KevinLalonde/Power_Selector/README.md

# Power_Selector
Ce circuit permet de pouvoir sélectionner quelle alimentation est envoyée au drone entre l'alimentation du sol et l'alimentation de la batterie
