KevinLalonde/Power_Selector/Rapports/ELE795_PresentationFinale.pdf

# PFE ELE795

Kevin Lalonde
Tristan Legault
Guyaume Morand

Conception d’un système d'alimentation continu pour drone Développé pour l’entreprise WINDO

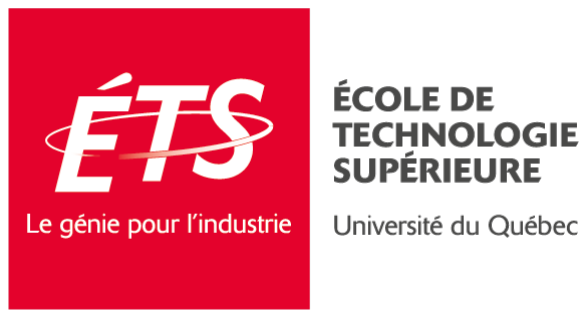
[picture p14: figure]

Département de génie électrique Supervisé par Jean-François Boland 9 août 2023

# Mise en contexte

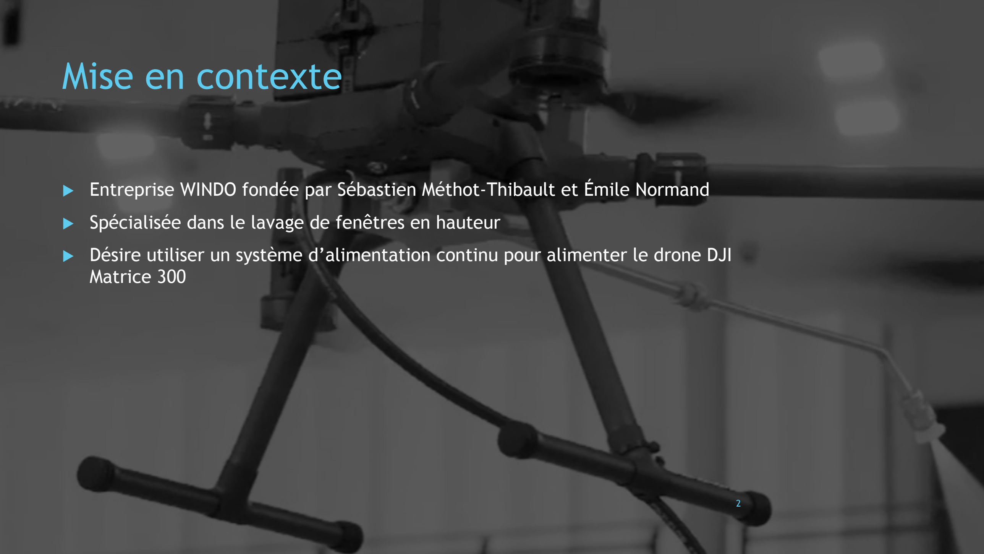
[picture p15: page 2]

u Entreprise WINDO fondée par Sébastien Méthot-Thibault et Émile Normand u Spécialisée dans le lavage de fenêtres en hauteur
u Désire utiliser un système d’alimentation continu pour alimenter le drone DJI Matrice 300

2

# Requis du système

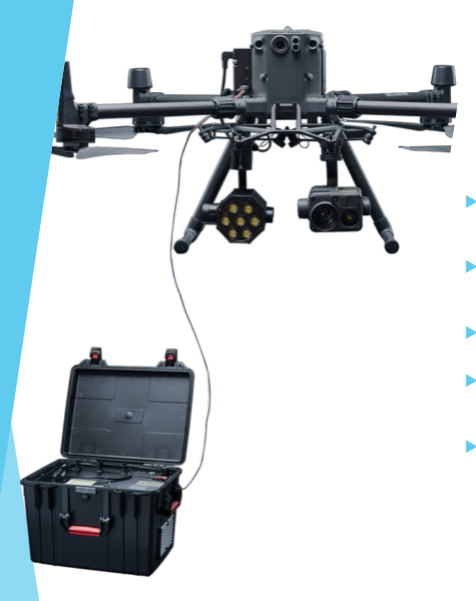
[picture p16: figure]

u Permet une distance d’opération de 100m de la borne d'alimentation au sol
u Doit être alimenté par les batteries en cas de perte d’alimentation du système
u Ajout de poids au drone le plus léger possible

u Coût du système moins élevé que les systèmes disponibles sur le marché
u Doit être alimenté sur le réseau électrique ou batteries avec onduleur (Tension d'entrée 120 à 240 VAC)

3

# Schéma fonctionnel

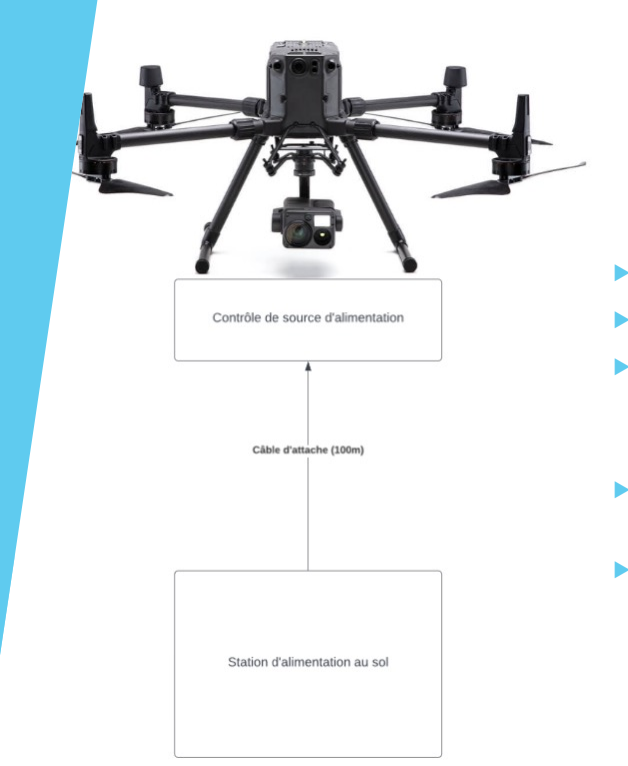
[picture p17: figure]

u Borne d'alimentation au sol
u Câble d'attache au drone (100m) u Contrôle d'alimentation (Station d'alimentation ou batteries)

u Alimentation primaire : 120 à 240 VAC
u Conversion à 50 VDC pour l'alimentation du drone

4

# Évaluation des différentes options

u Alimentation en continu entièrement à partir du sol
u Demande en courant trop élevée
u Tension fournie devrait tenir en compte les pertes ohmiques u Faible efficacitée du transfert d'énergie
u Alimentation AC au sol et convertisseur AC/DC sur le drone
u Poids ajouté au drone trop élevé
u Câble requiert un calibre AWG 12 ou 14 qui ajoute beaucoup de poids u Densité de puissance faible

5

## Systèmes d’alimentation existants

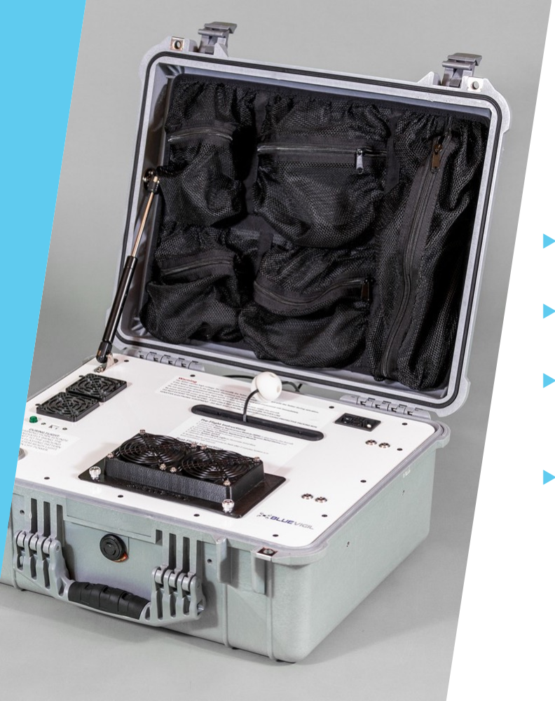
[picture p18: figure]

u Coût typique entre 10,000$ et 25,000$
u Très peu de documentation technique
u Convertisseur DC/DC 400VDC à 50VDC commun à la majorité des systèmes
u Exemple de système clé-en-main : Blue Vigil RS1000 Power Tether System

6

# Transport d'énergie

u Augmentation de la tension à 400 VDC
u Permet l'utilisation d'un câble de plus petit calibre afin de réduire le poids u Un plus petit courant réduit les pertes de puissance sur le long du câble

u Conversion 400 VDC à 50 VDC sur le drone
u Modules «BCM» existants permettent une très bonne densité de puissance u Fourni une alimentation stable au drone

7

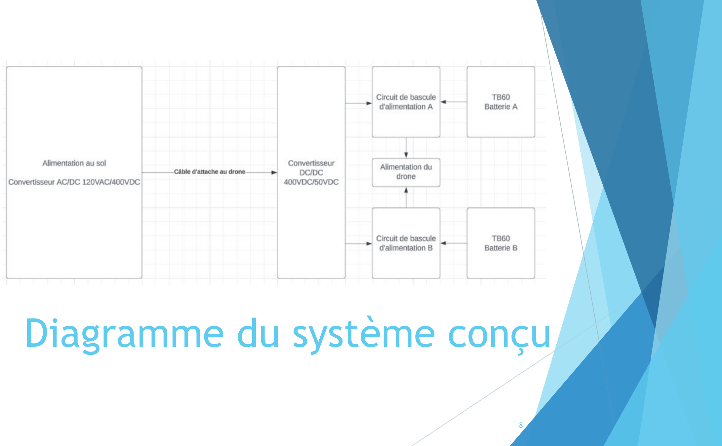
[picture p19: figure]
Diagramme du système conçu

# Rôle des

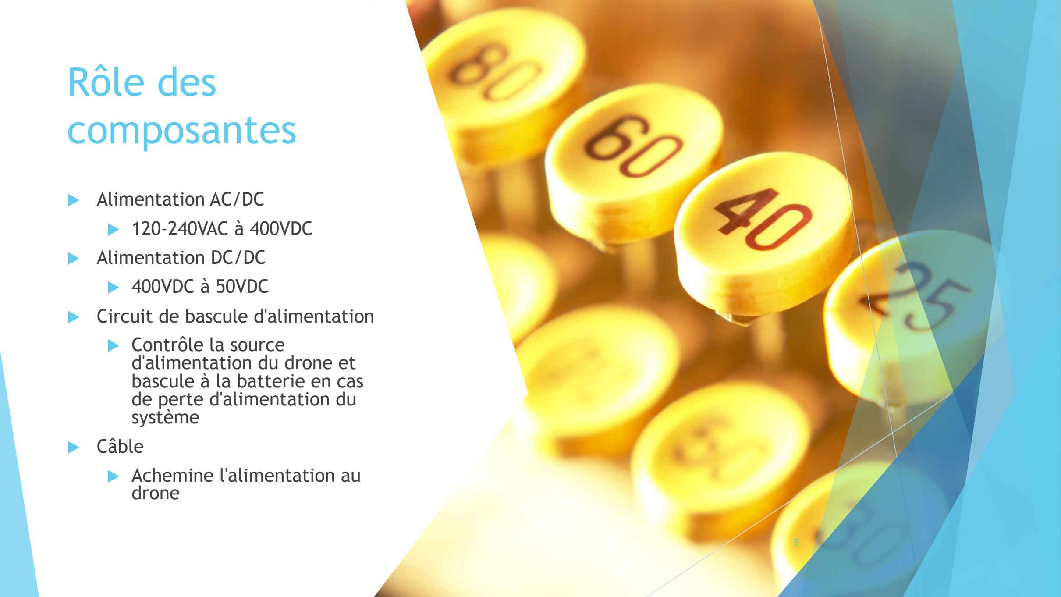
[picture p20: page 9]

composantes u Alimentation AC/DC u 120-240VAC à 400VDC u Alimentation DC/DC u 400VDC à 50VDC u Circuit de bascule d'alimentation u Contrôle la source

d'alimentation du drone et bascule à la batterie en cas de perte d'alimentation du système
u Câble u Achemine l'alimentation au

drone

9

# Alimentation AC/DC

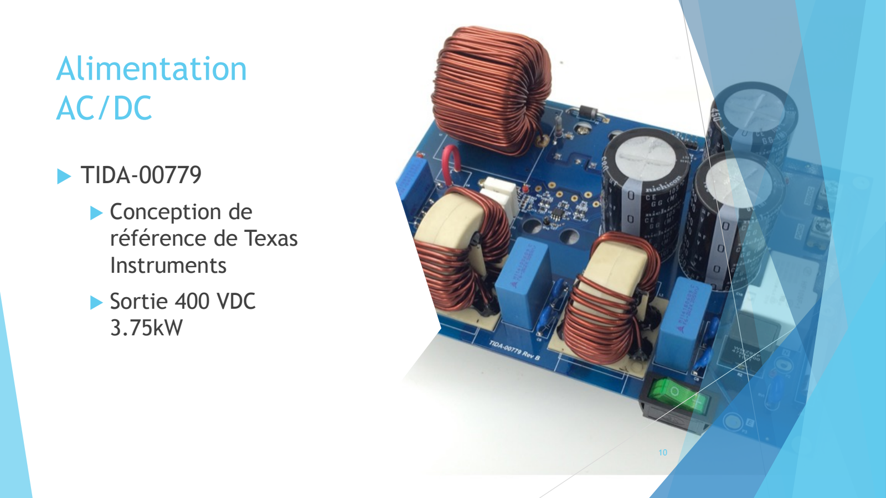
[picture p21: page 10]

## u TIDA-00779

## u Conception de référence de Texas Instruments u Sortie 400 VDC

3.75kW

10

# Alimentation DC/DC

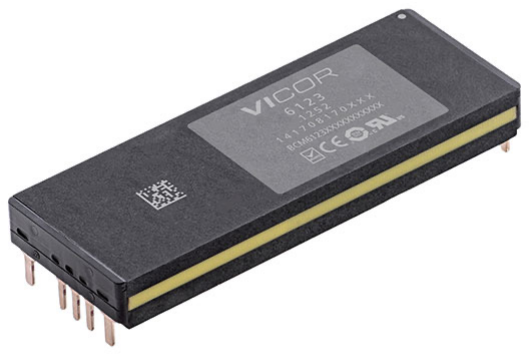
[picture p22: figure]

u Basée sur la
technologie «BCM» de
Vicor
u Entrée 400 VDC
u Sortie 50 VDC 1.75kW

11

# Circuit de bascule d'alimentation

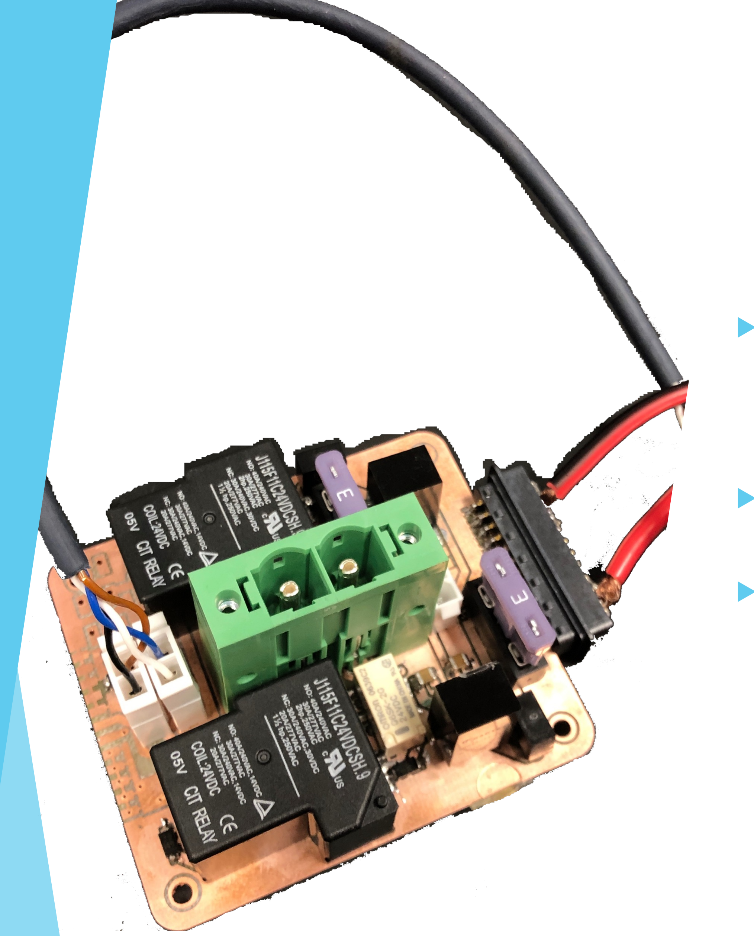
[picture p23: figure]

u Alimentation transférée à la batterie en permanence lors d’une perte d’alimentation du câble
u Bouton d’armament de
l’alimentation du câble au sol u Lumière indicatrice de perte d’alimentation

12

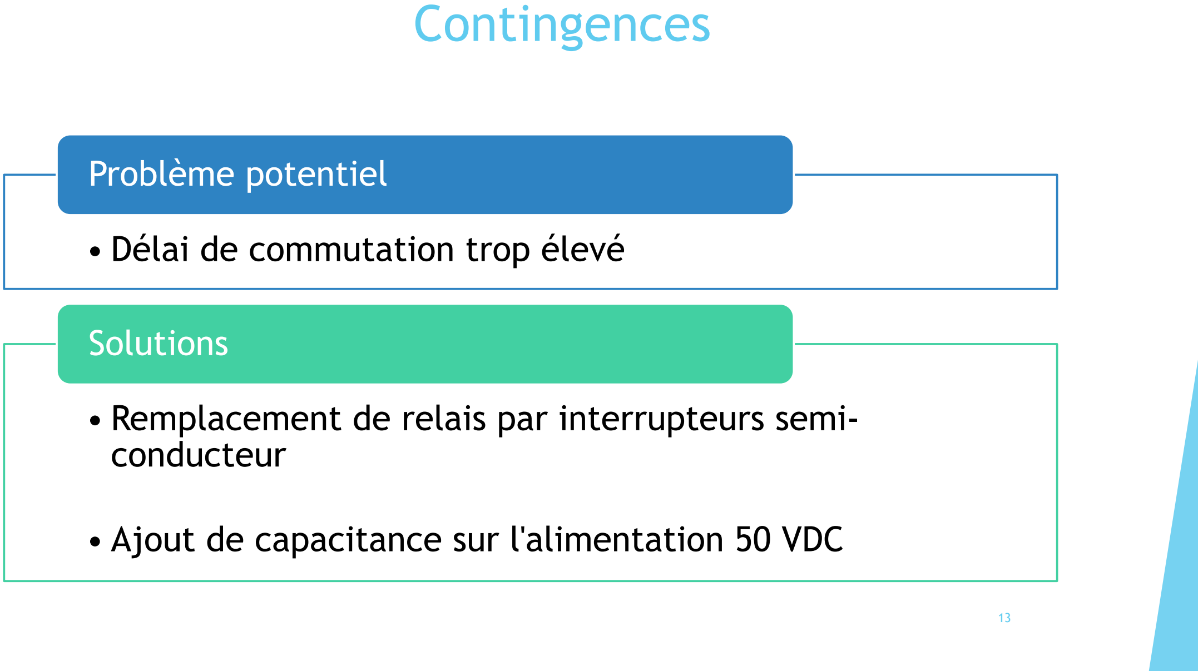
[picture p24: figure]
Contingences; • Délai de commutation trop élevé; Problème potentiel; conducteur; Solutions

## - Remplacement de relais par interrupteurs semi-

## - Ajout de capacitance sur l'alimentation 50 VDC

# Coût du système

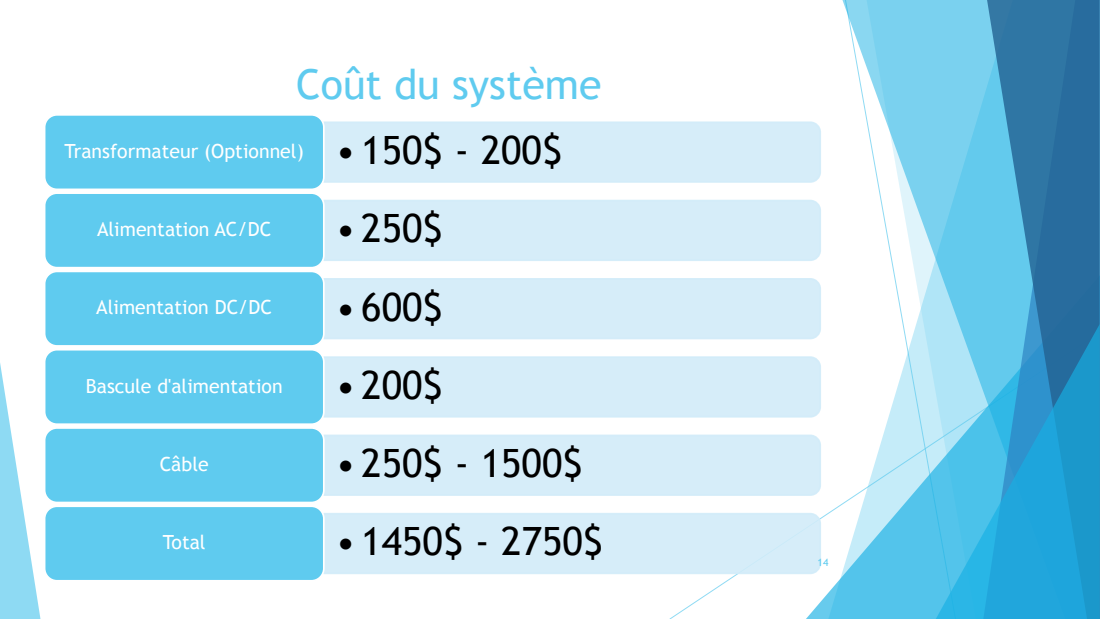
[picture p25: page 14]
Transformateur (Optionnel); Alimentation AC/DC; Alimentation DC/DC; Bascule d'alimentation; Câble; Total

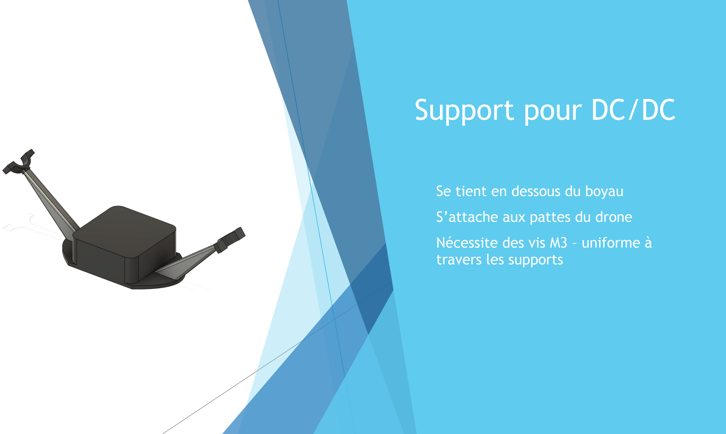
[picture p26: figure]
Support pour DC/DC; u Se tient en dessous du boyau; u S’attache aux pattes du drone; u Nécessite des vis M3 – uniforme à travers les supports

# Support pour bascule d’alimentation

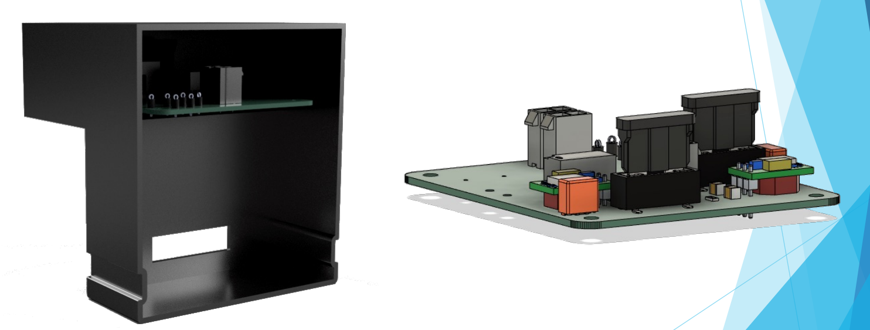
[picture p27: figure]

16

# Centre de gravité

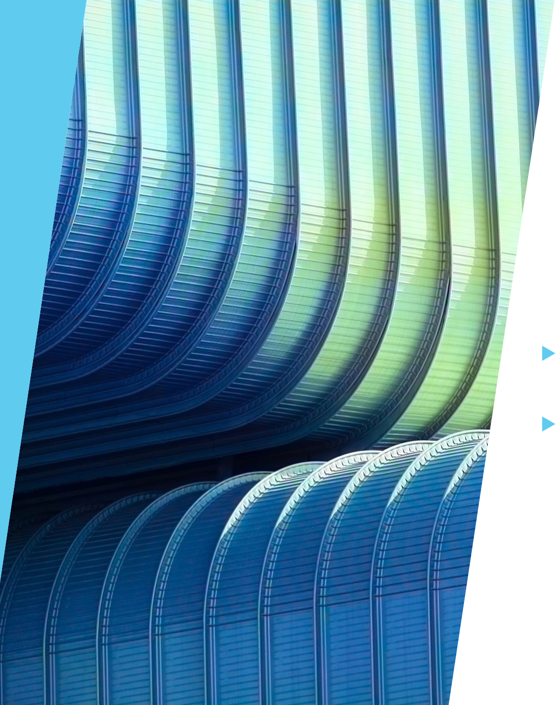
[picture p28: figure]

u Système conçu afin d'avoir un impact négligeable
u Boyau d'arrosage peut être ajusté afin de compenser au besoin

17

# Aperçu du système complet

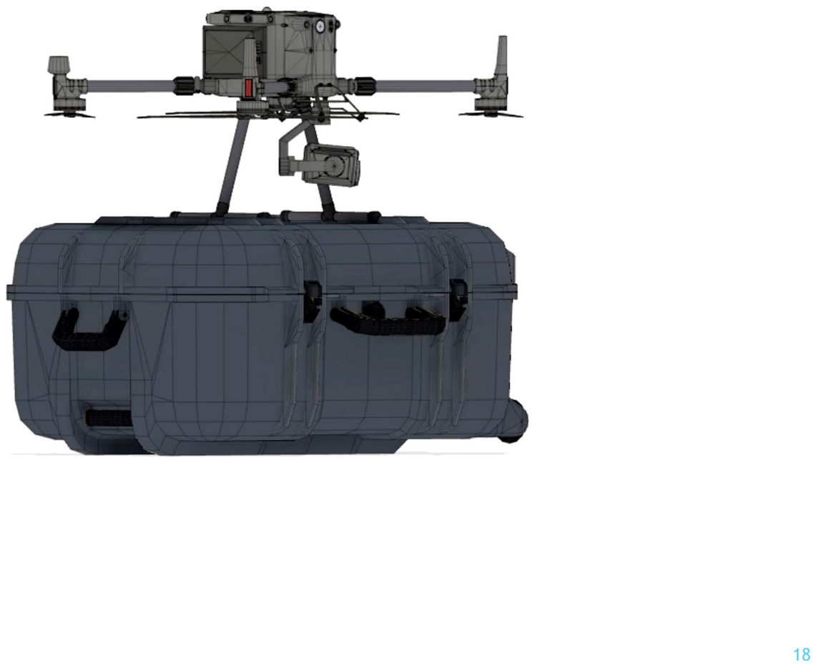
[picture p29: page 18]

18

# Éléments à valider pour l'implémentation finale

u Les connecteurs propriétaires
u L’alimentation du drone par déconnexion de la batterie du drone tout en gardant la communication
u La déconnexion temporaire de l’alimentation
u Le déplacement du centre de gravité du drone (par la batterie)
u Le système d’attache au drone

19

# Conclusion

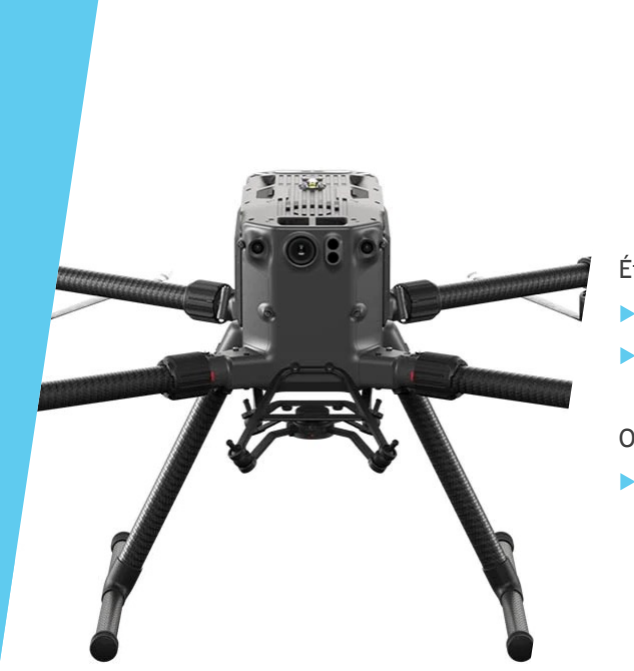
[picture p30: figure]

État du projet:
u Conception du système complétée u Validation du système à compléter

Observations:
u Peu de documentation sur les systèmes existants

20

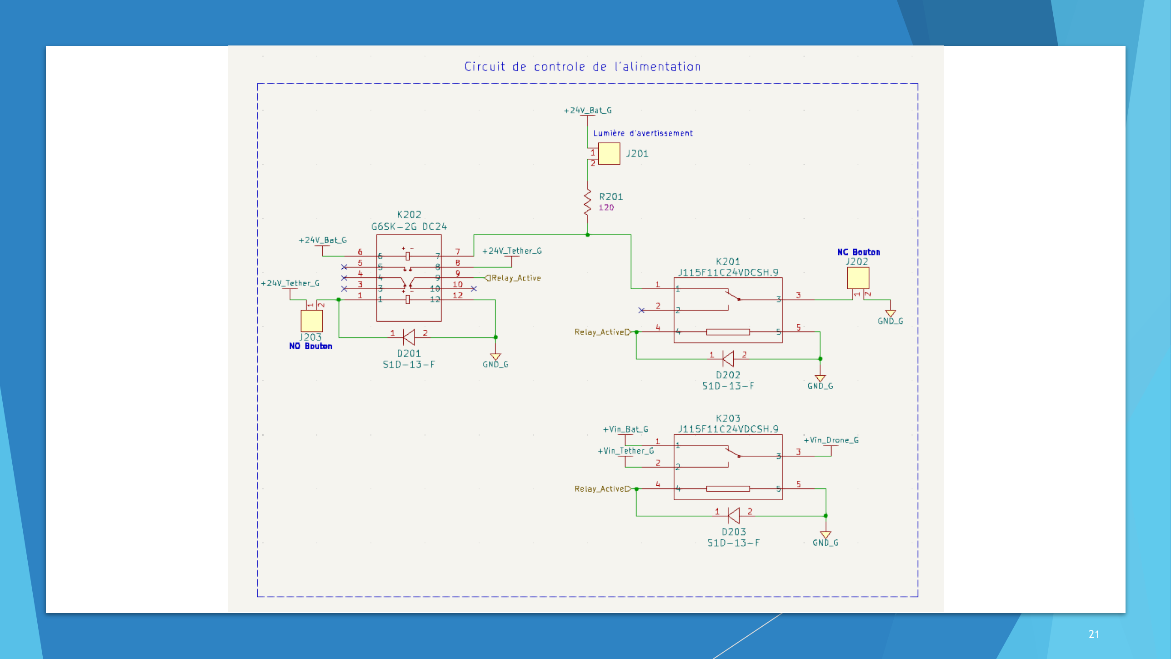
[picture p31: page 21]

21
