KevinLalonde/Power_Selector/KiCad_Library/3D_Model/Assembly/ACZ11BR4E.step

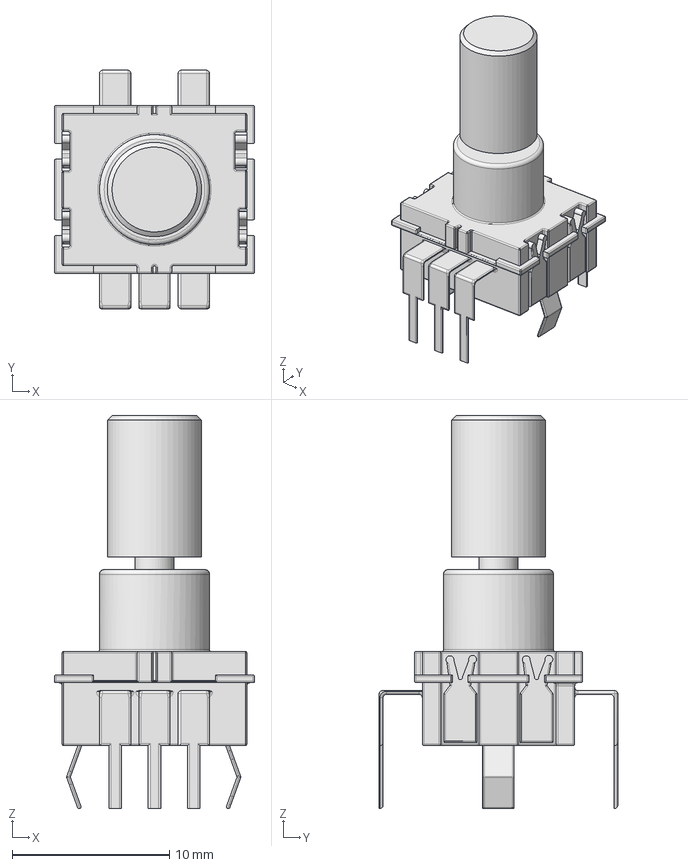
[picture p33: CAD file, 2023-07-19]
KiCad_Library/3D_Model/Assembly/ACZ11BR4E.step
12.8 x 15.2 x 25.0 mm
