KevinLalonde/Power_Selector/KiCad_Library/3D_Model/Capacitors/C1210.step

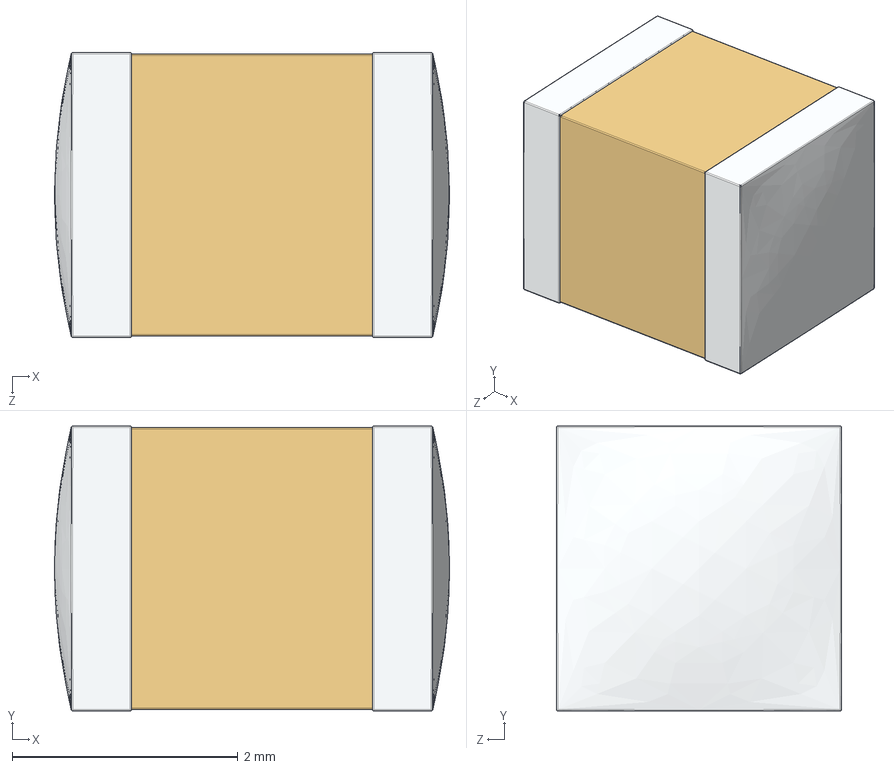
[picture p34: CAD file, 2023-07-19]
KiCad_Library/3D_Model/Capacitors/C1210.step
3.50 x 2.52 x 2.53 mm
