KevinLalonde/Power_Selector/KiCad_Library/3D_Model/Crystals/TXC 7A Series.step

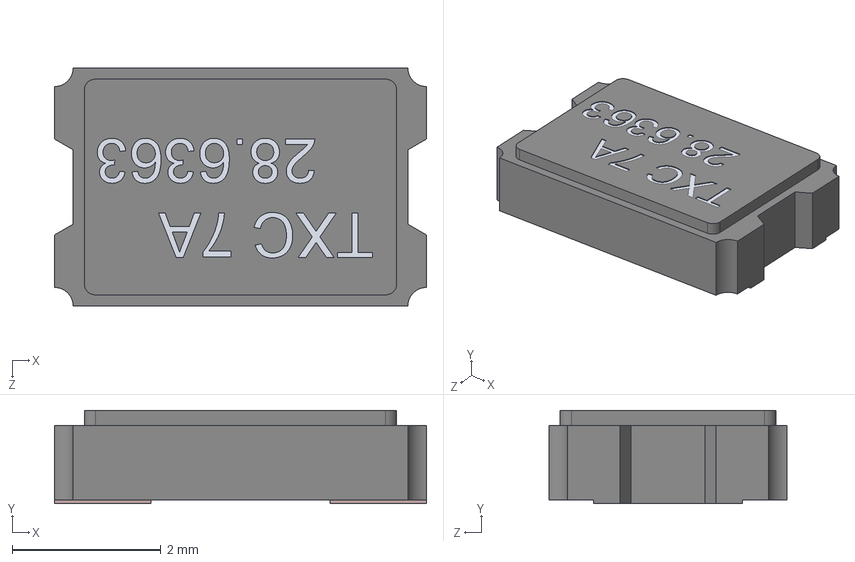
[picture p35: CAD file, 2023-07-19]
KiCad_Library/3D_Model/Crystals/TXC 7A Series.step
5.00 x 1.25 x 3.20 mm
