KevinLalonde/Power_Selector/KiCad_Library/3D_Model/Diodes/SOT143-4L.stp

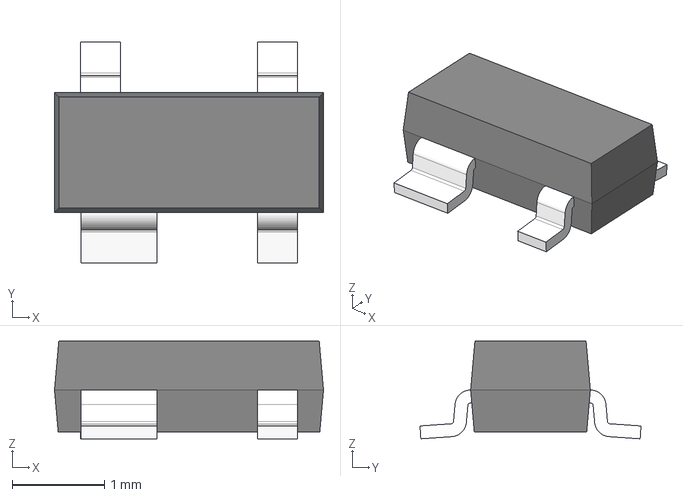
[picture p36: CAD file, 2023-07-19]
KiCad_Library/3D_Model/Diodes/SOT143-4L.stp
2.92 x 2.40 x 1.06 mm
