KevinLalonde/Power_Selector/KiCad_Library/3D_Model/Filter/FB-0603.stp

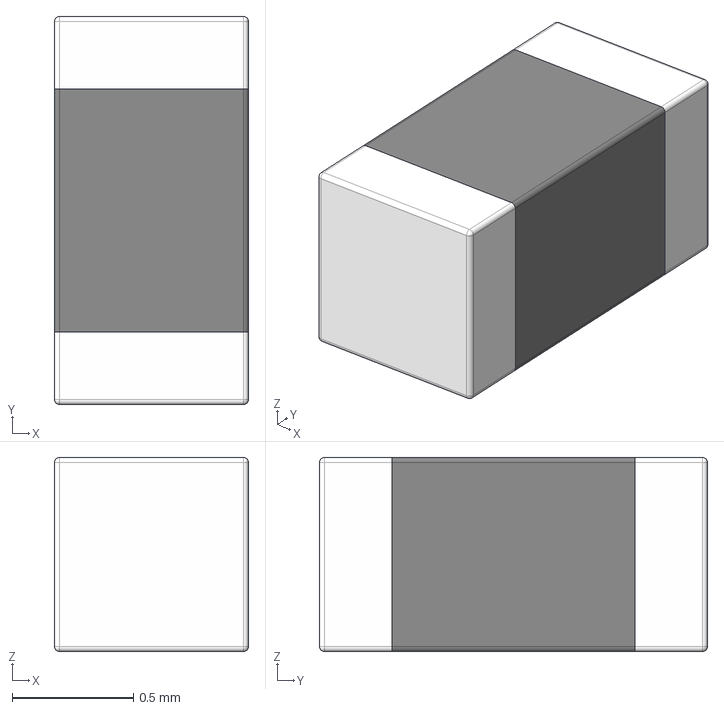
[picture p37: CAD file, 2023-07-19]
KiCad_Library/3D_Model/Filter/FB-0603.stp
0.8 x 1.60 x 0.8 mm
