KevinLalonde/Power_Selector/KiCad_Library/3D_Model/Fuses/Littelfuse_562.stp

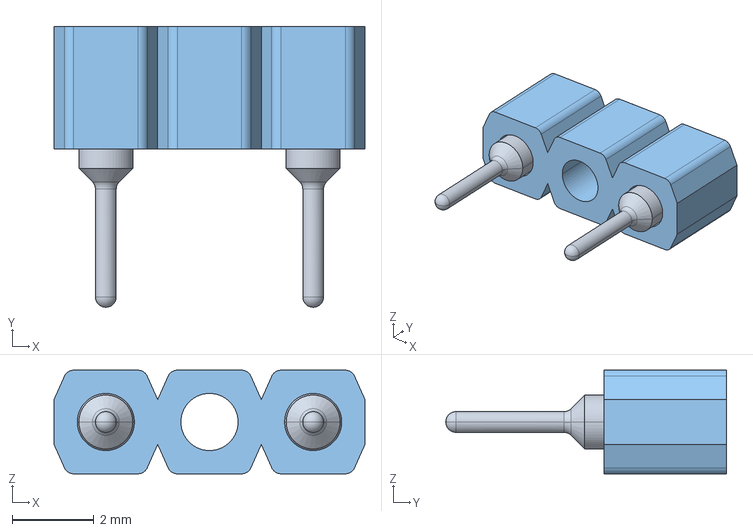
[picture p38: CAD file, 2023-07-19]
KiCad_Library/3D_Model/Fuses/Littelfuse_562.stp
7.62 x 6.88 x 2.54 mm
