KevinLalonde/Power_Selector/KiCad_Library/3D_Model/IC/SOIC-14.step

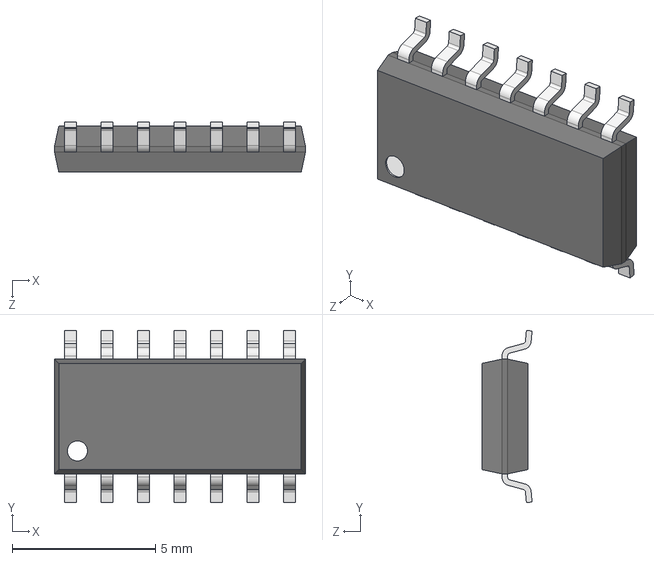
[picture p39: CAD file, 2023-07-19]
KiCad_Library/3D_Model/IC/SOIC-14.step
8.75 x 6.00 x 1.75 mm
