KevinLalonde/Power_Selector/KiCad_Library/3D_Model/Inductors/I1206.step

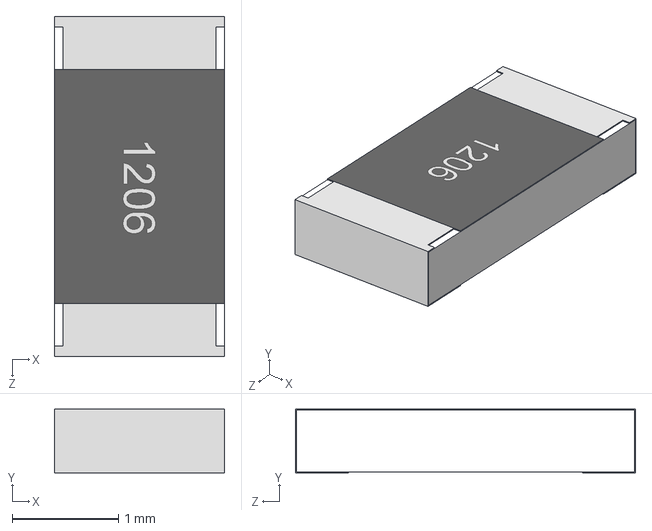
[picture p40: CAD file, 2023-07-19]
KiCad_Library/3D_Model/Inductors/I1206.step
1.60 x 0.6 x 3.20 mm
