KevinLalonde/Power_Selector/KiCad_Library/3D_Model/Relays/G6SK_2G.step

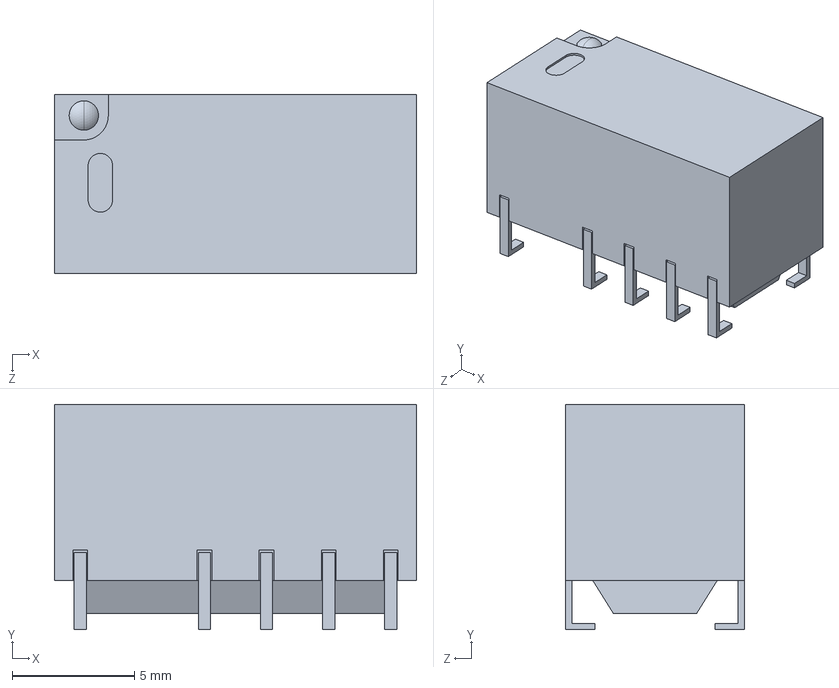
[picture p41: CAD file, 2023-07-21]
KiCad_Library/3D_Model/Relays/G6SK_2G.step
14.8 x 9.20 x 7.30 mm
