KevinLalonde/Power_Selector/KiCad_Library/3D_Model/Resistors/R2512.step

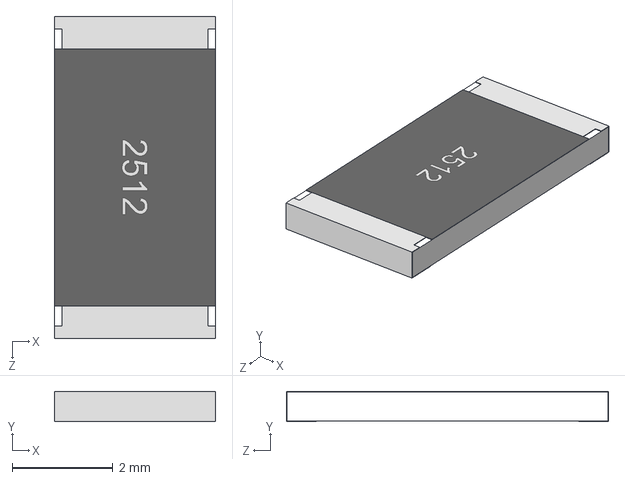
[picture p42: CAD file, 2023-07-19]
KiCad_Library/3D_Model/Resistors/R2512.step
3.20 x 0.6 x 6.40 mm
