KevinLalonde/Power_Selector/KiCad_Library/3D_Model/Switches/K12PBK15N.step

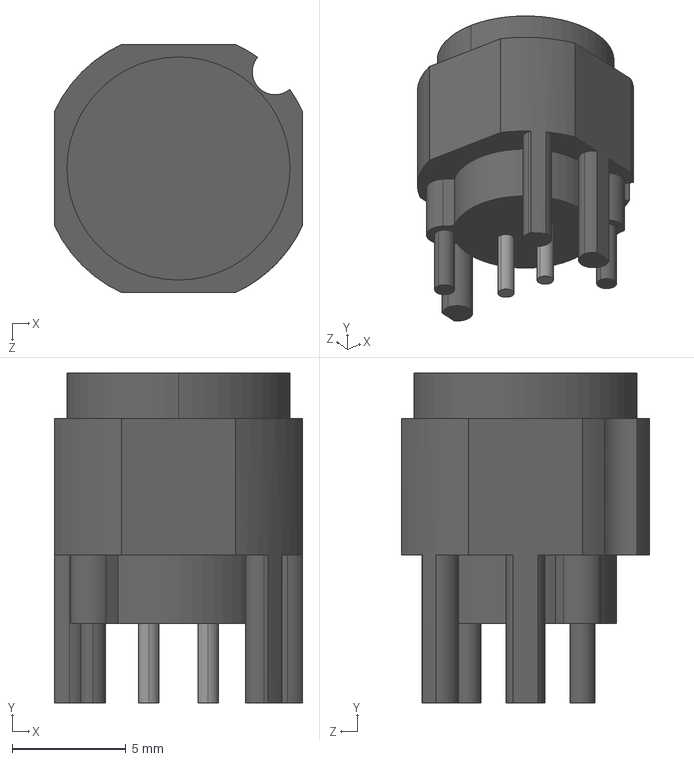
[picture p43: CAD file, 2023-07-19]
KiCad_Library/3D_Model/Switches/K12PBK15N.step
10.9 x 14.5 x 10.9 mm
