KevinLalonde/Power_Selector/KiCad_Library/3D_Model/Assembly/ACZ09BRXE.STEP

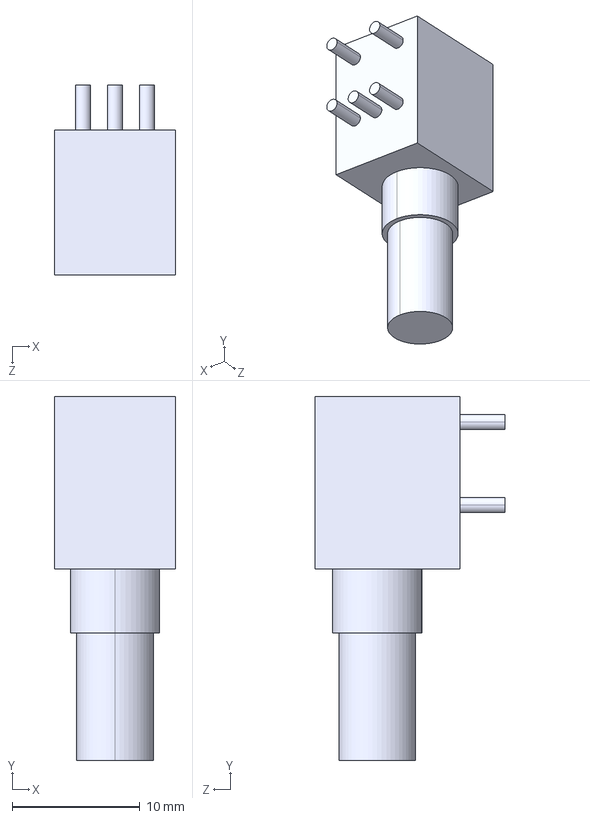
[picture p44: CAD file, 2023-07-19]
KiCad_Library/3D_Model/Assembly/ACZ09BRXE.STEP
9.50 x 28.5 x 14.8 mm
