KevinLalonde/Power_Selector/KiCad_Library/3D_Model/Capacitors/C0603.stp

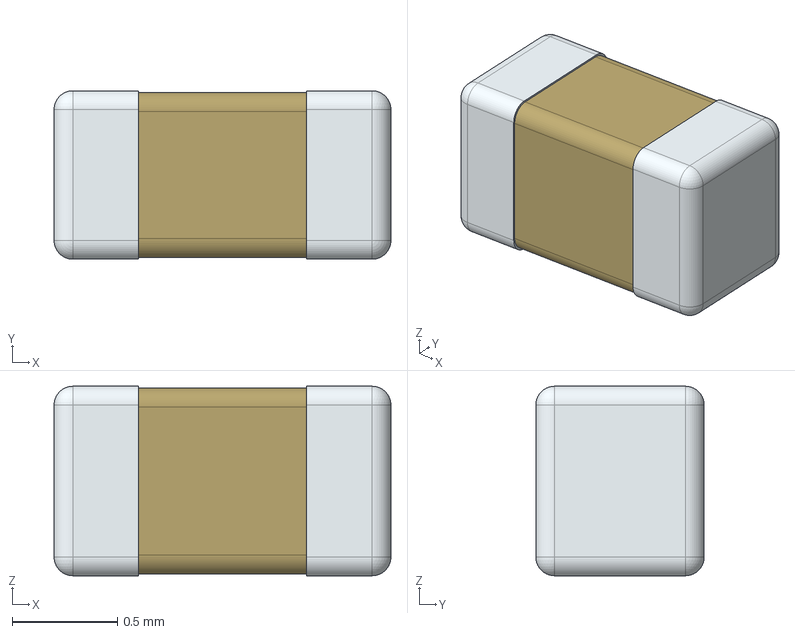
[picture p45: CAD file, 2023-07-19]
KiCad_Library/3D_Model/Capacitors/C0603.stp
1.60 x 0.8 x 0.9 mm
