KevinLalonde/Power_Selector/KiCad_Library/3D_Model/Crystals/HC49_US.step

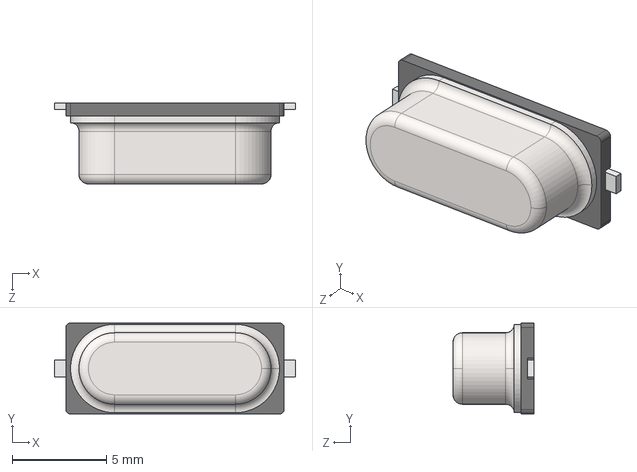
[picture p46: CAD file, 2023-07-19]
KiCad_Library/3D_Model/Crystals/HC49_US.step
12.8 x 4.83 x 4.30 mm
