KevinLalonde/Power_Selector/KiCad_Library/3D_Model/Diodes/TO-220-2.step

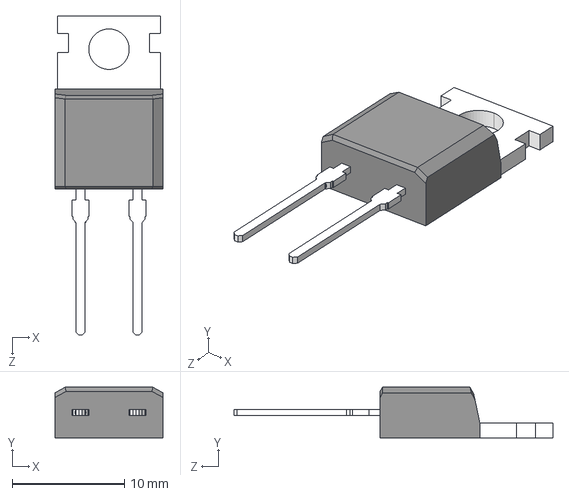
[picture p47: CAD file, 2023-07-19]
KiCad_Library/3D_Model/Diodes/TO-220-2.step
9.65 x 4.50 x 28.4 mm
