KevinLalonde/Power_Selector/KiCad_Library/3D_Model/Filter/WE-CNSW-0603.stp

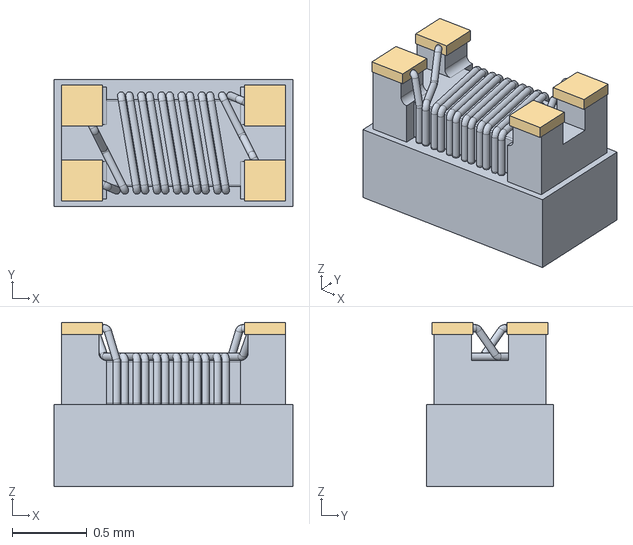
[picture p48: CAD file, 2023-07-19]
KiCad_Library/3D_Model/Filter/WE-CNSW-0603.stp
1.60 x 0.85 x 1.10 mm
