KevinLalonde/Power_Selector/KiCad_Library/3D_Model/Fuses/ATO_BLADE_FUSE.STEP

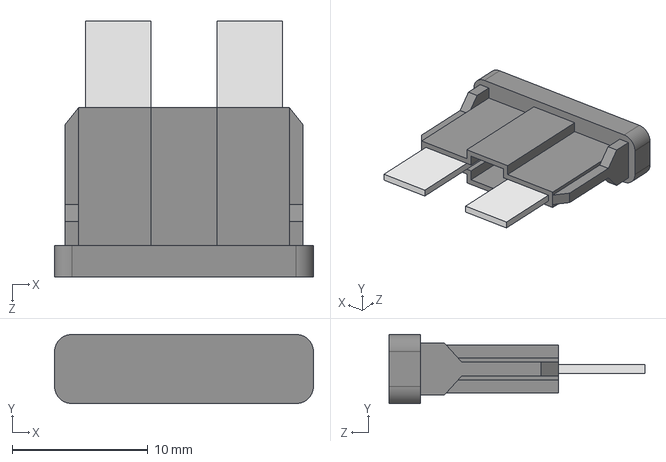
[picture p49: CAD file, 2023-07-19]
KiCad_Library/3D_Model/Fuses/ATO_BLADE_FUSE.STEP
19.0 x 5.08 x 18.8 mm
