KevinLalonde/Power_Selector/KiCad_Library/3D_Model/IC/VSSOP-8.step

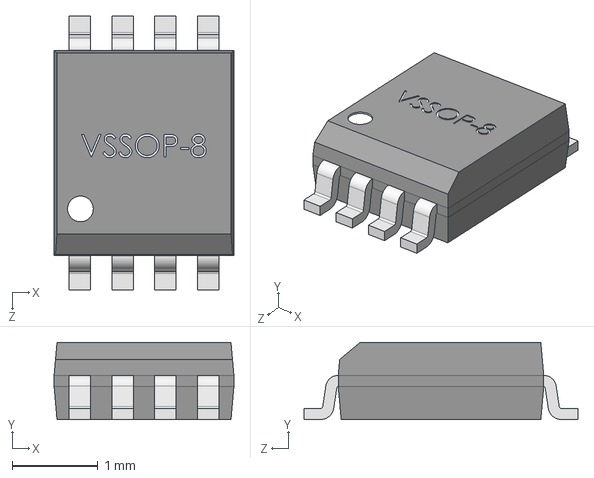
[picture p50: CAD file, 2023-07-19]
KiCad_Library/3D_Model/IC/VSSOP-8.step
2.10 x 0.9 x 3.20 mm
