KevinLalonde/Power_Selector/KiCad_Library/3D_Model/Inductors/WE-TPC-SMD.stp

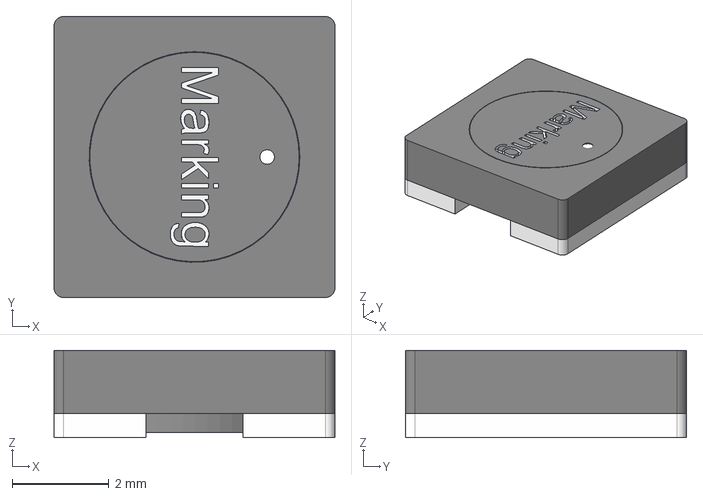
[picture p51: CAD file, 2023-07-19]
KiCad_Library/3D_Model/Inductors/WE-TPC-SMD.stp
5.80 x 5.80 x 1.80 mm
