KevinLalonde/Power_Selector/KiCad_Library/3D_Model/Relays/c-9-1393792-9-c-3d.stp

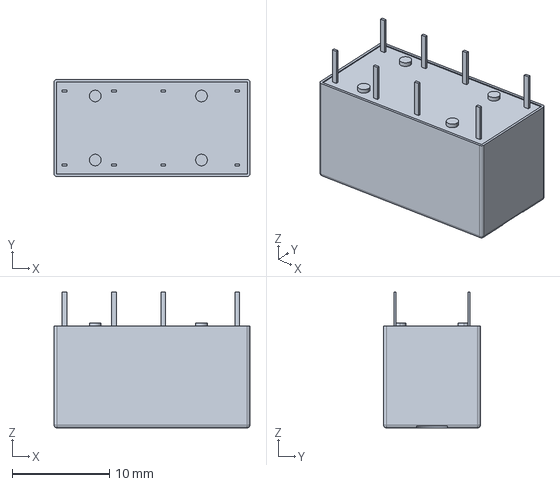
[picture p52: CAD file, 2023-07-19]
KiCad_Library/3D_Model/Relays/c-9-1393792-9-c-3d.stp
20.2 x 10.0 x 14.0 mm
