KevinLalonde/Power_Selector/KiCad_Library/3D_Model/Resistors/67W.step

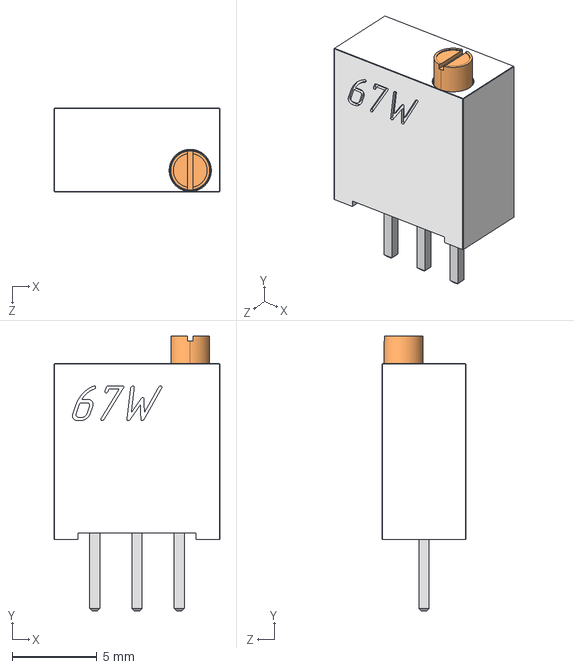
[picture p53: CAD file, 2023-07-19]
KiCad_Library/3D_Model/Resistors/67W.step
9.80 x 16.3 x 4.95 mm
