KevinLalonde/Power_Selector/KiCad_Library/3D_Model/Assembly/mps_dcdc_oki_78sr_vert_a.step

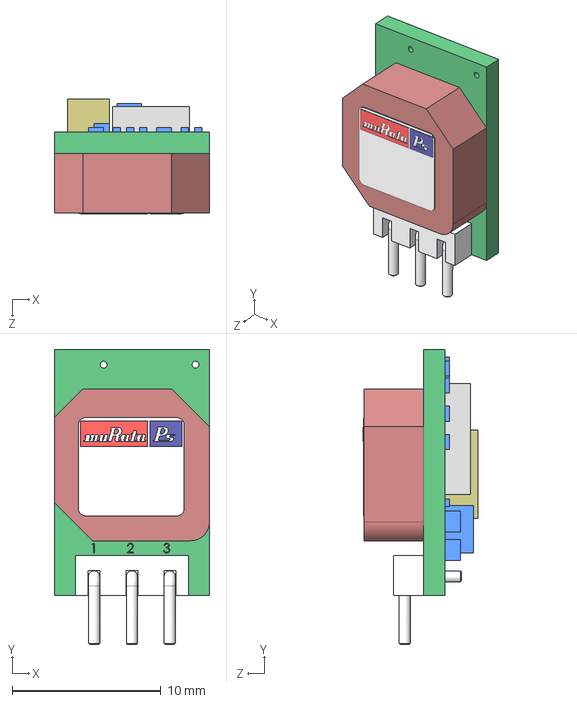
[picture p54: CAD file, 2023-07-19]
KiCad_Library/3D_Model/Assembly/mps_dcdc_oki_78sr_vert_a.step
10.4 x 19.8 x 7.73 mm
