KevinLalonde/Power_Selector/KiCad_Library/3D_Model/Capacitors/E-CAP 1500UF_SUNCON.STEP

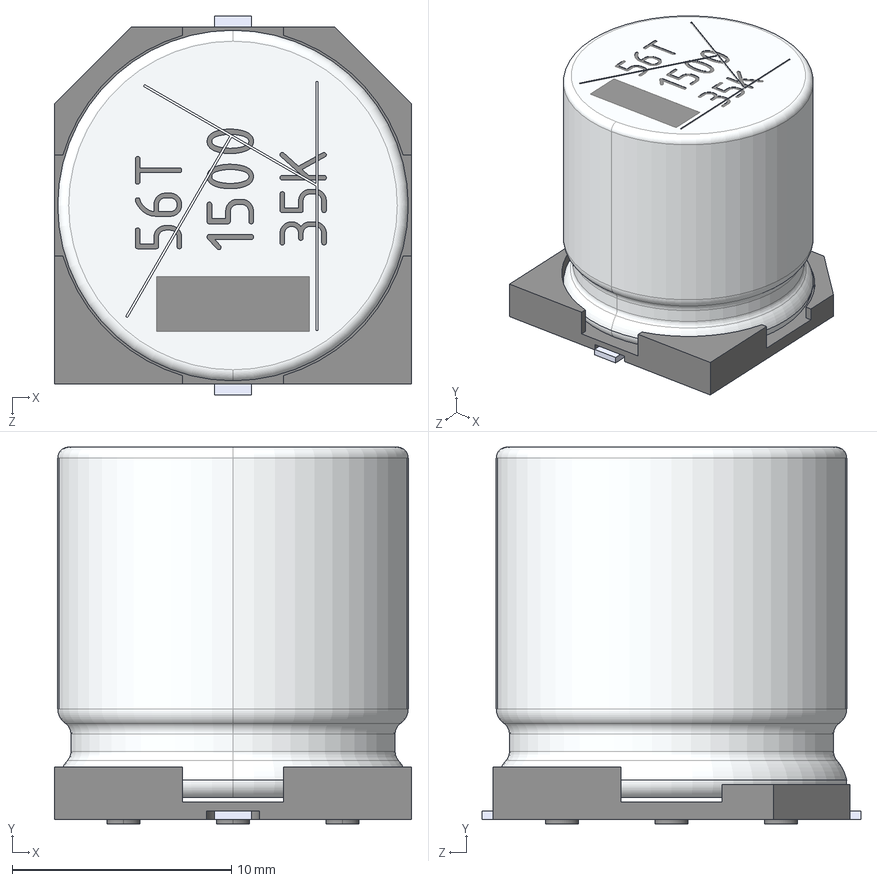
[picture p55: CAD file, 2023-07-19]
KiCad_Library/3D_Model/Capacitors/E-CAP 1500UF_SUNCON.STEP
16.3 x 17.2 x 17.3 mm
