KevinLalonde/Power_Selector/KiCad_Library/3D_Model/Crystals/ABS25.STEP

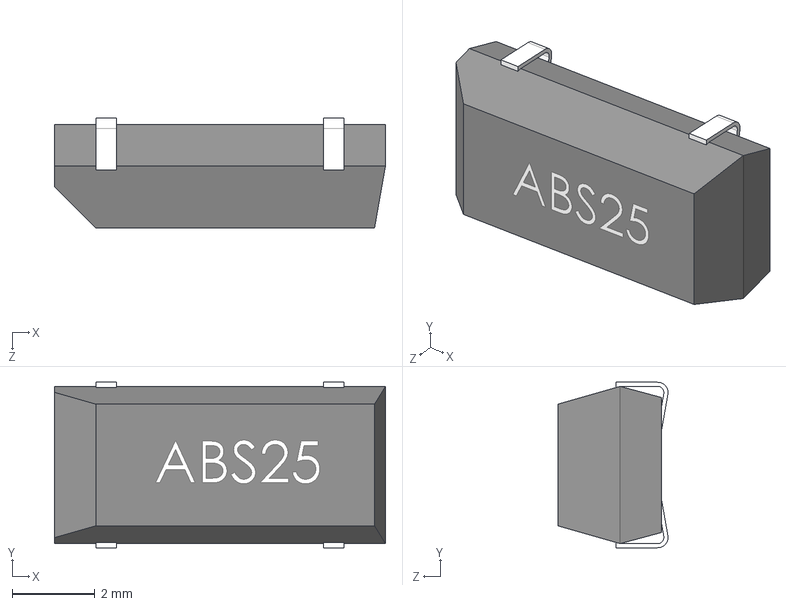
[picture p57: CAD file, 2023-07-19]
KiCad_Library/3D_Model/Crystals/ABS25.STEP
8.00 x 4.00 x 2.66 mm
