KevinLalonde/Power_Selector/KiCad_Library/3D_Model/Diodes/WL_SMCW-0805_RED.stp

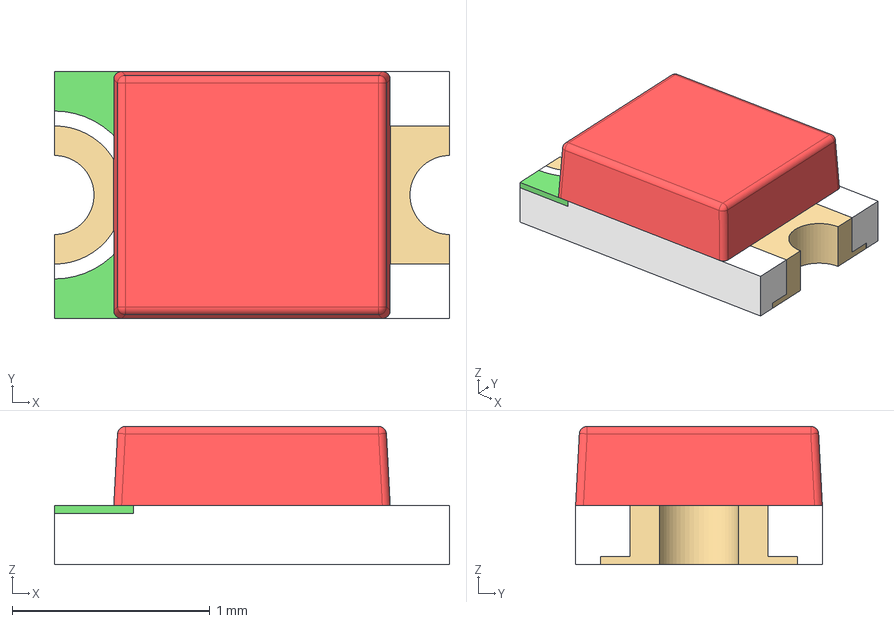
[picture p58: CAD file, 2023-07-19]
KiCad_Library/3D_Model/Diodes/WL_SMCW-0805_RED.stp
2.00 x 1.25 x 0.7 mm
base
marking x 2
base_2
housing
cover
