KevinLalonde/Power_Selector/KiCad_Library/3D_Model/Fuses/Littelfuse_TE5_395.step

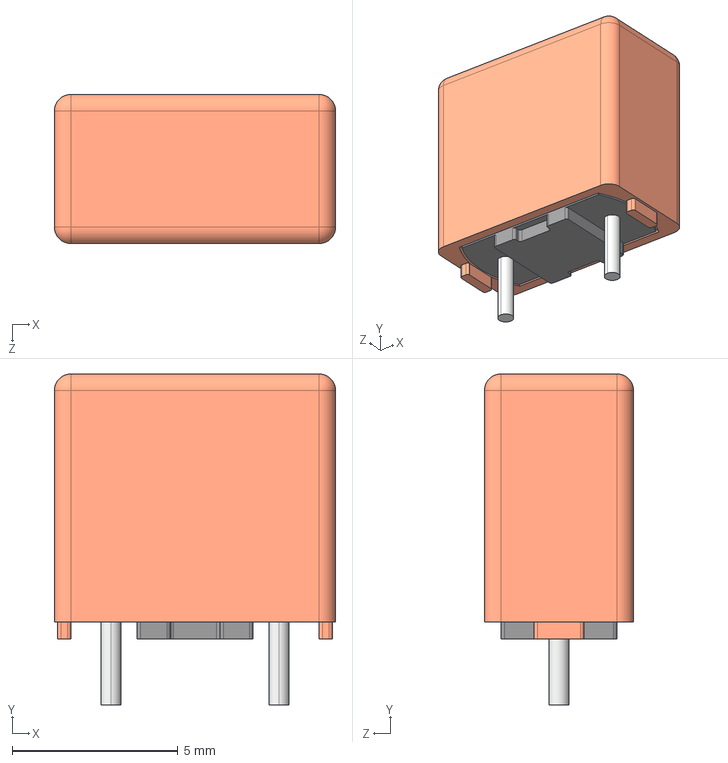
[picture p59: CAD file, 2023-07-19]
KiCad_Library/3D_Model/Fuses/Littelfuse_TE5_395.step
8.50 x 10.0 x 4.50 mm
