KevinLalonde/Power_Selector/KiCad_Library/3D_Model/Inductors/LBC3225.stp

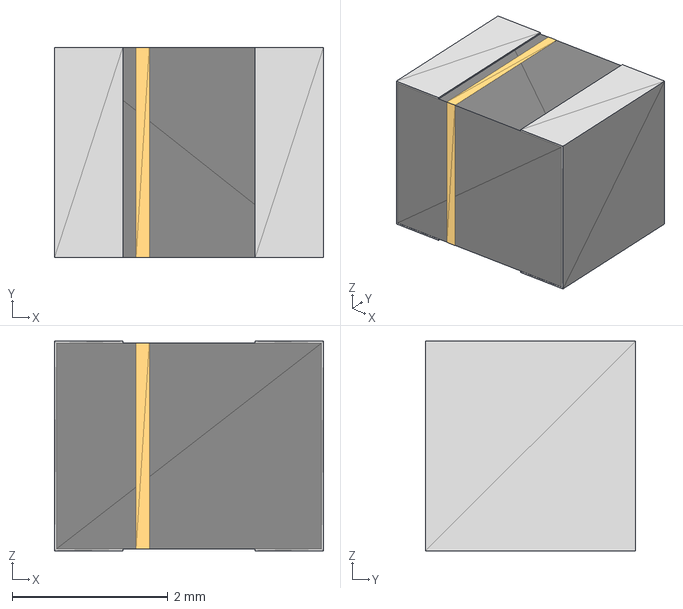
[picture p60: CAD file, 2023-07-19]
KiCad_Library/3D_Model/Inductors/LBC3225.stp
3.45 x 2.70 x 2.69 mm
