KevinLalonde/Power_Selector/KiCad_Library/3D_Model/Relays/adw11・・hlw.igs

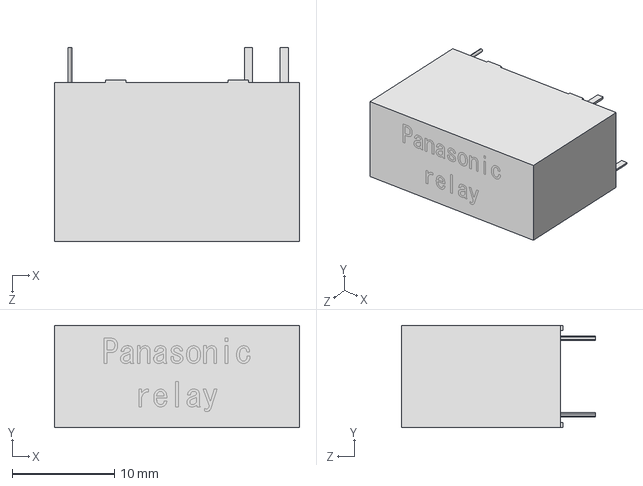
[picture p61: CAD file, 2023-07-19]
KiCad_Library/3D_Model/Relays/adw11・・hlw.igs
24.0 x 10.0 x 19.0 mm
