KevinLalonde/Power_Selector/KiCad_Library/3D_Model/Resistors/R0402.step

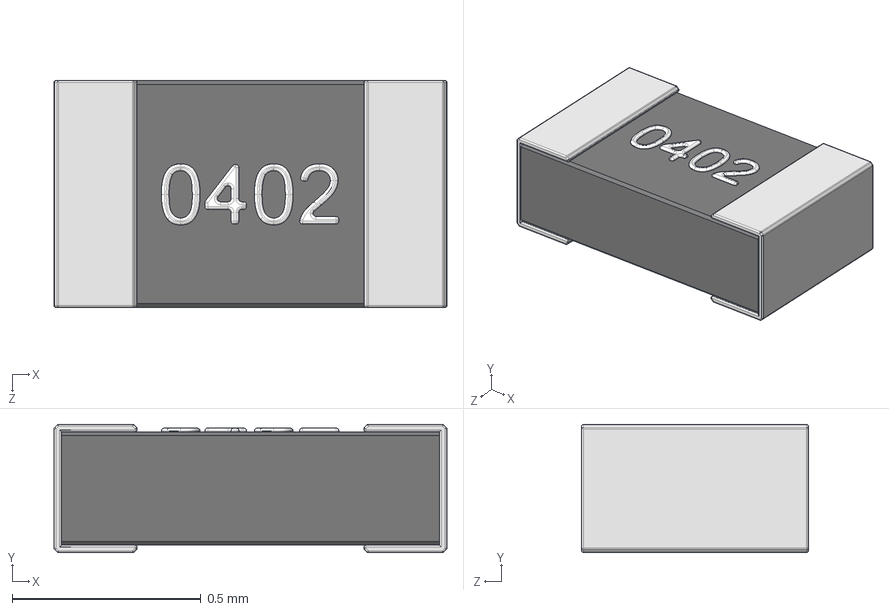
[picture p62: CAD file, 2023-07-19]
KiCad_Library/3D_Model/Resistors/R0402.step
1.04 x 0.34 x 0.6 mm
