KevinLalonde/Power_Selector/KiCad_Library/3D_Model/Switches/Tactile_switch_6x6x5mm.step

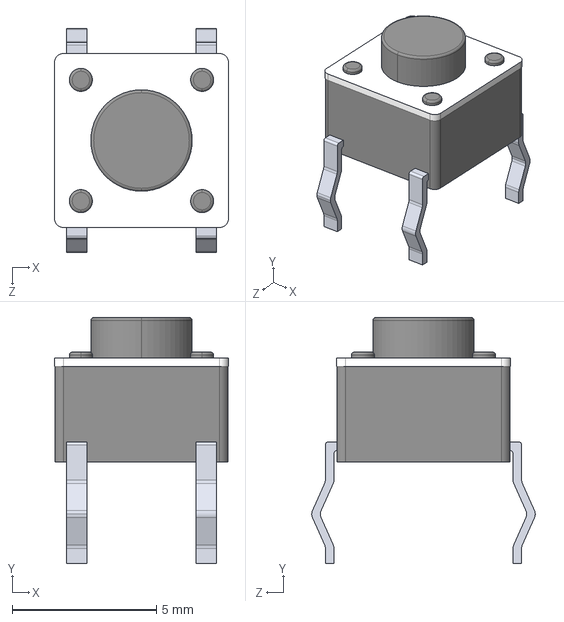
[picture p63: CAD file, 2023-07-19]
KiCad_Library/3D_Model/Switches/Tactile_switch_6x6x5mm.step
6.03 x 8.52 x 7.74 mm
