KevinLalonde/Power_Selector/KiCad_Library/3D_Model/Assembly/mps_dcdc_oki_78sr_horiz_a.step

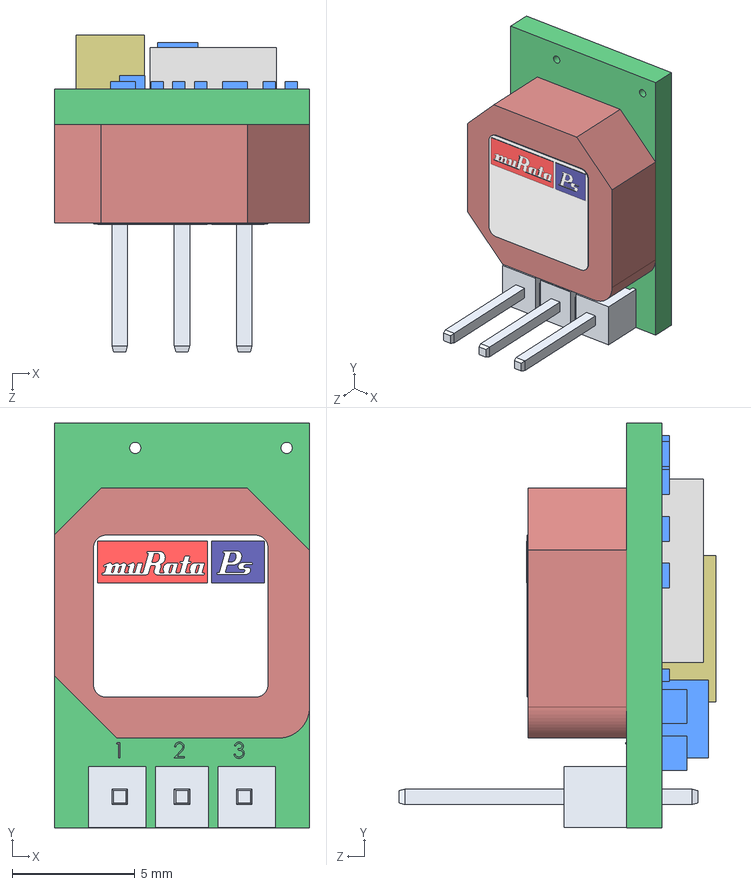
[picture p64: CAD file, 2023-07-19]
KiCad_Library/3D_Model/Assembly/mps_dcdc_oki_78sr_horiz_a.step
10.4 x 16.5 x 12.9 mm
