KevinLalonde/Power_Selector/KiCad_Library/3D_Model/Capacitors/CAP_SLPX_C1_CND.step

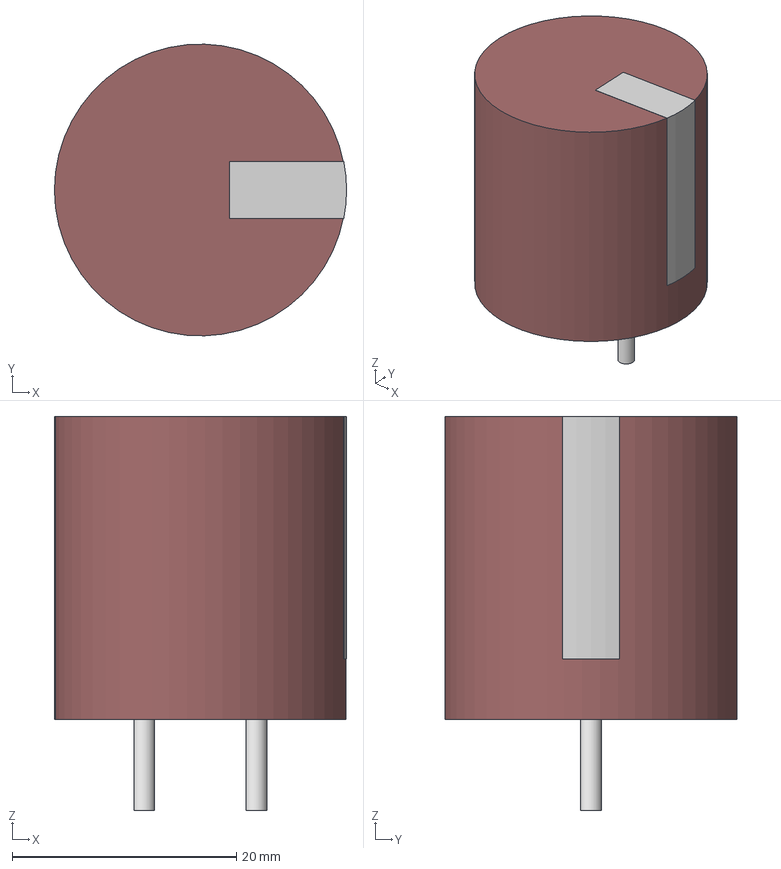
[picture p65: CAD file, 2023-07-19]
KiCad_Library/3D_Model/Capacitors/CAP_SLPX_C1_CND.step
26.0 x 26.0 x 35.1 mm
