KevinLalonde/Power_Selector/KiCad_Library/3D_Model/Connectors/male_header_2_54_1X37.step

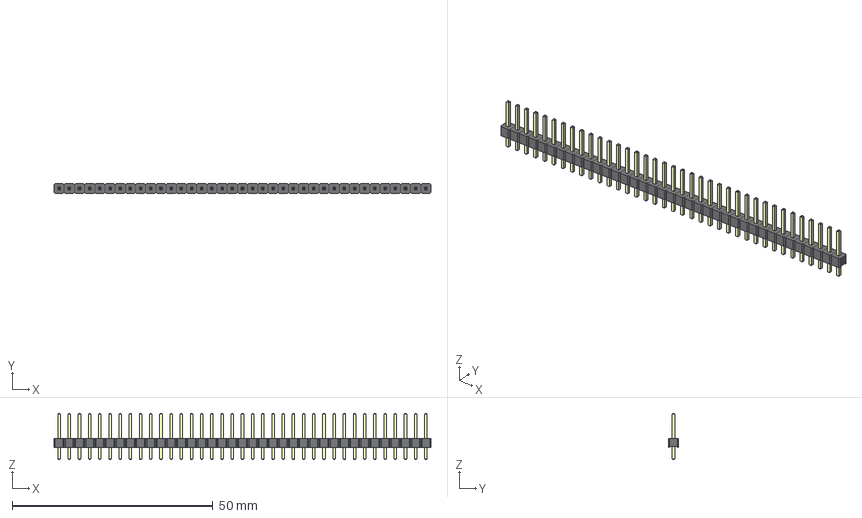
[picture p66: CAD file, 2023-07-19]
KiCad_Library/3D_Model/Connectors/male_header_2_54_1X37.step
94.0 x 2.49 x 11.5 mm
User_Library-Header_Male_40Pin_BodyArray033
User_Library-Header_Male_40Pin_PinArray032
User_Library-Header_Male_40Pin_PinArray039
User_Library-Header_Male_40Pin_PinArray026
User_Library-Header_Male_40Pin_PinArray006
User_Library-Header_Male_40Pin_PinArray029
User_Library-Header_Male_40Pin_PinArray008
User_Library-Header_Male_40Pin_PinArray033
User_Library-Header_Male_40Pin_PinArray021
User_Library-Header_Male_40Pin_PinArray022
User_Library-Header_Male_40Pin_PinArray009
User_Library-Header_Male_40Pin_PinArray034
User_Library-Header_Male_40Pin_PinArray015
User_Library-Header_Male_40Pin_PinArray014
User_Library-Header_Male_40Pin_PinArray023
User_Library-Header_Male_40Pin_PinArray025
User_Library-Header_Male_40Pin_PinArray027
User_Library-Header_Male_40Pin_PinArray035
User_Library-Header_Male_40Pin_PinArray037
User_Library-Header_Male_40Pin_PinArray036
User_Library-Header_Male_40Pin_PinArray038
User_Library-Header_Male_40Pin_PinArray024
User_Library-Header_Male_40Pin_PinArray028
User_Library-Header_Male_40Pin_PinArray018
User_Library-Header_Male_40Pin_PinArray017
User_Library-Header_Male_40Pin_PinArray031
User_Library-Header_Male_40Pin_PinArray016
User_Library-Header_Male_40Pin_PinArray013
User_Library-Header_Male_40Pin_PinArray010
User_Library-Header_Male_40Pin_PinArray020
User_Library-Header_Male_40Pin_PinArray019
User_Library-Header_Male_40Pin_BodyArray006
User_Library-Header_Male_40Pin_BodyArray023
User_Library-Header_Male_40Pin_BodyArray039
User_Library-Header_Male_40Pin_PinArray003
User_Library-Header_Male_40Pin_BodyArray025
User_Library-Header_Male_40Pin_BodyArray015
User_Library-Header_Male_40Pin_BodyArray002
User_Library-Header_Male_40Pin_BodyArray016
User_Library-Header_Male_40Pin_BodyArray027
User_Library-Header_Male_40Pin_BodyArray020
User_Library-Header_Male_40Pin_BodyArray019
User_Library-Header_Male_40Pin_BodyArray009
User_Library-Header_Male_40Pin_BodyArray022
User_Library-Header_Male_40Pin_BodyArray010
User_Library-Header_Male_40Pin_BodyArray018
User_Library-Header_Male_40Pin_BodyArray021
User_Library-Header_Male_40Pin_BodyArray012
User_Library-Header_Male_40Pin_BodyArray013
User_Library-Header_Male_40Pin_BodyArray017
User_Library-Header_Male_40Pin_BodyArray011
User_Library-Header_Male_40Pin_BodyArray008
User_Library-Header_Male_40Pin_BodyArray031
User_Library-Header_Male_40Pin_BodyArray004
User_Library-Header_Male_40Pin_BodyArray028
User_Library-Header_Male_40Pin_BodyArray032
User_Library-Header_Male_40Pin_BodyArray036
User_Library-Header_Male_40Pin_BodyArray037
User_Library-Header_Male_40Pin_BodyArray014
User_Library-Header_Male_40Pin_BodyArray030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
