KevinLalonde/Power_Selector/KiCad_Library/3D_Model/Diodes/SOD-80.step

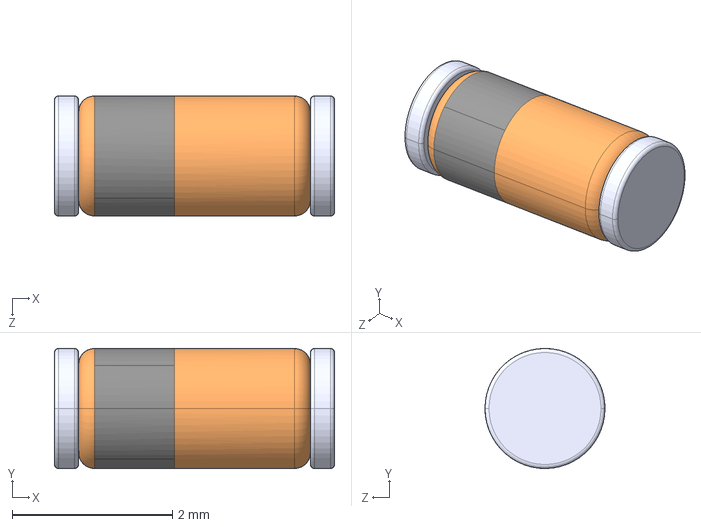
[picture p67: CAD file, 2023-07-19]
KiCad_Library/3D_Model/Diodes/SOD-80.step
3.50 x 1.50 x 1.50 mm
