KevinLalonde/Power_Selector/KiCad_Library/3D_Model/IC/R1SE-0505-R--3DModel-STEP-56544.STEP

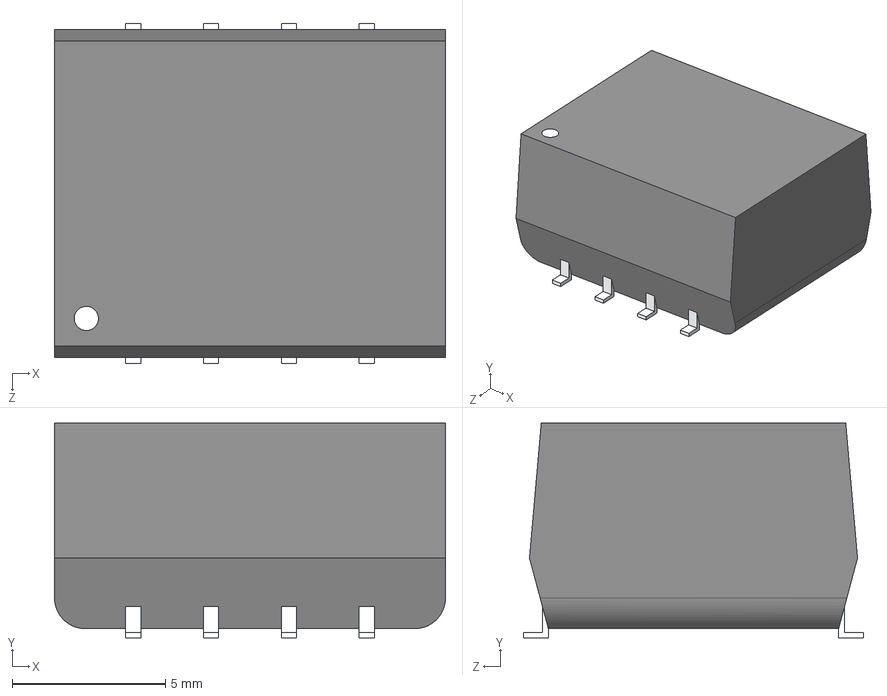
[picture p68: CAD file, 2023-07-19]
KiCad_Library/3D_Model/IC/R1SE-0505-R--3DModel-STEP-56544.STEP
12.8 x 7.00 x 11.1 mm
