KevinLalonde/Power_Selector/KiCad_Library/3D_Model/Inductors/IND-1245.stp

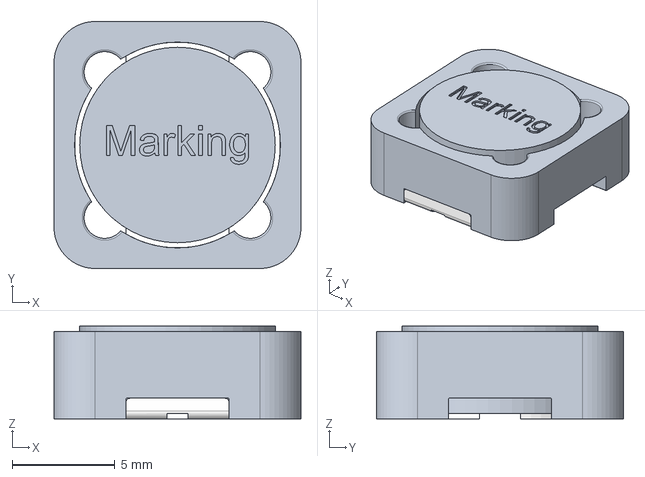
[picture p69: CAD file, 2023-07-19]
KiCad_Library/3D_Model/Inductors/IND-1245.stp
12.0 x 12.0 x 4.50 mm
