KevinLalonde/Power_Selector/KiCad_Library/3D_Model/Relays/9007-12-01.stp

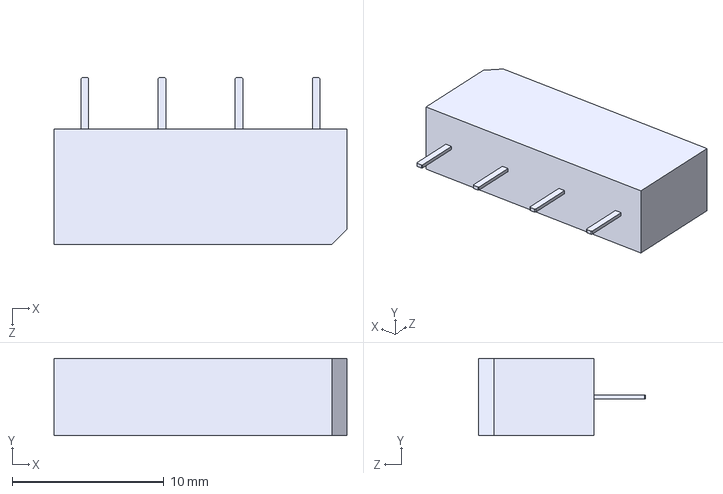
[picture p70: CAD file, 2023-07-19]
KiCad_Library/3D_Model/Relays/9007-12-01.stp
19.3 x 5.08 x 11.0 mm
