KevinLalonde/Power_Selector/KiCad_Library/3D_Model/Switches/GW12LBP.STEP

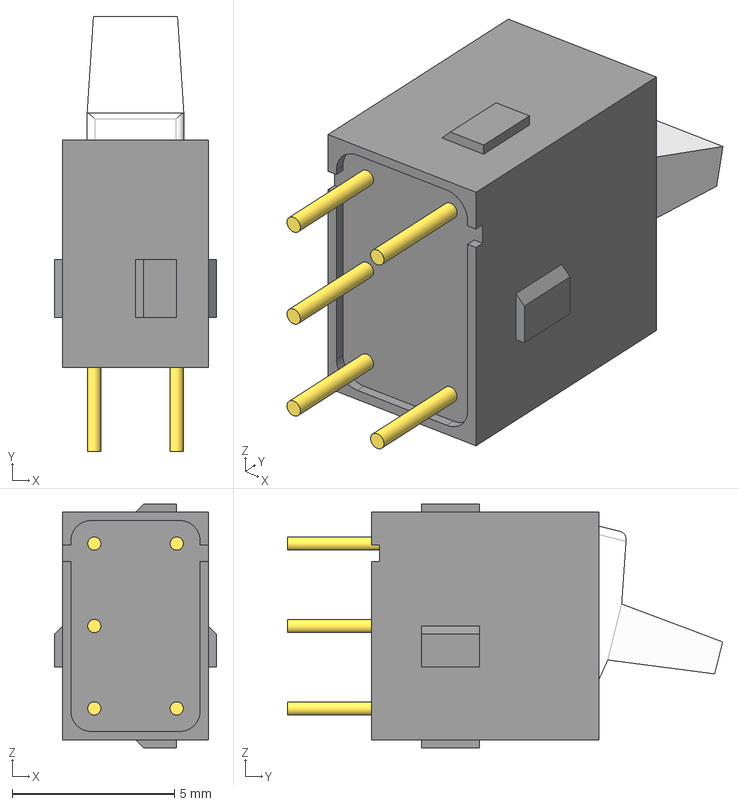
[picture p71: CAD file, 2023-07-19]
KiCad_Library/3D_Model/Switches/GW12LBP.STEP
5.00 x 13.4 x 7.52 mm
_GW1L-body-noill
_GW1P-terminals-noill
_GWLB-actuator-noill
