KevinLalonde/Power_Selector/KiCad_Library/3D_Model/Assembly/pqmc3.stp

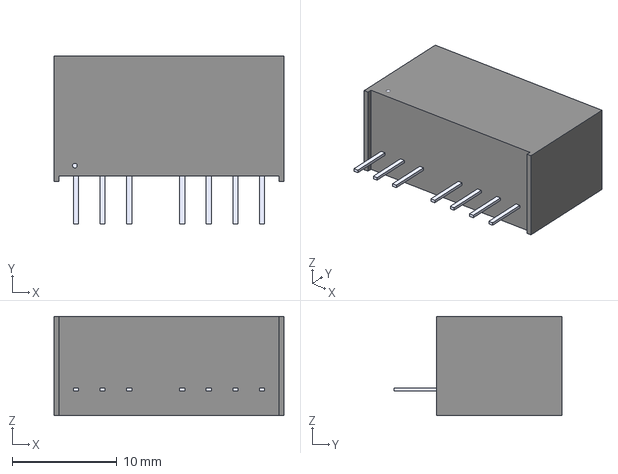
[picture p72: CAD file, 2023-07-19]
KiCad_Library/3D_Model/Assembly/pqmc3.stp
22.0 x 16.1 x 9.50 mm
