KevinLalonde/Power_Selector/KiCad_Library/3D_Model/Capacitors/CapAluRadial_D125H200P50.STEP

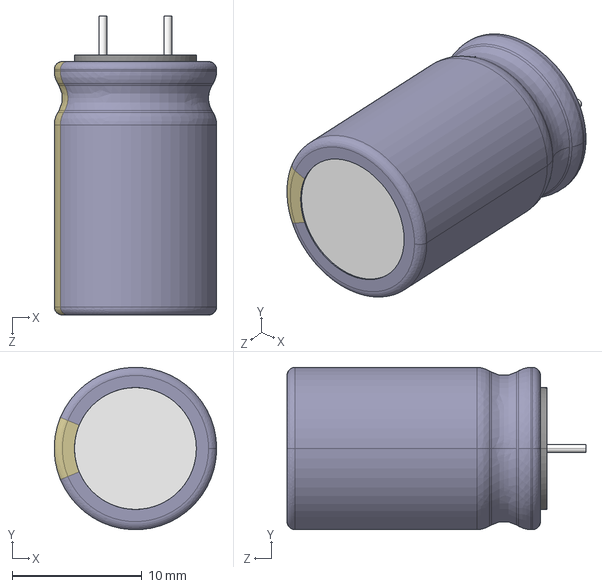
[picture p73: CAD file, 2023-07-19]
KiCad_Library/3D_Model/Capacitors/CapAluRadial_D125H200P50.STEP
12.5 x 12.5 x 23.0 mm
