KevinLalonde/Power_Selector/KiCad_Library/3D_Model/Diodes/TO-277A.STEP

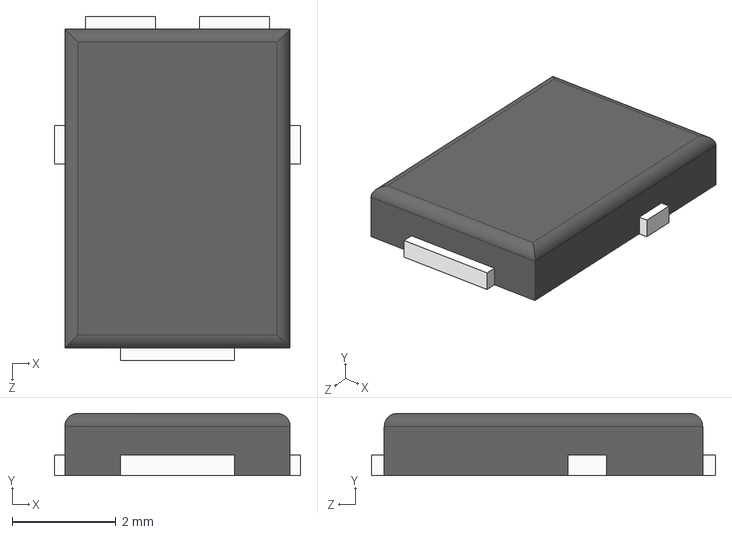
[picture p74: CAD file, 2023-07-19]
KiCad_Library/3D_Model/Diodes/TO-277A.STEP
4.75 x 1.20 x 6.65 mm
