KevinLalonde/Power_Selector/KiCad_Library/3D_Model/IC/AnalogDevices_16-MSOP.step

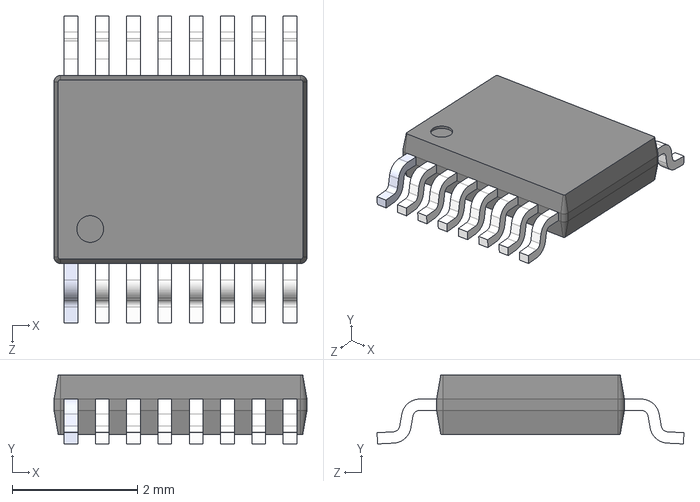
[picture p75: CAD file, 2023-07-19]
KiCad_Library/3D_Model/IC/AnalogDevices_16-MSOP.step
4.04 x 1.10 x 4.90 mm
