KevinLalonde/Power_Selector/KiCad_Library/3D_Model/Inductors/WE-HCI-7040.stp

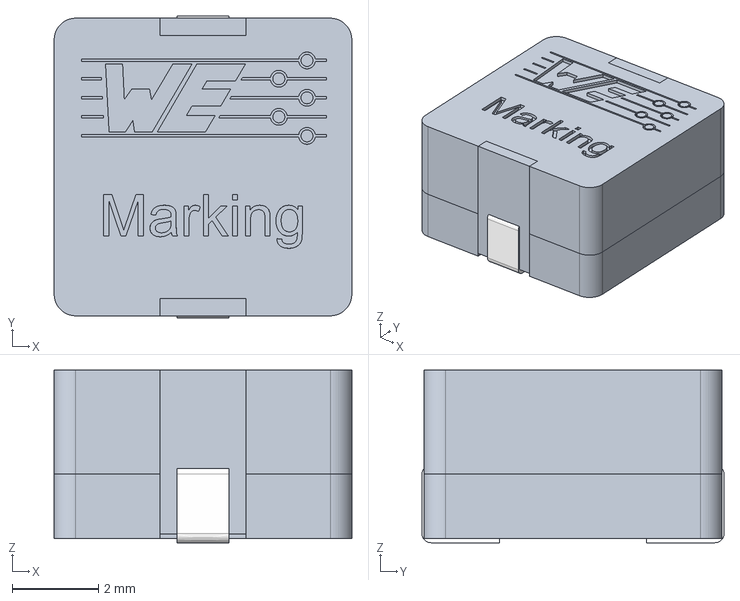
[picture p76: CAD file, 2023-07-19]
KiCad_Library/3D_Model/Inductors/WE-HCI-7040.stp
6.90 x 7.00 x 4.00 mm
