KevinLalonde/Power_Selector/KiCad_Library/3D_Model/Relays/ALQ112.stp

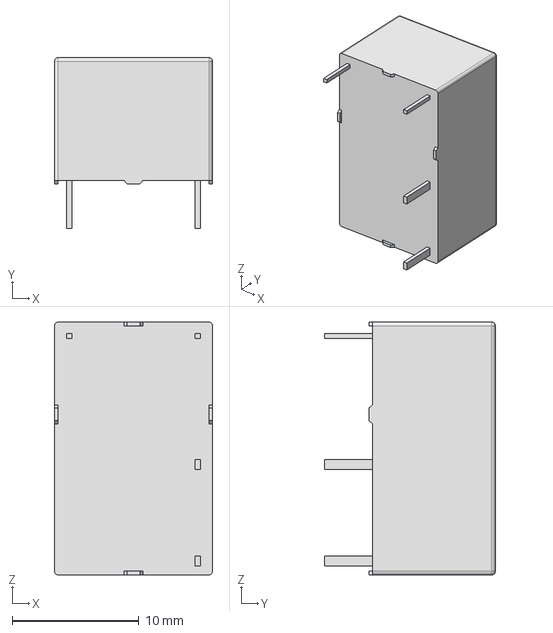
[picture p77: CAD file, 2023-07-19]
KiCad_Library/3D_Model/Relays/ALQ112.stp
12.5 x 13.5 x 20.0 mm
