KevinLalonde/Power_Selector/KiCad_Library/3D_Model/Resistors/TR50.stp

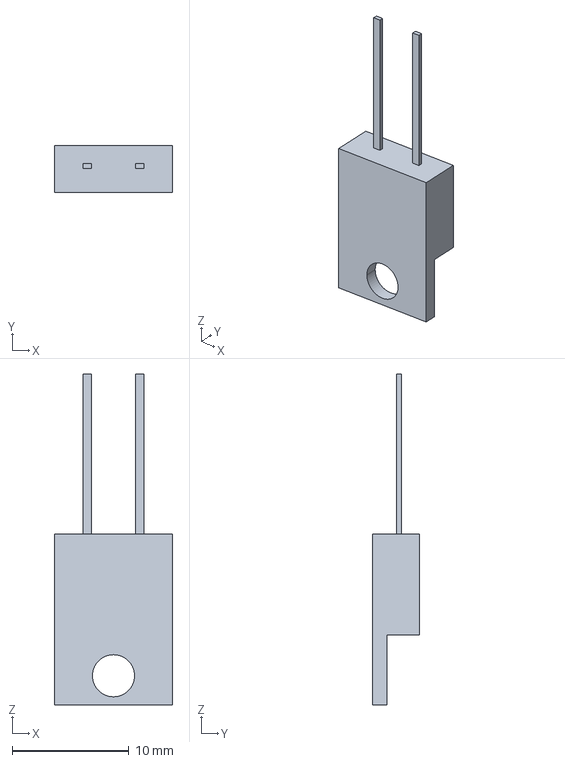
[picture p78: CAD file, 2023-07-19]
KiCad_Library/3D_Model/Resistors/TR50.stp
10.1 x 4.00 x 28.3 mm
