KevinLalonde/Power_Selector/KiCad_Library/3D_Model/Switches/100DPxT1B2M2xE.stp

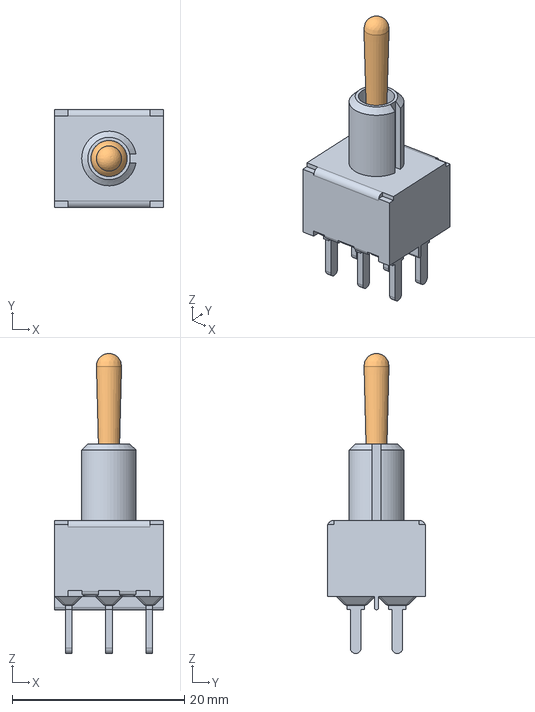
[picture p79: CAD file, 2023-07-19]
KiCad_Library/3D_Model/Switches/100DPxT1B2M2xE.stp
12.7 x 11.4 x 34.9 mm
