KevinLalonde/Power_Selector/KiCad_Library/3D_Model/Assembly/ACZ11BR1E-15KQA1-12C.stp

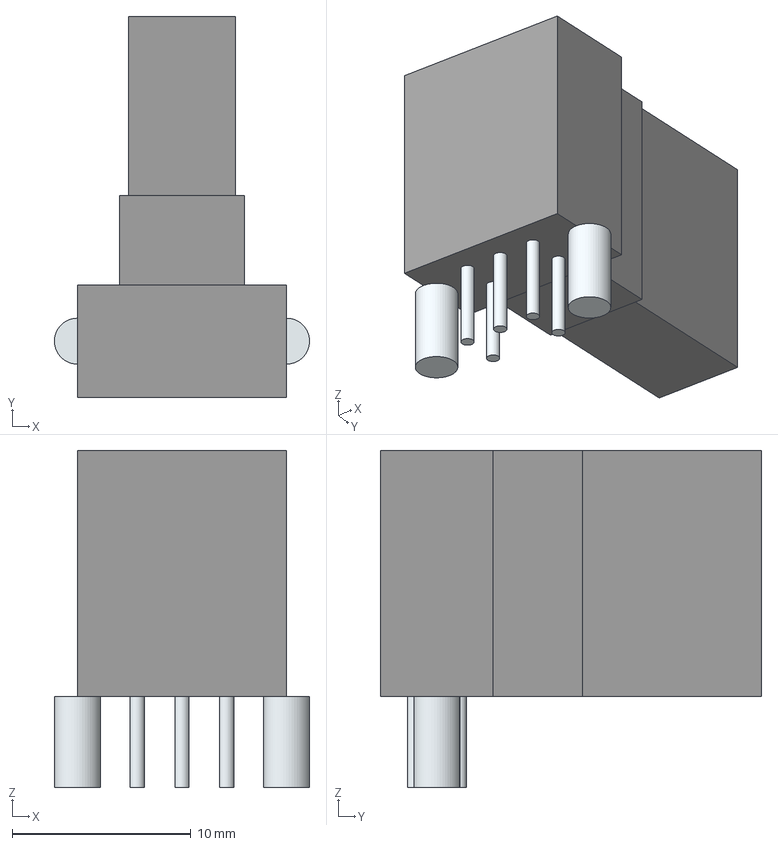
[picture p80: CAD file, 2023-07-19]
KiCad_Library/3D_Model/Assembly/ACZ11BR1E-15KQA1-12C.stp
14.3 x 21.3 x 18.9 mm
Leads x 7
