KevinLalonde/Power_Selector/KiCad_Library/3D_Model/Capacitors/CAP_WURTH_P10L13W5.stp

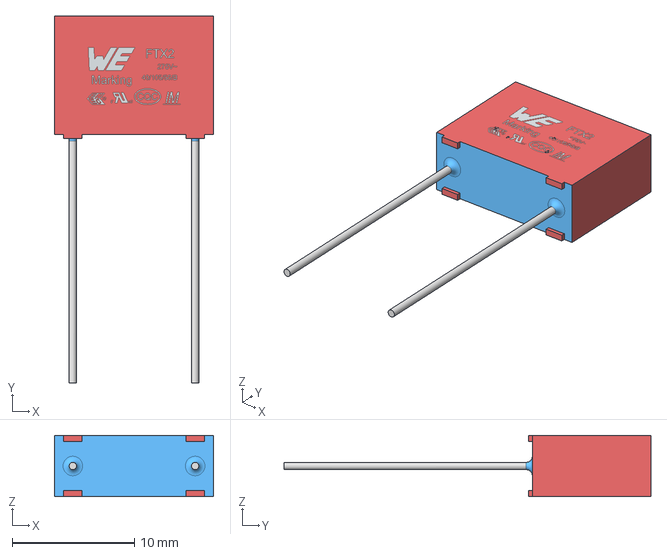
[picture p81: CAD file, 2023-07-19]
KiCad_Library/3D_Model/Capacitors/CAP_WURTH_P10L13W5.stp
13.0 x 30.0 x 5.00 mm
