KevinLalonde/Power_Selector/KiCad_Library/3D_Model/IC/TO-220-Coucher.step

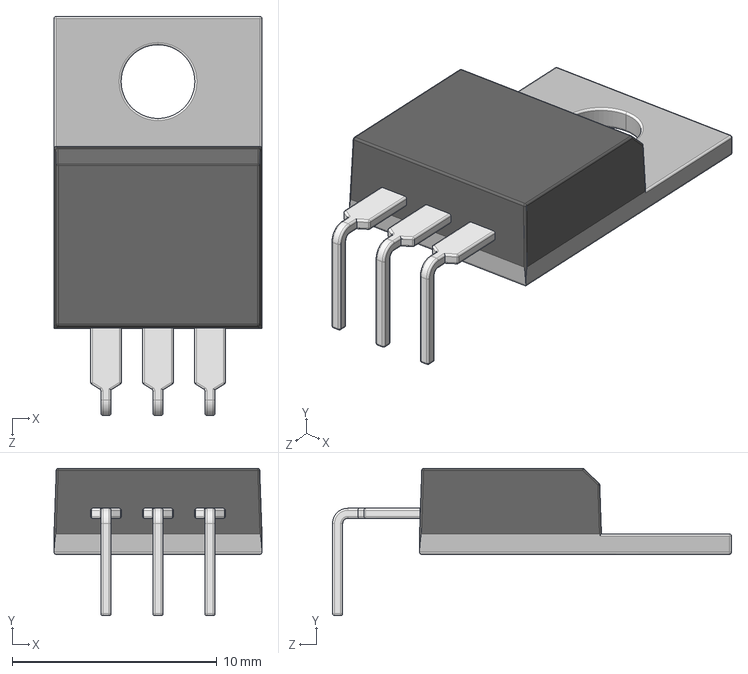
[picture p83: CAD file, 2023-07-19]
KiCad_Library/3D_Model/IC/TO-220-Coucher.step
10.2 x 7.20 x 19.5 mm
