KevinLalonde/Power_Selector/KiCad_Library/3D_Model/Inductors/I0805.step

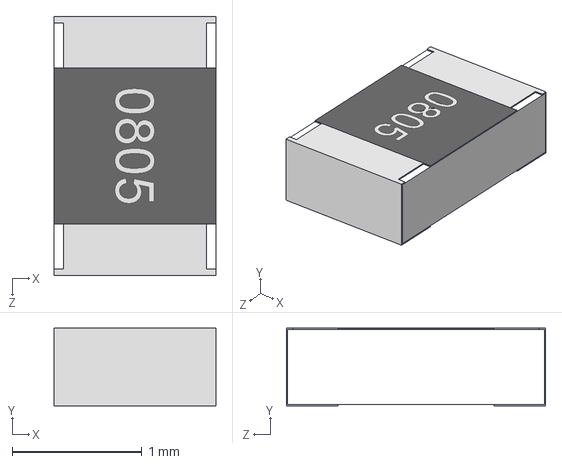
[picture p84: CAD file, 2023-07-19]
KiCad_Library/3D_Model/Inductors/I0805.step
1.25 x 0.6 x 2.00 mm
