KevinLalonde/Power_Selector/KiCad_Library/3D_Model/Relays/c-4-1462037-7-b5-3d.stp

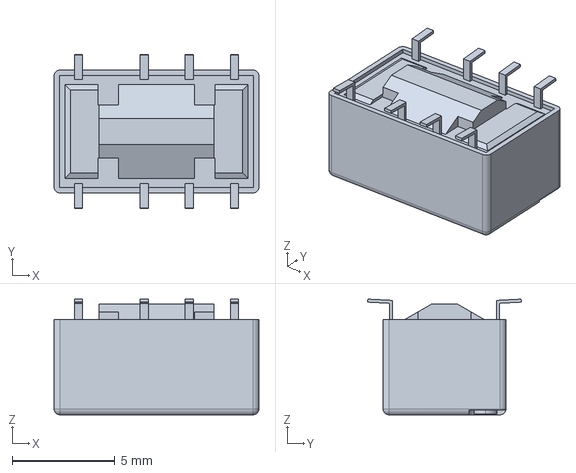
[picture p85: CAD file, 2023-07-19]
KiCad_Library/3D_Model/Relays/c-4-1462037-7-b5-3d.stp
10.0 x 7.50 x 5.65 mm
