KevinLalonde/Power_Selector/KiCad_Library/3D_Model/Resistors/R1210.step

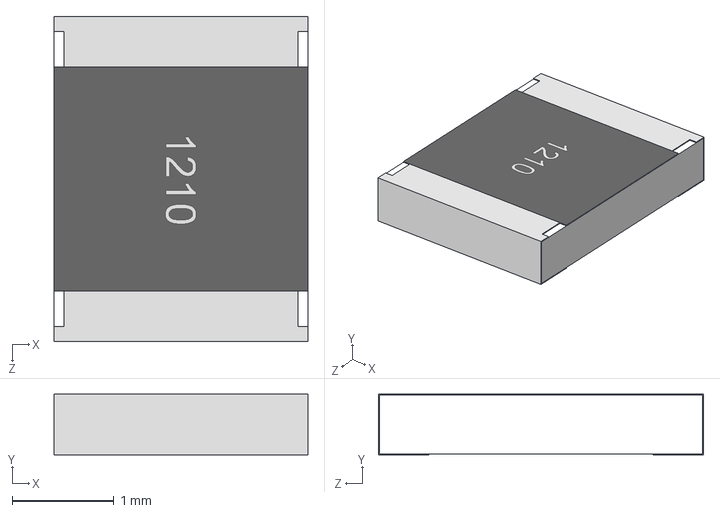
[picture p86: CAD file, 2023-07-19]
KiCad_Library/3D_Model/Resistors/R1210.step
2.50 x 0.6 x 3.20 mm
