KevinLalonde/Power_Selector/KiCad_Library/3D_Model/Switches/PTS645S.step

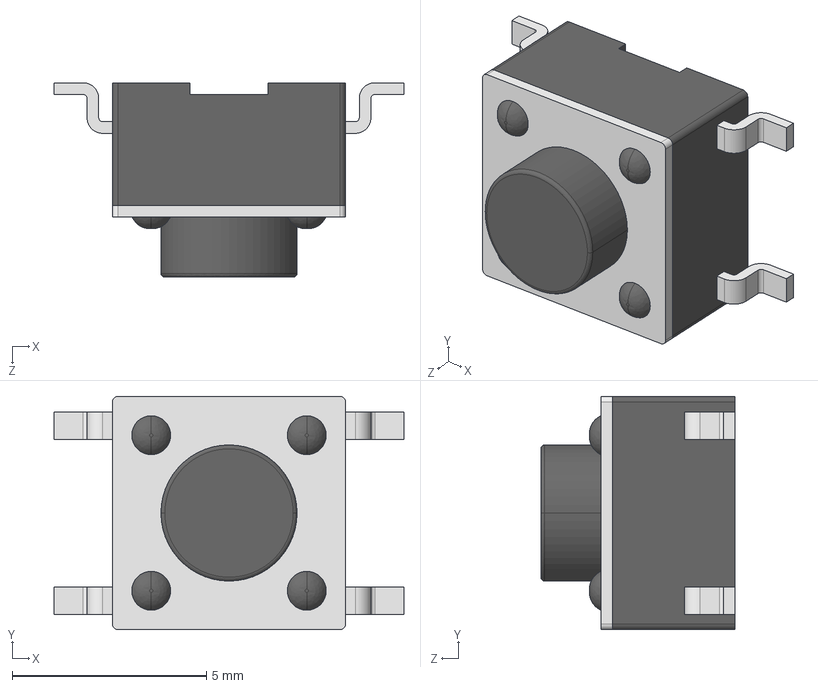
[picture p87: CAD file, 2023-07-19]
KiCad_Library/3D_Model/Switches/PTS645S.step
9.00 x 6.00 x 5.00 mm
User Library-PTS645SL50SMTR92-LFS_1
User Library-PTS645SL50SMTR92-LFS_2
User Library-PTS645SL50SMTR92-LFS_3
User Library-PTS645SL50SMTR92-LFS_4
User Library-PTS645SL50SMTR92-LFS_5
User Library-PTS645SL50SMTR92-LFS_6
User Library-PTS645SL50SMTR92-LFS_7
User Library-PTS645SL50SMTR92-LFS_8
User Library-PTS645SL50SMTR92-LFS_9
User Library-PTS645SL50SMTR92-LFS_10
User Library-PTS645SL50SMTR92-LFS_11
