KevinLalonde/Power_Selector/KiCad_Library/3D_Model/Capacitors/C1206.step

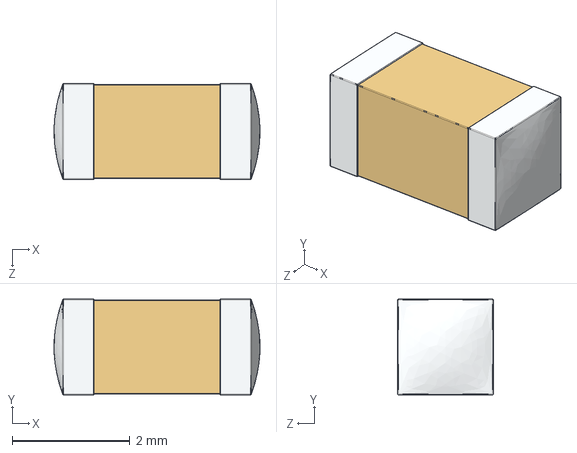
[picture p88: CAD file, 2023-07-19]
KiCad_Library/3D_Model/Capacitors/C1206.step
3.50 x 1.63 x 1.62 mm
