KevinLalonde/Power_Selector/KiCad_Library/3D_Model/IC/4-SMD.step

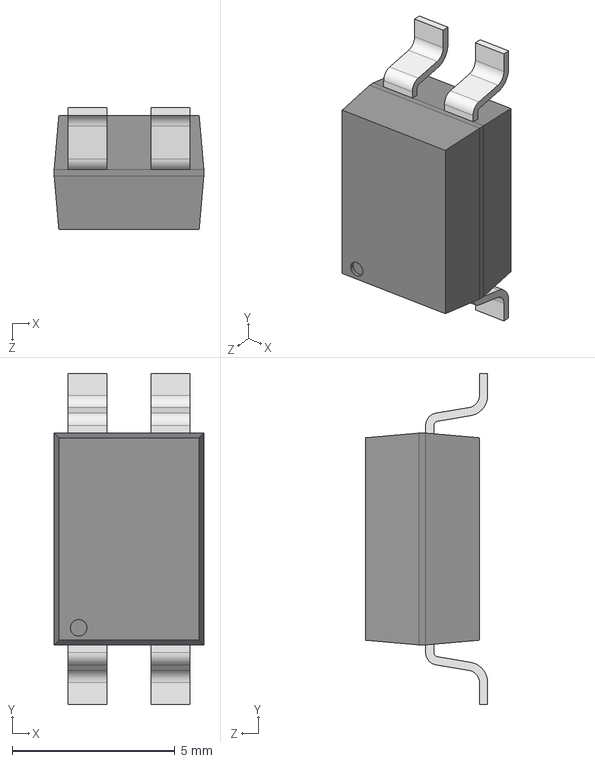
[picture p90: CAD file, 2023-07-19]
KiCad_Library/3D_Model/IC/4-SMD.step
4.60 x 10.2 x 3.76 mm
