KevinLalonde/Power_Selector/KiCad_Library/3D_Model/Switches/GW12LJPCF.stp

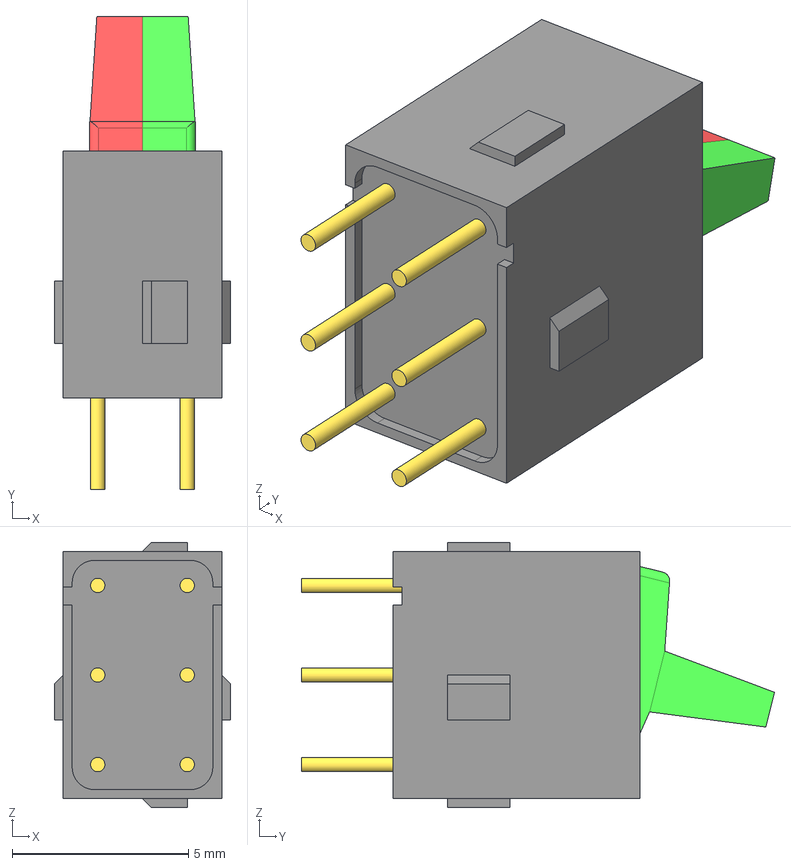
[picture p91: CAD file, 2023-07-19]
KiCad_Library/3D_Model/Switches/GW12LJPCF.stp
5.00 x 13.4 x 7.52 mm
_GW1-body
_GWP-terminals
_GWCF-act_green
_GWCF-act_red
