KevinLalonde/Power_Selector/KiCad_Library/3D_Model/Capacitors/CapAluRadial_D100H125P50.STEP

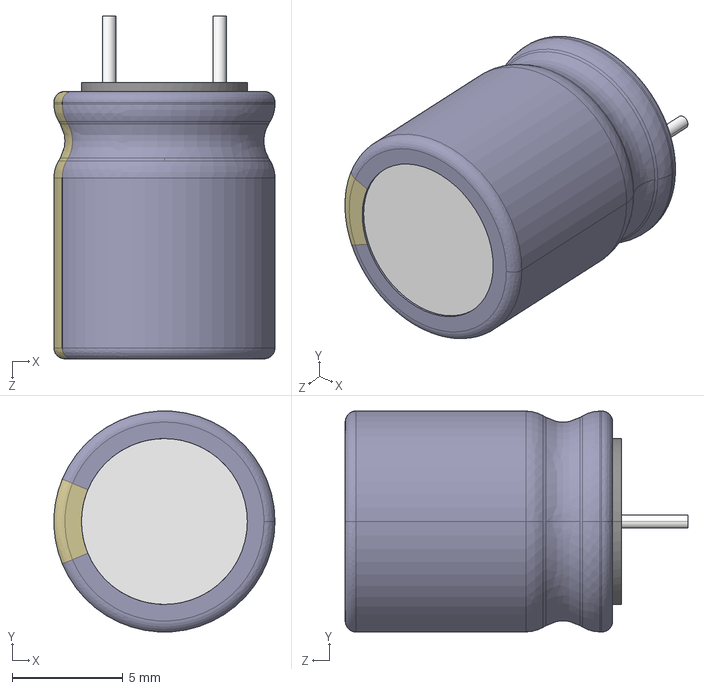
[picture p92: CAD file, 2023-07-19]
KiCad_Library/3D_Model/Capacitors/CapAluRadial_D100H125P50.STEP
9.99 x 9.99 x 15.5 mm
