KevinLalonde/Power_Selector/KiCad_Library/3D_Model/Diodes/SOD-323.step

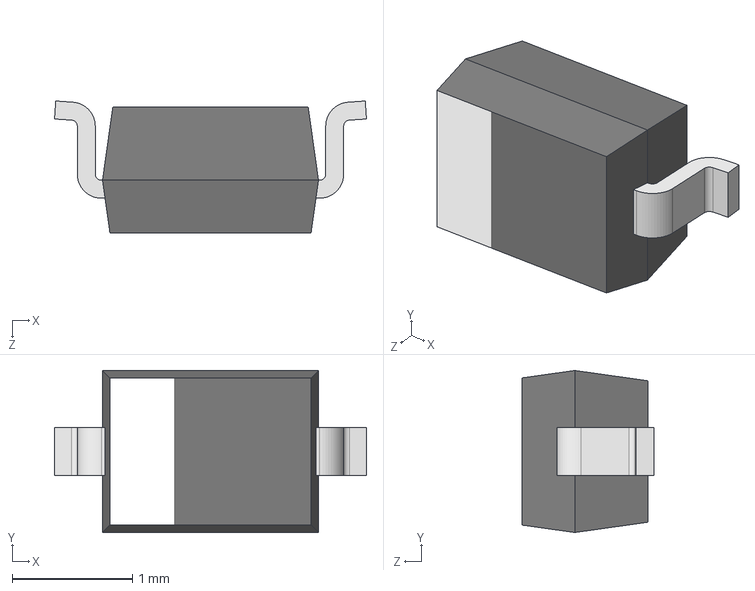
[picture p94: CAD file, 2023-07-19]
KiCad_Library/3D_Model/Diodes/SOD-323.step
2.60 x 1.35 x 1.10 mm
