KevinLalonde/Power_Selector/KiCad_Library/3D_Model/Relays/J104D2C24VDC.20S.stp

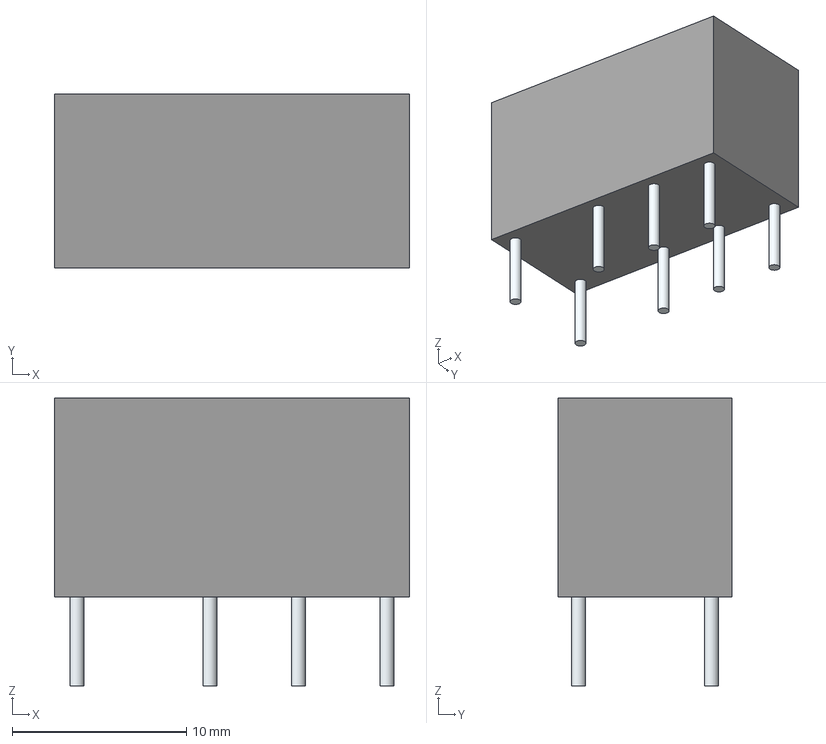
[picture p95: CAD file, 2023-07-19]
KiCad_Library/3D_Model/Relays/J104D2C24VDC.20S.stp
20.4 x 9.97 x 16.5 mm
Leads
