KevinLalonde/Power_Selector/KiCad_Library/3D_Model/Resistors/R1812.step

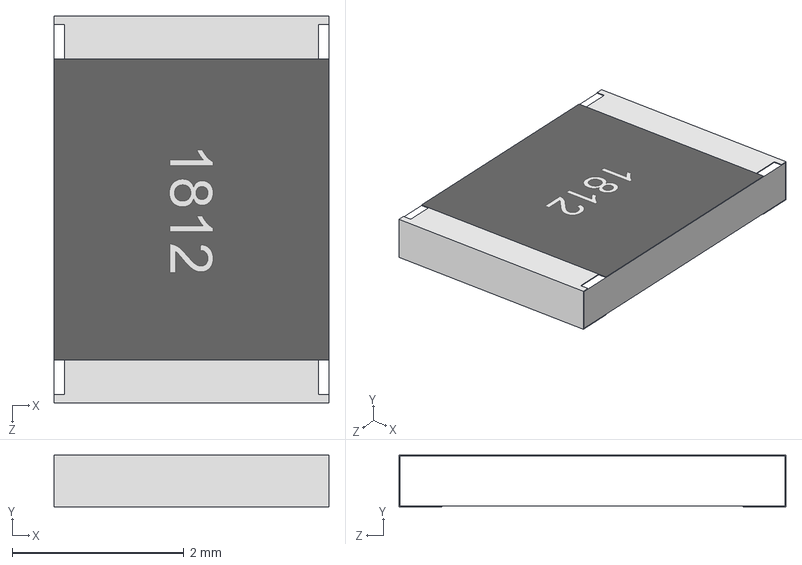
[picture p96: CAD file, 2023-07-19]
KiCad_Library/3D_Model/Resistors/R1812.step
3.20 x 0.6 x 4.50 mm
