KevinLalonde/Power_Selector/KiCad_Library/3D_Model/Switches/800AWSP9M2xE.stp

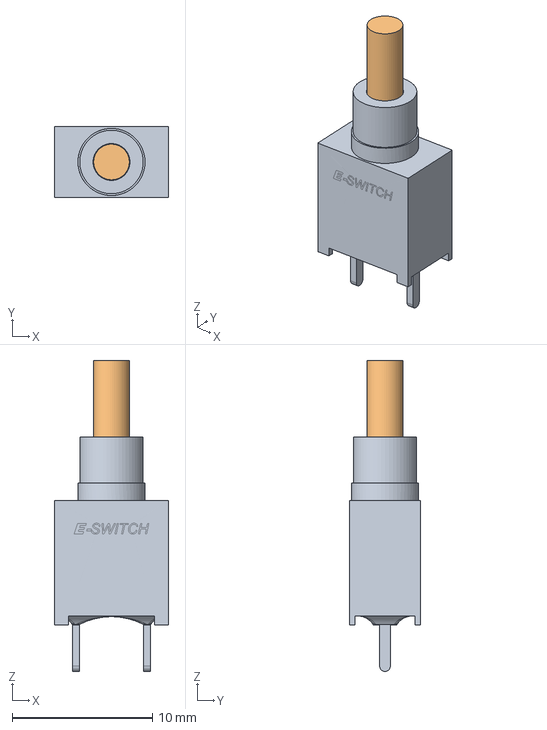
[picture p97: CAD file, 2023-07-19]
KiCad_Library/3D_Model/Switches/800AWSP9M2xE.stp
8.13 x 5.08 x 22.2 mm
