KevinLalonde/Power_Selector/KiCad_Library/3D_Model/Connectors/male_header_2_54_1X11.step

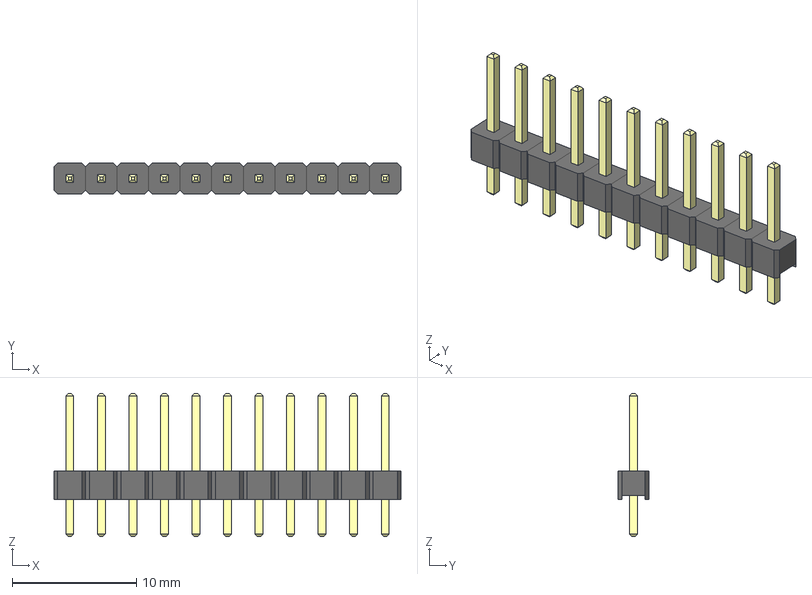
[picture p99: CAD file, 2023-07-19]
KiCad_Library/3D_Model/Connectors/male_header_2_54_1X11.step
27.9 x 2.49 x 11.5 mm
User_Library-Header_Male_40Pin_BodyArray033
User_Library-Header_Male_40Pin_PinArray032
User_Library-Header_Male_40Pin_PinArray006
User_Library-Header_Male_40Pin_PinArray021
User_Library-Header_Male_40Pin_PinArray014
User_Library-Header_Male_40Pin_PinArray036
User_Library-Header_Male_40Pin_PinArray017
User_Library-Header_Male_40Pin_PinArray031
User_Library-Header_Male_40Pin_PinArray016
User_Library-Header_Male_40Pin_PinArray013
User_Library-Header_Male_40Pin_BodyArray025
User_Library-Header_Male_40Pin_BodyArray002
User_Library-Header_Male_40Pin_BodyArray022
User_Library-Header_Male_40Pin_BodyArray010
User_Library-Header_Male_40Pin_BodyArray004
User_Library-Header_Male_40Pin_BodyArray028
User_Library-Header_Male_40Pin_BodyArray036
User_Library-Header_Male_40Pin_BodyArray037
User_Library-Header_Male_40Pin_BodyArray014
User_Library-Header_Male_40Pin_BodyArray001
User_Library-Header_Male_40Pin_PinArray007
User_Library-Header_Male_40Pin_PinArray011
