KevinLalonde/Power_Selector/KiCad_Library/3D_Model/Diodes/USBLC6-2SC6.STEP

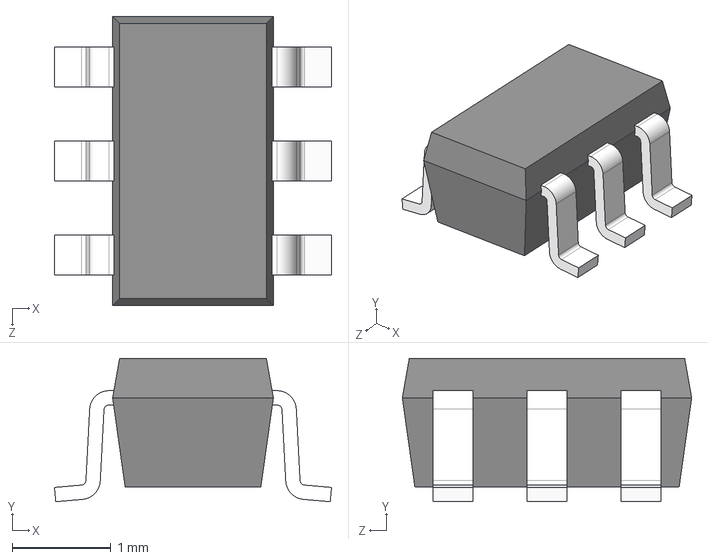
[picture p100: CAD file, 2023-07-19]
KiCad_Library/3D_Model/Diodes/USBLC6-2SC6.STEP
2.80 x 1.45 x 2.92 mm
