KevinLalonde/Power_Selector/KiCad_Library/3D_Model/IC/SOIC-8_Wide_5mmx5mm.step

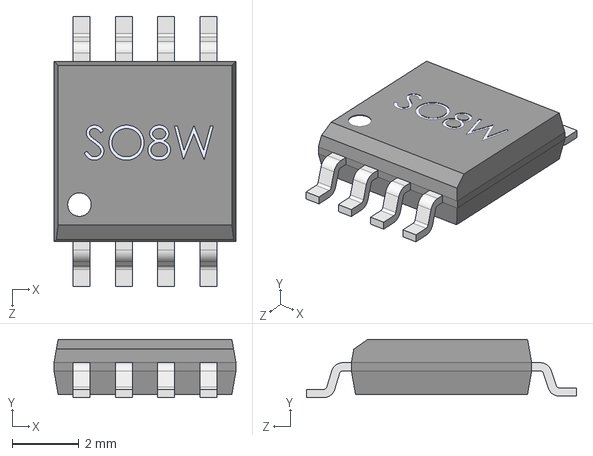
[picture p101: CAD file, 2023-07-19]
KiCad_Library/3D_Model/IC/SOIC-8_Wide_5mmx5mm.step
5.46 x 1.75 x 8.10 mm
