KevinLalonde/Power_Selector/KiCad_Library/3D_Model/Relays/c-2-1462039-9-b5-2d.dxf

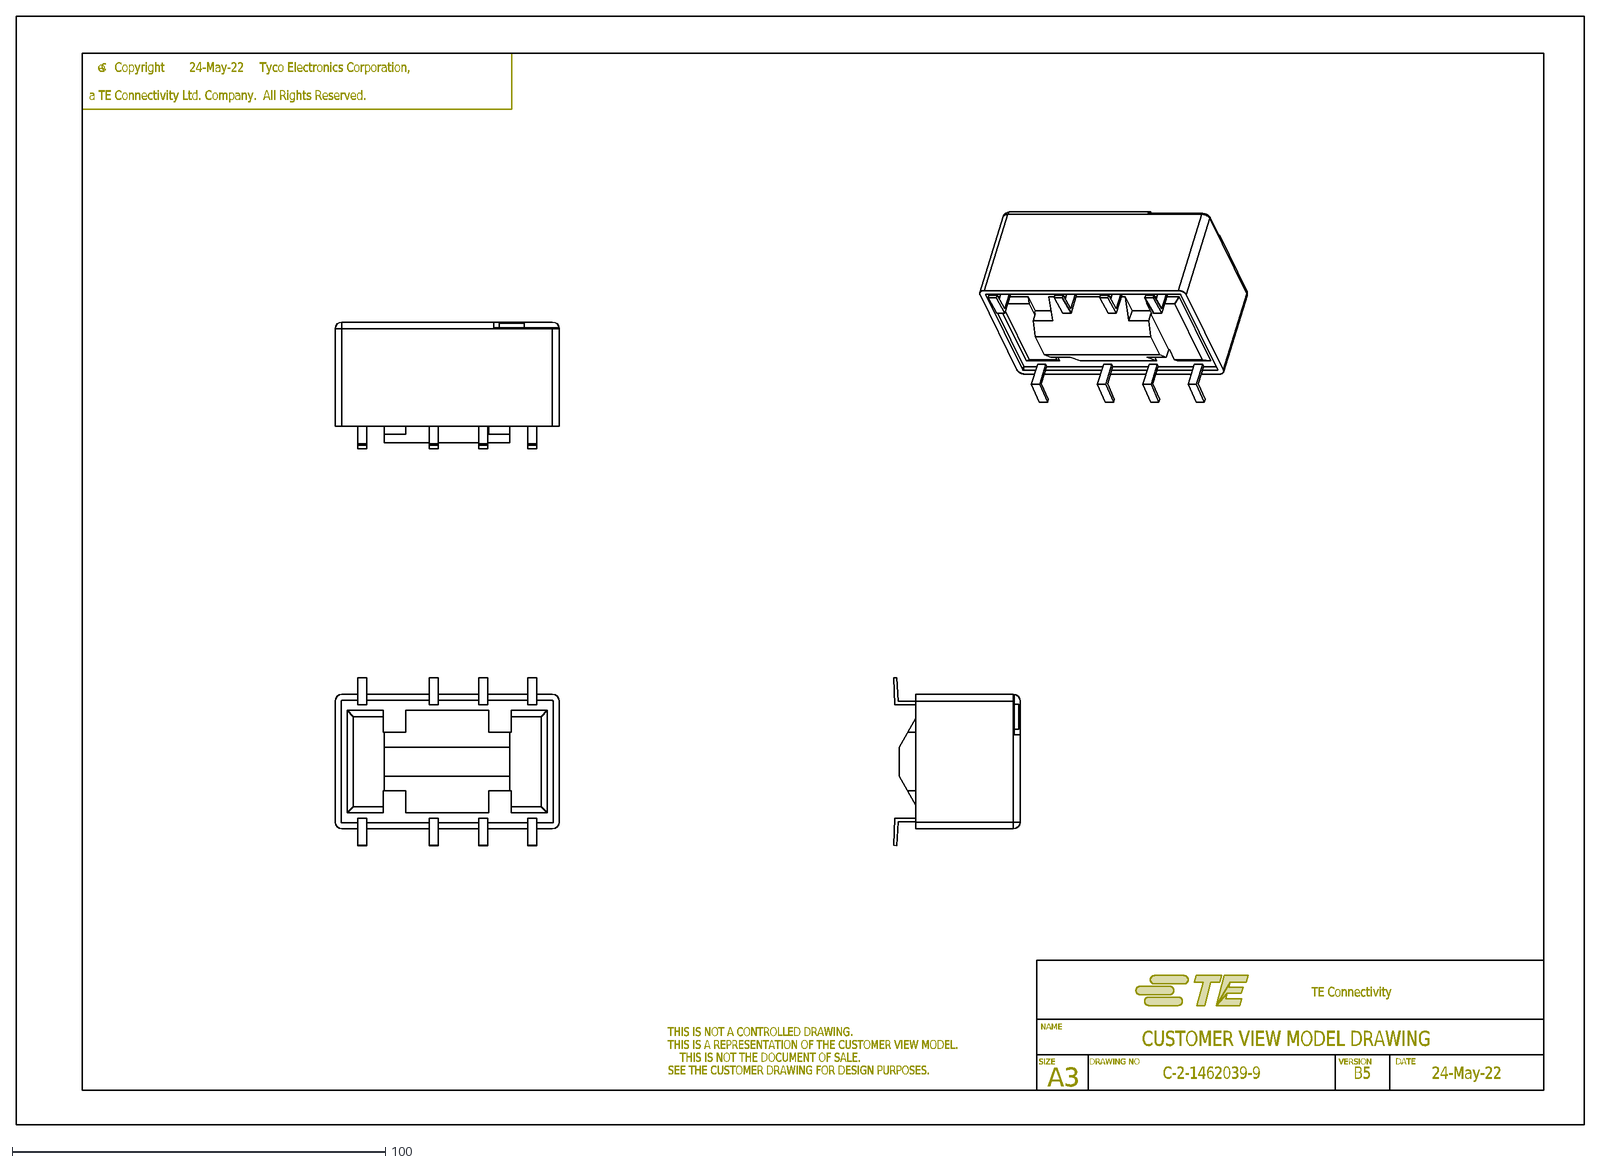
[picture p102: CAD file, 2023-07-19]
KiCad_Library/3D_Model/Relays/c-2-1462039-9-b5-2d.dxf
SIZE
DRAWING NO
VERSION
NAME
A3
CUSTOMER VIEW MODEL DRAWING
TE Connectivity
DATE
THIS IS NOT A CONTROLLED DRAWING.
THIS IS A REPRESENTATION OF THE CUSTOMER VIEW MODEL.
THIS IS NOT THE DOCUMENT OF SALE.
SEE THE CUSTOMER DRAWING FOR DESIGN PURPOSES.
c
C-2-1462039-9
B5
24-May-22
Copyright
Tyco Electronics Corporation,
a TE Connectivity Ltd. Company. All Rights Reserved.
