KevinLalonde/Power_Selector/KiCad_Library/3D_Model/Resistors/R2010.step

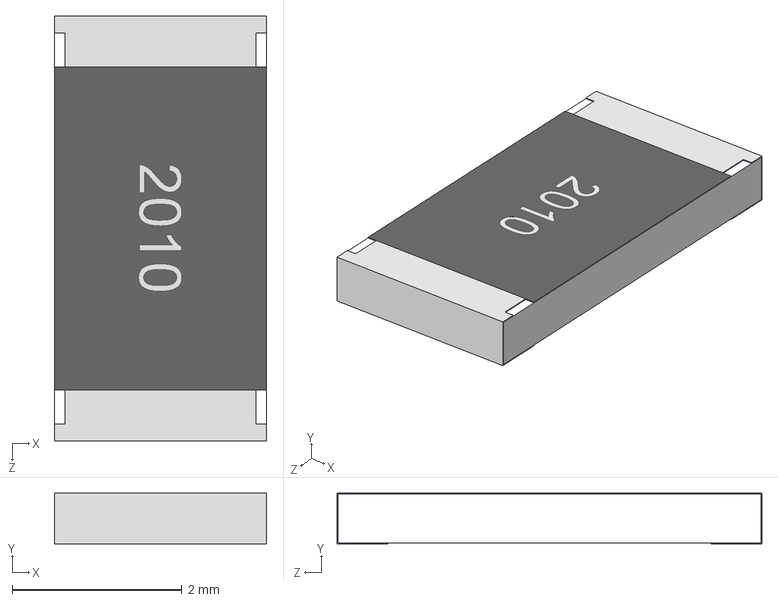
[picture p103: CAD file, 2023-07-19]
KiCad_Library/3D_Model/Resistors/R2010.step
2.50 x 0.6 x 5.00 mm
