KevinLalonde/Power_Selector/KiCad_Library/3D_Model/Capacitors/C0805.step

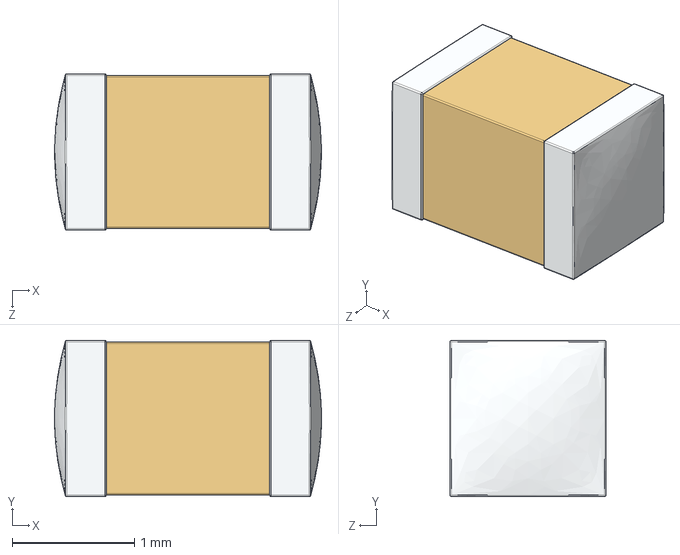
[picture p104: CAD file, 2023-07-19]
KiCad_Library/3D_Model/Capacitors/C0805.step
2.18 x 1.27 x 1.27 mm
