KevinLalonde/Power_Selector/KiCad_Library/3D_Model/Diodes/SOD-523.step

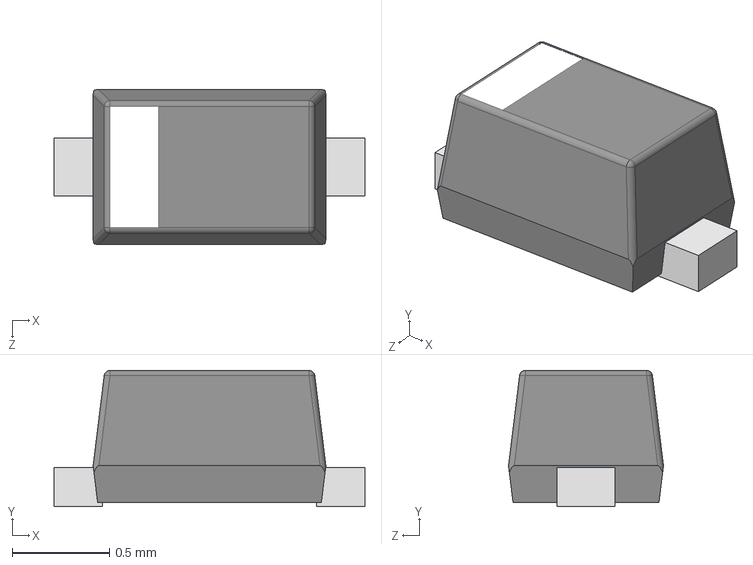
[picture p105: CAD file, 2023-07-19]
KiCad_Library/3D_Model/Diodes/SOD-523.step
1.60 x 0.7 x 0.798 mm
