KevinLalonde/Power_Selector/KiCad_Library/3D_Model/IC/BNO055.step

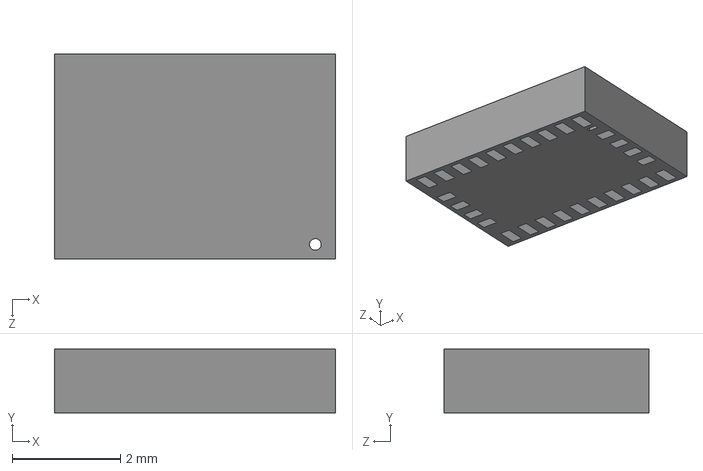
[picture p106: CAD file, 2023-07-19]
KiCad_Library/3D_Model/IC/BNO055.step
5.20 x 1.18 x 3.80 mm
