KevinLalonde/Power_Selector/KiCad_Library/3D_Model/Relays/G6C_2117P_US.step

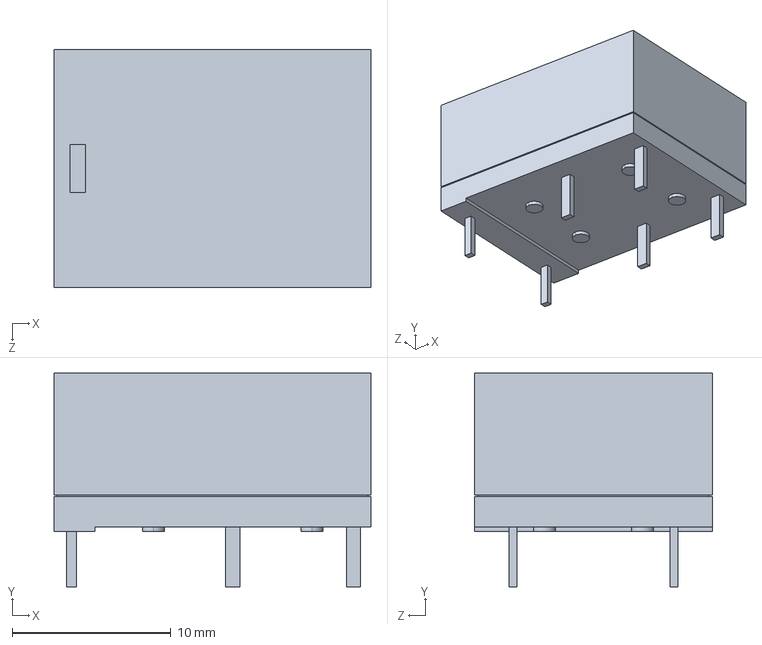
[picture p107: CAD file, 2023-07-19]
KiCad_Library/3D_Model/Relays/G6C_2117P_US.step
20.0 x 13.5 x 15.0 mm
