KevinLalonde/Power_Selector/KiCad_Library/3D_Model/Resistors/R1218.step

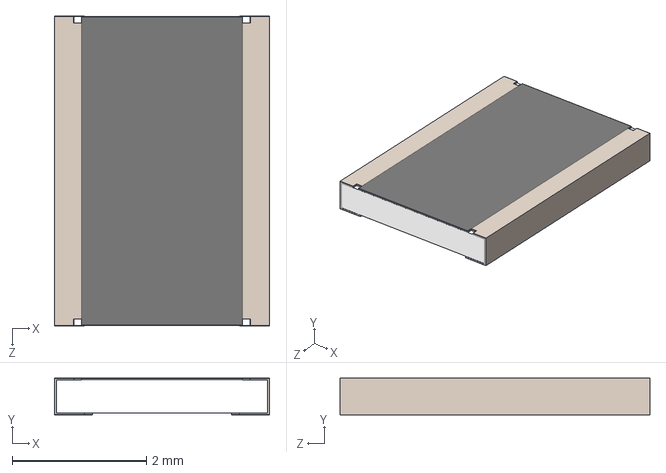
[picture p108: CAD file, 2023-07-19]
KiCad_Library/3D_Model/Resistors/R1218.step
3.20 x 0.55 x 4.61 mm
