KevinLalonde/Power_Selector/KiCad_Library/3D_Model/Capacitors/C2220.step

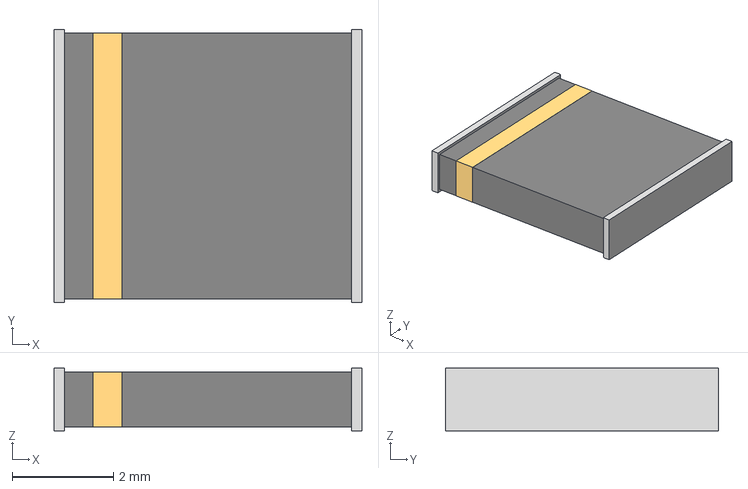
[picture p109: CAD file, 2023-07-19]
KiCad_Library/3D_Model/Capacitors/C2220.step
6.10 x 5.41 x 1.25 mm
