KevinLalonde/Power_Selector/KiCad_Library/3D_Model/Diodes/SOD-123FL.step

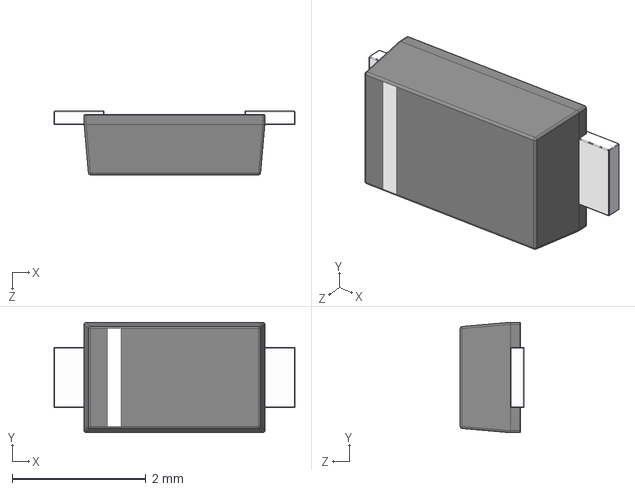
[picture p110: CAD file, 2023-07-19]
KiCad_Library/3D_Model/Diodes/SOD-123FL.step
3.60 x 1.65 x 0.951 mm
