KevinLalonde/Power_Selector/KiCad_Library/3D_Model/IC/SOIC-16.step

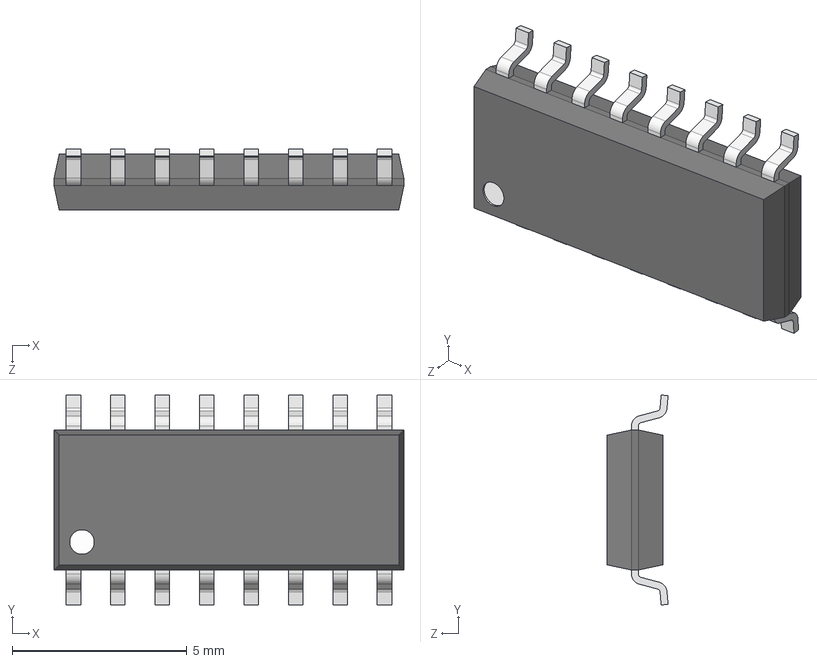
[picture p111: CAD file, 2023-07-19]
KiCad_Library/3D_Model/IC/SOIC-16.step
10.0 x 6.00 x 1.75 mm
