KevinLalonde/Power_Selector/KiCad_Library/3D_Model/Relays/LI05-1A85.stp

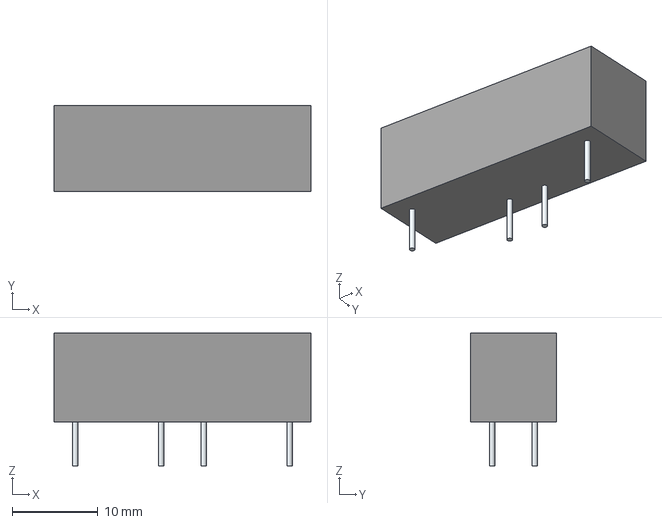
[picture p112: CAD file, 2023-07-19]
KiCad_Library/3D_Model/Relays/LI05-1A85.stp
30.0 x 10.0 x 15.5 mm
Leads
