KevinLalonde/Power_Selector/KiCad_Library/3D_Model/Resistors/T93YA.stp

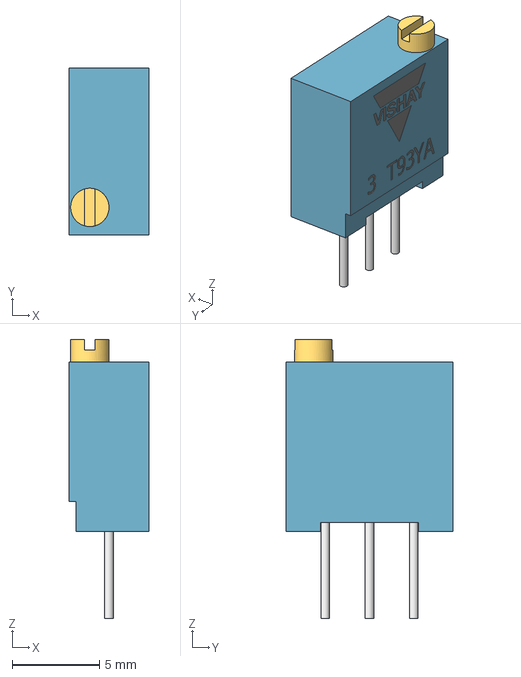
[picture p113: CAD file, 2023-07-19]
KiCad_Library/3D_Model/Resistors/T93YA.stp
4.60 x 9.60 x 16.0 mm
