KevinLalonde/Power_Selector/KiCad_Library/3D_Model/Connectors/female_header_2_54_2X19.stp

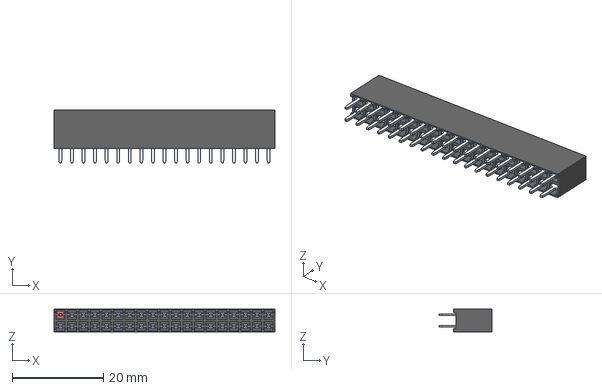
[picture p114: CAD file, 2023-07-19]
KiCad_Library/3D_Model/Connectors/female_header_2_54_2X19.stp
48.5 x 11.7 x 5.00 mm
