KevinLalonde/Power_Selector/KiCad_Library/3D_Model/IC/VQFN-24.step

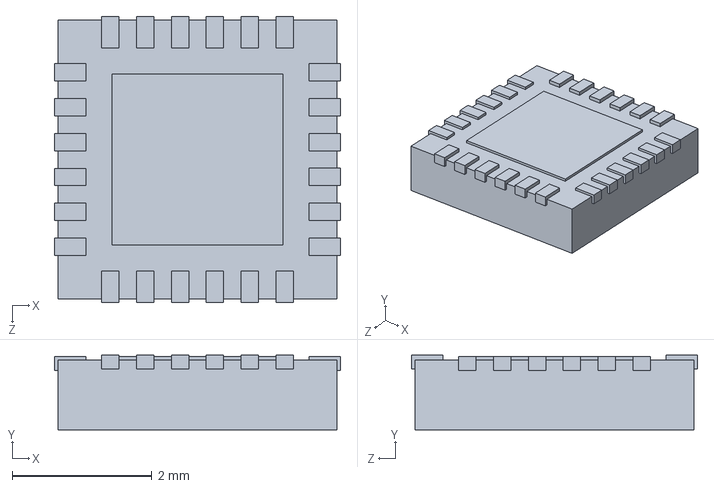
[picture p115: CAD file, 2023-07-19]
KiCad_Library/3D_Model/IC/VQFN-24.step
4.10 x 1.07 x 4.10 mm
