KevinLalonde/Power_Selector/KiCad_Library/3D_Model/Resistors/TO220_2PIN.STEP

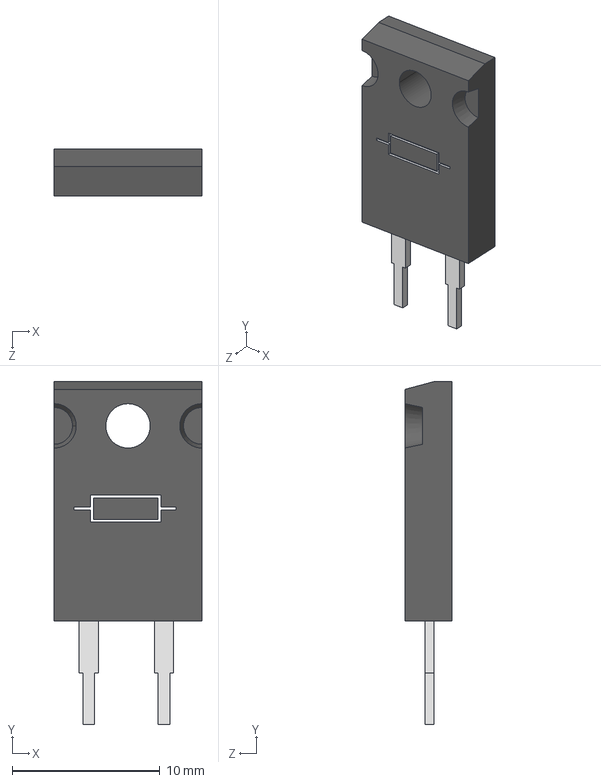
[picture p116: CAD file, 2023-07-19]
KiCad_Library/3D_Model/Resistors/TO220_2PIN.STEP
10.0 x 23.2 x 3.20 mm
