KevinLalonde/Power_Selector/KiCad_Library/3D_Model/IC/6-SMD.step

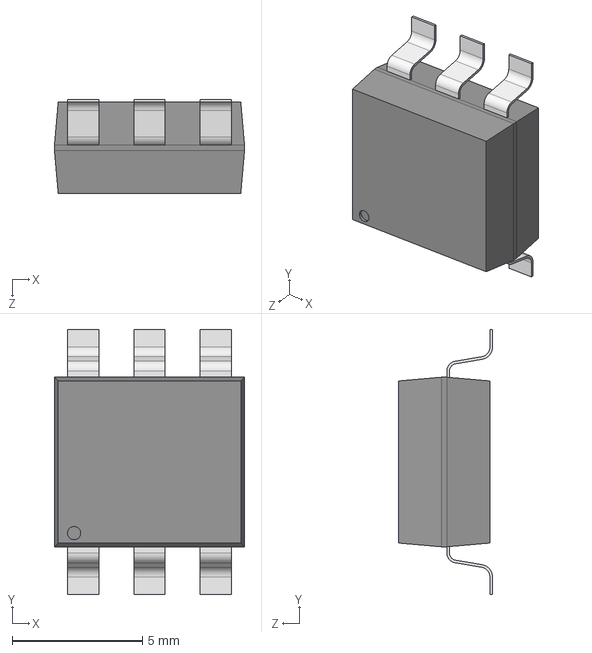
[picture p117: CAD file, 2023-07-19]
KiCad_Library/3D_Model/IC/6-SMD.step
7.29 x 10.2 x 3.61 mm
