KevinLalonde/Power_Selector/KiCad_Library/3D_Model/Resistors/R0603.step

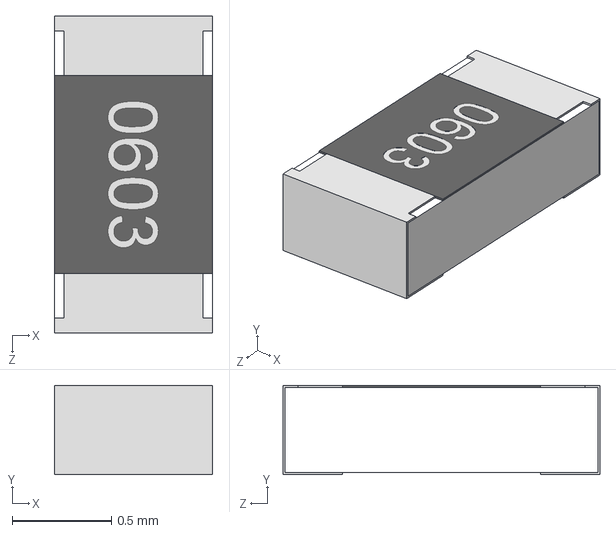
[picture p118: CAD file, 2023-07-19]
KiCad_Library/3D_Model/Resistors/R0603.step
0.8 x 0.45 x 1.60 mm
