KevinLalonde/Power_Selector/KiCad_Library/3D_Model/Diodes/DO-214AA_SMB.step

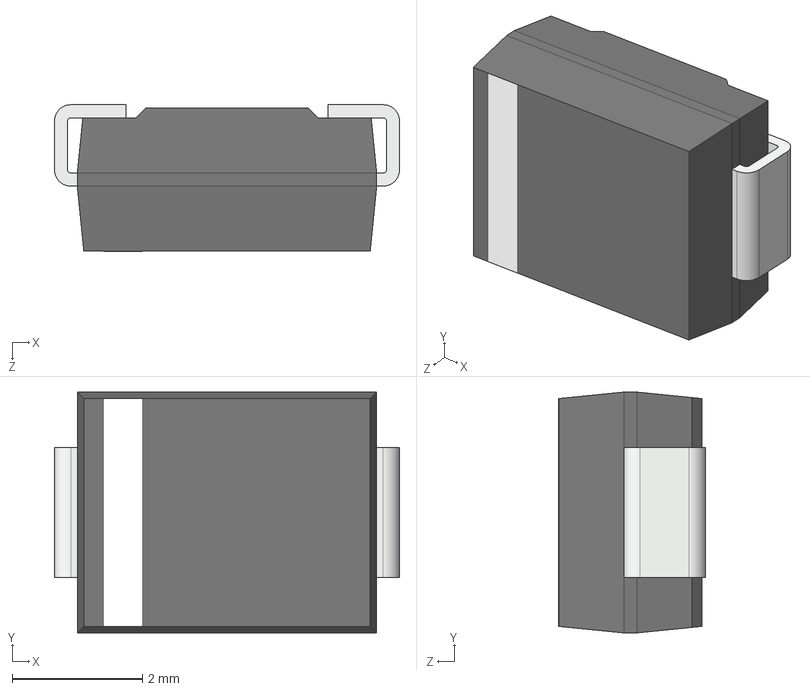
[picture p119: CAD file, 2023-07-19]
KiCad_Library/3D_Model/Diodes/DO-214AA_SMB.step
5.30 x 3.70 x 2.25 mm
