KevinLalonde/Power_Selector/KiCad_Library/3D_Model/IC/SOT-89.step

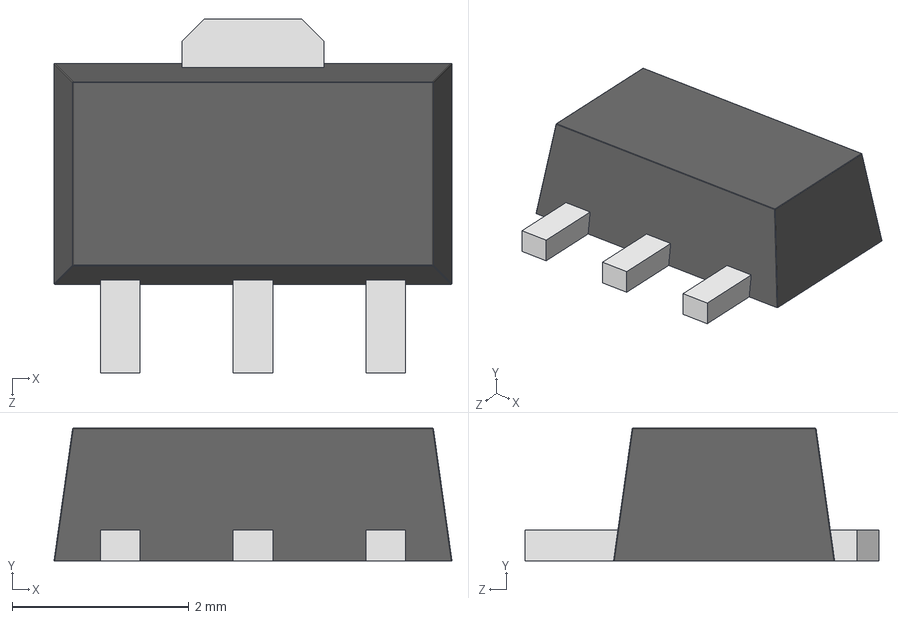
[picture p120: CAD file, 2023-07-19]
KiCad_Library/3D_Model/IC/SOT-89.step
4.50 x 1.50 x 4.00 mm
