KevinLalonde/Power_Selector/KiCad_Library/3D_Model/Diodes/DO-214AC_SMA.step

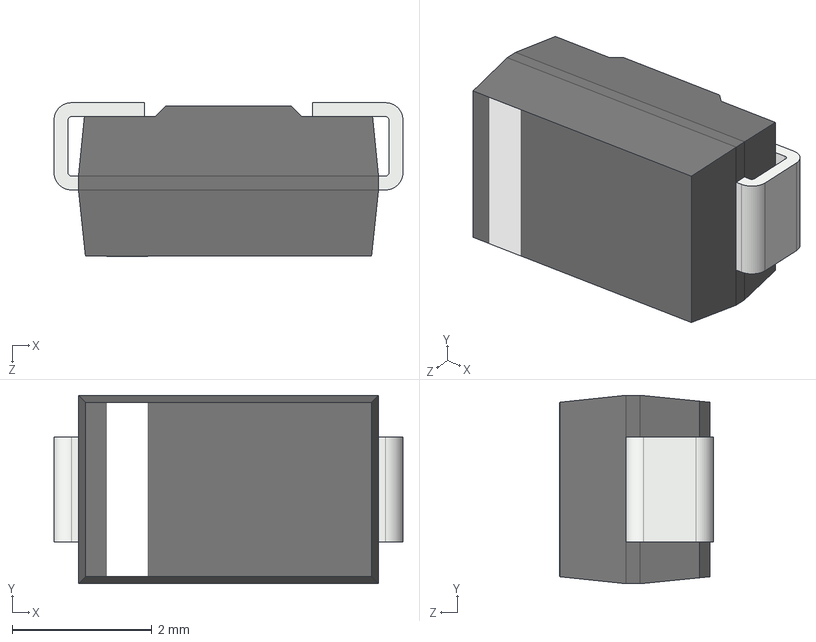
[picture p122: CAD file, 2023-07-19]
KiCad_Library/3D_Model/Diodes/DO-214AC_SMA.step
5.00 x 2.70 x 2.20 mm
