KevinLalonde/Power_Selector/KiCad_Library/3D_Model/IC/Vicor_Micro.STP

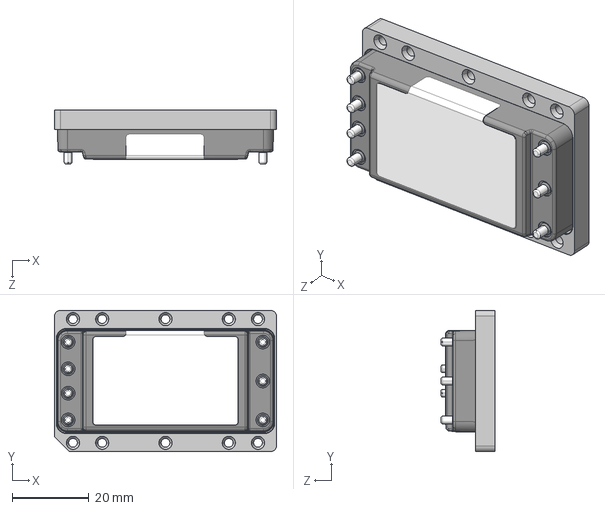
[picture p123: CAD file, 2023-07-19]
KiCad_Library/3D_Model/IC/Vicor_Micro.STP
57.9 x 36.8 x 14.0 mm
