KevinLalonde/Power_Selector/KiCad_Library/3D_Model/Diodes/R-6.step

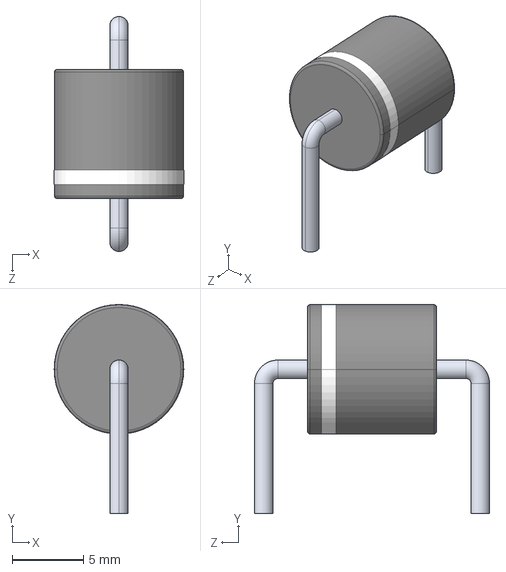
[picture p125: CAD file, 2023-07-19]
KiCad_Library/3D_Model/Diodes/R-6.step
9.12 x 14.7 x 16.5 mm
