KevinLalonde/Power_Selector/KiCad_Library/3D_Model/IC/VSSOP-10.step

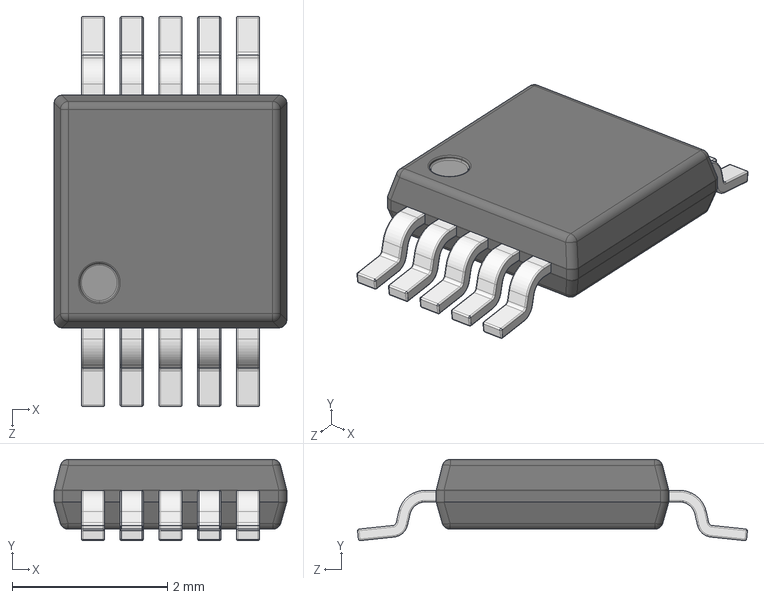
[picture p126: CAD file, 2023-07-19]
KiCad_Library/3D_Model/IC/VSSOP-10.step
3.00 x 1.05 x 5.03 mm
