KevinLalonde/Power_Selector/KiCad_Library/3D_Model/Diodes/SOD-923.step

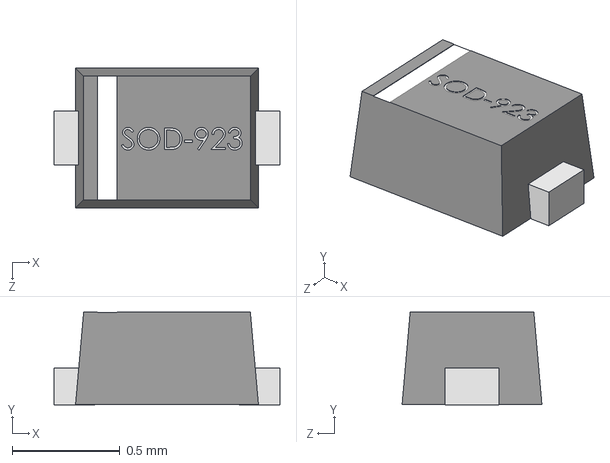
[picture p129: CAD file, 2023-07-19]
KiCad_Library/3D_Model/Diodes/SOD-923.step
1.05 x 0.43 x 0.65 mm
