KevinLalonde/Power_Selector/KiCad_Library/3D_Model/IC/TO-263-7.step

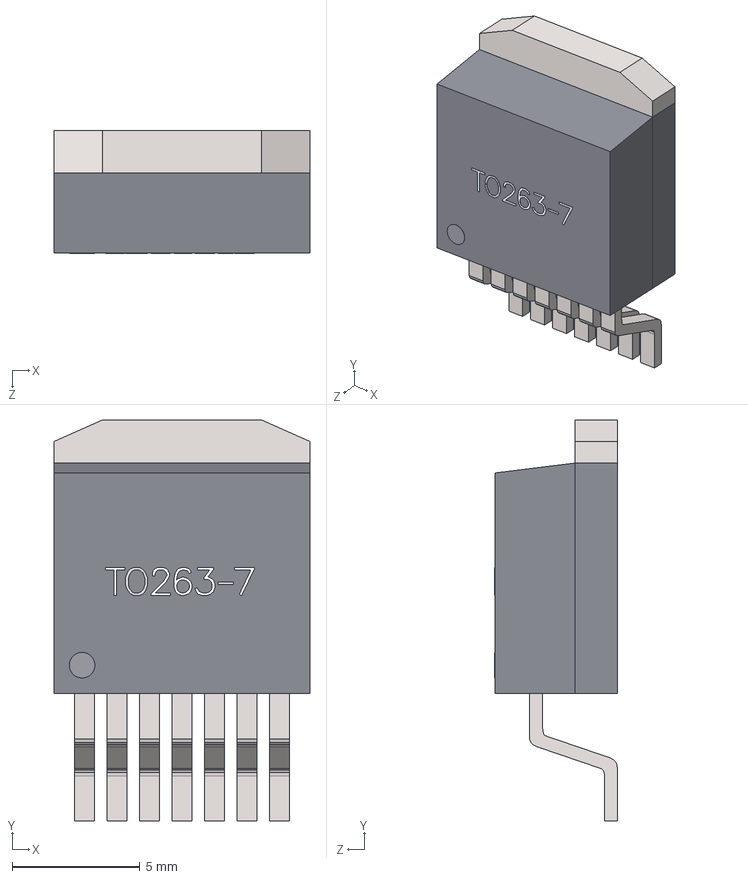
[picture p130: CAD file, 2023-07-19]
KiCad_Library/3D_Model/IC/TO-263-7.step
10.0 x 15.7 x 4.80 mm
SW3dPS-TO263-7-1_Board8
SW3dPS-TO263-7-1_Board7
SW3dPS-TO263-7-1_Extruded15
SW3dPS-TO263-7-1_Extruded11
SW3dPS-TO263-7-1_Extruded19
SW3dPS-TO263-7-1_Board5
SW3dPS-TO263-7-1_Board9
SW3dPS-TO263-7-1_Extruded17
SW3dPS-TO263-7-1_Extruded14 x 7
SW3dPS-TO263-7-1_Board6 x 7
SW3dPS-TO263-7-1_Extruded18
SW3dPS-TO263-7-1_Extruded20
SW3dPS-TO263-7-1_Extruded16
SW3dPS-TO263-7-1_Cylinder1
SW3dPS-TO263-7-1_Extruded13
SW3dPS-TO263-7-1_Extruded12
SW3dPS-TO263-7-1_Extruded21
