KevinLalonde/Power_Selector/KiCad_Library/3D_Model/Diodes/qwerrewwee.FCStd

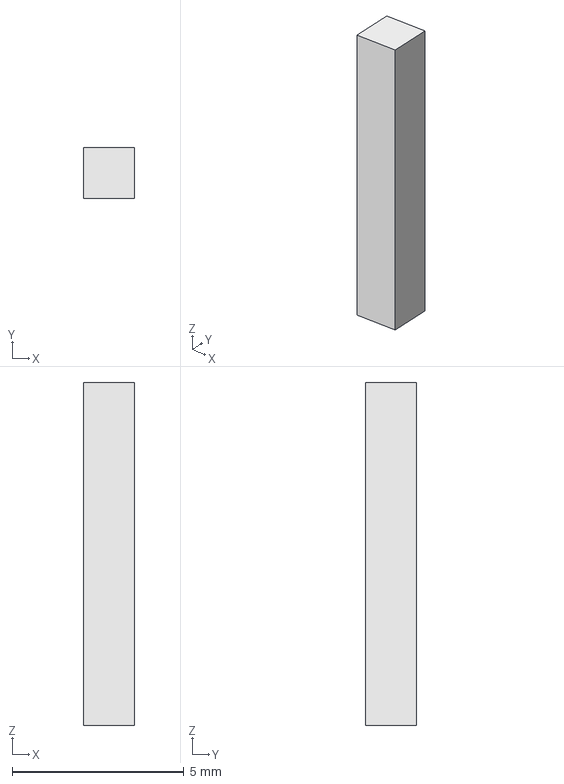
[picture p131: CAD file, 2023-07-19]
KiCad_Library/3D_Model/Diodes/qwerrewwee.FCStd
1.50 x 1.50 x 10.0 mm
