KevinLalonde/Power_Selector/KiCad_Library/3D_Model/IC/LQFP-64.step

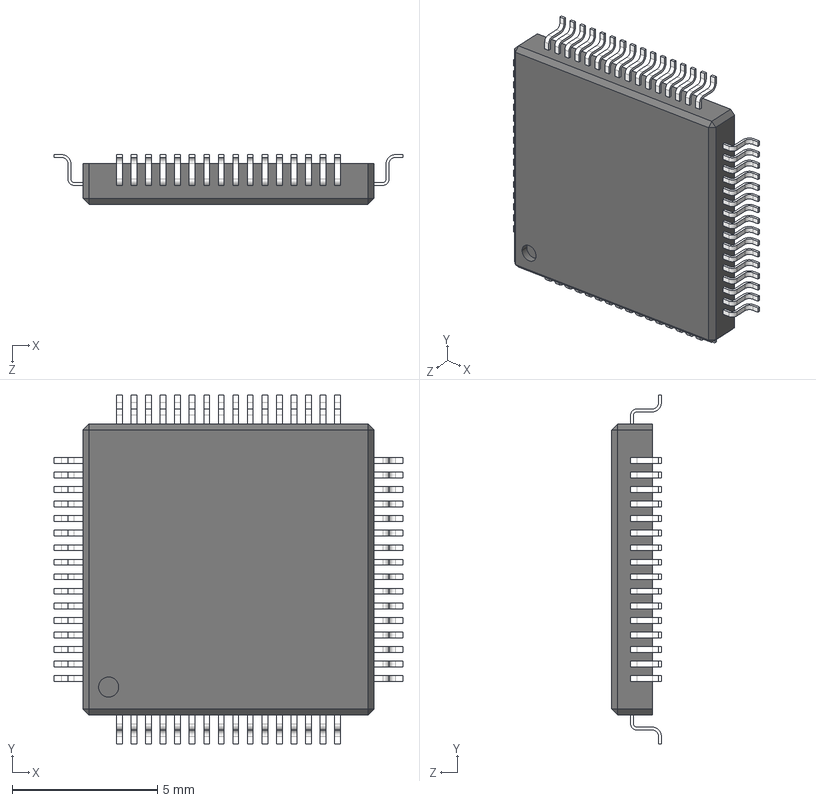
[picture p132: CAD file, 2023-07-19]
KiCad_Library/3D_Model/IC/LQFP-64.step
12.0 x 12.0 x 1.71 mm
