KevinLalonde/Power_Selector/KiCad_Library/3D_Model/Diodes/4-sip_KBU.step

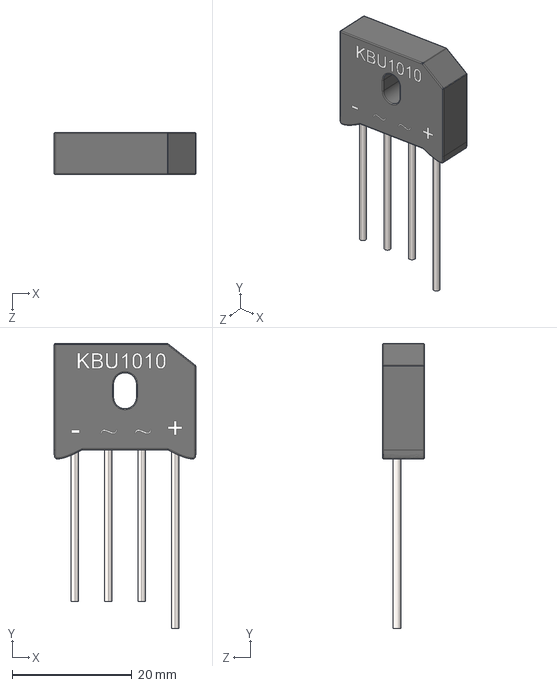
[picture p133: CAD file, 2023-07-19]
KiCad_Library/3D_Model/Diodes/4-sip_KBU.step
23.7 x 47.7 x 7.10 mm
