KevinLalonde/Power_Selector/KiCad_Library/3D_Model/IC/SOT-23-6.step

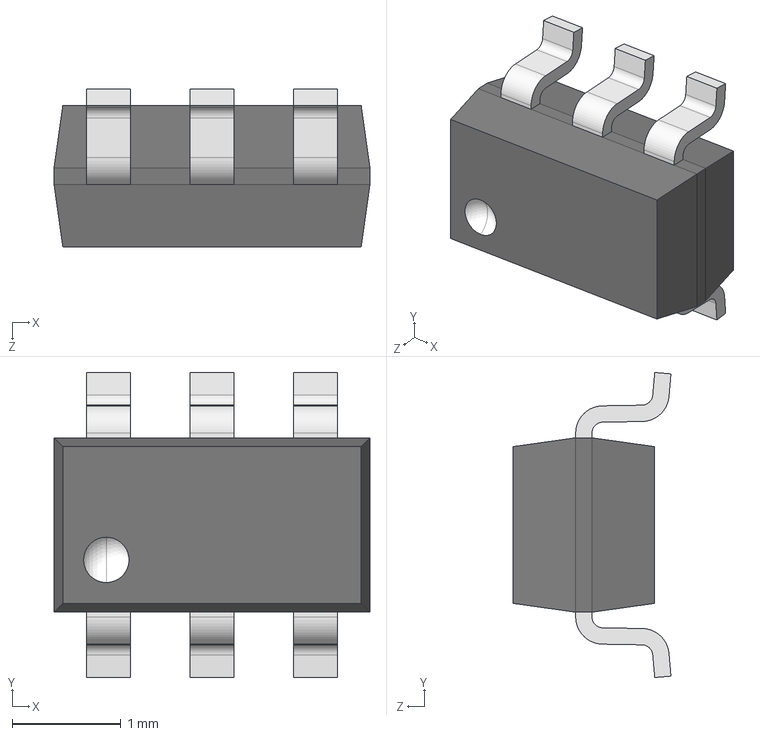
[picture p134: CAD file, 2023-07-19]
KiCad_Library/3D_Model/IC/SOT-23-6.step
2.90 x 2.80 x 1.45 mm
