KevinLalonde/Power_Selector/KiCad_Library/3D_Model/Diodes/D-FLAT.step

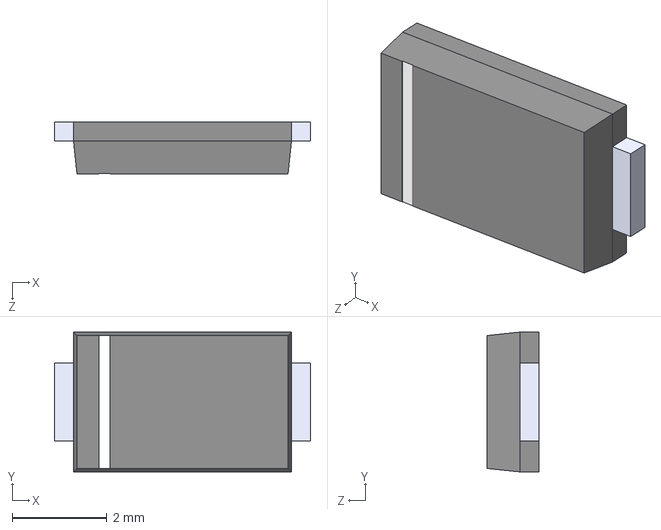
[picture p136: CAD file, 2023-07-19]
KiCad_Library/3D_Model/Diodes/D-FLAT.step
5.40 x 2.95 x 1.10 mm
