KevinLalonde/Power_Selector/KiCad_Library/3D_Model/Diodes/SOD-128.step

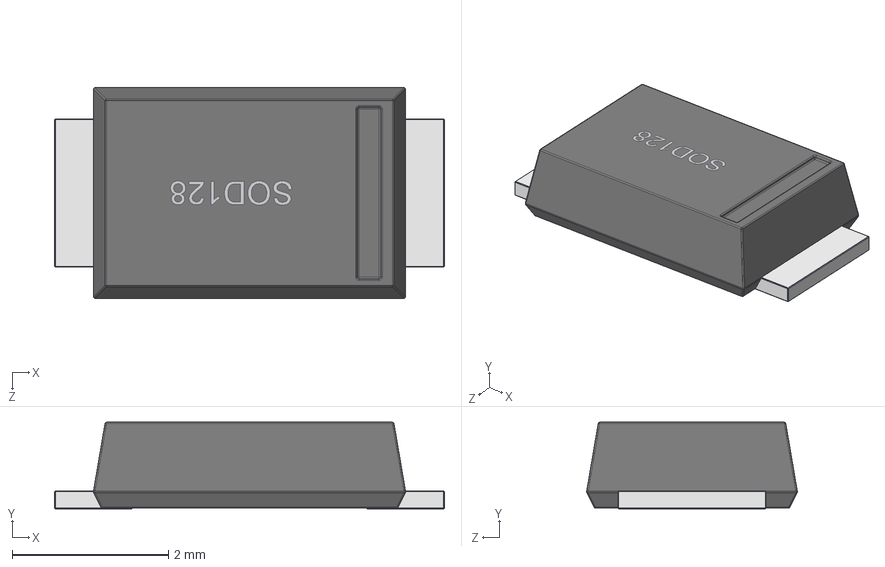
[picture p138: CAD file, 2023-07-19]
KiCad_Library/3D_Model/Diodes/SOD-128.step
5.00 x 1.11 x 2.70 mm
