KevinLalonde/Power_Selector/KiCad_Library/3D_Model/Diodes/TO-263.stp

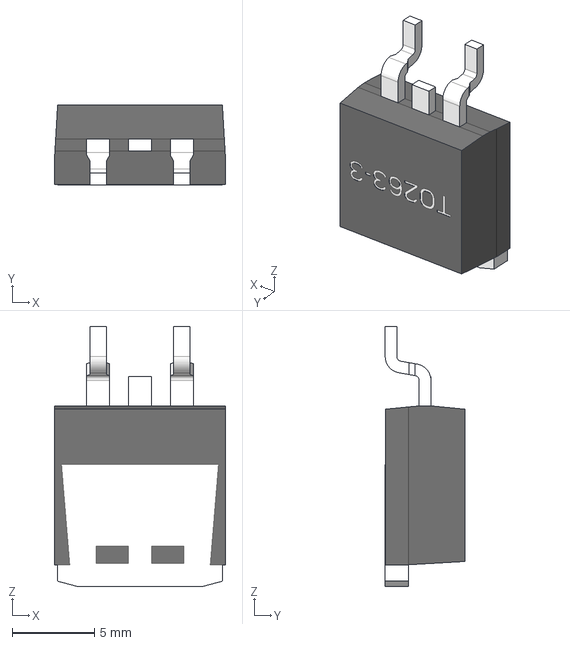
[picture p140: CAD file, 2023-07-19]
KiCad_Library/3D_Model/Diodes/TO-263.stp
10.4 x 4.84 x 15.8 mm
