KevinLalonde/Power_Selector/KiCad_Library/3D_Model/IC/TSSOP-14.step

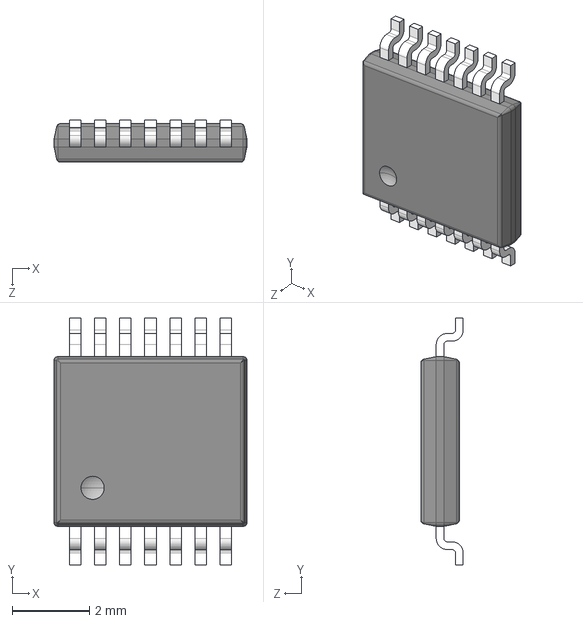
[picture p141: CAD file, 2023-07-19]
KiCad_Library/3D_Model/IC/TSSOP-14.step
5.00 x 6.40 x 1.10 mm
