KevinLalonde/Power_Selector/KiCad_Library/3D_Model/Diodes/4-square.step

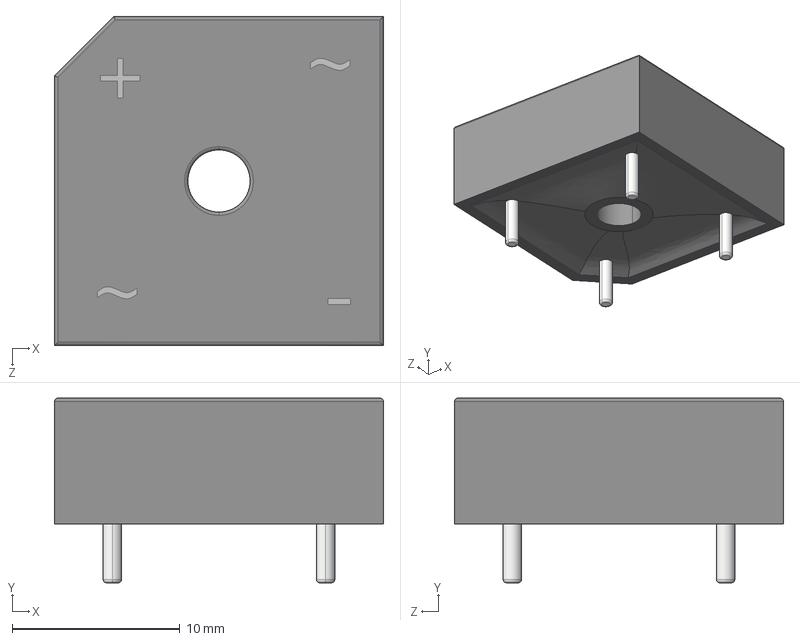
[picture p142: CAD file, 2023-07-19]
KiCad_Library/3D_Model/Diodes/4-square.step
19.6 x 11.0 x 19.6 mm
