KevinLalonde/Power_Selector/KiCad_Library/3D_Model/IC/Vicor VI-200.stp

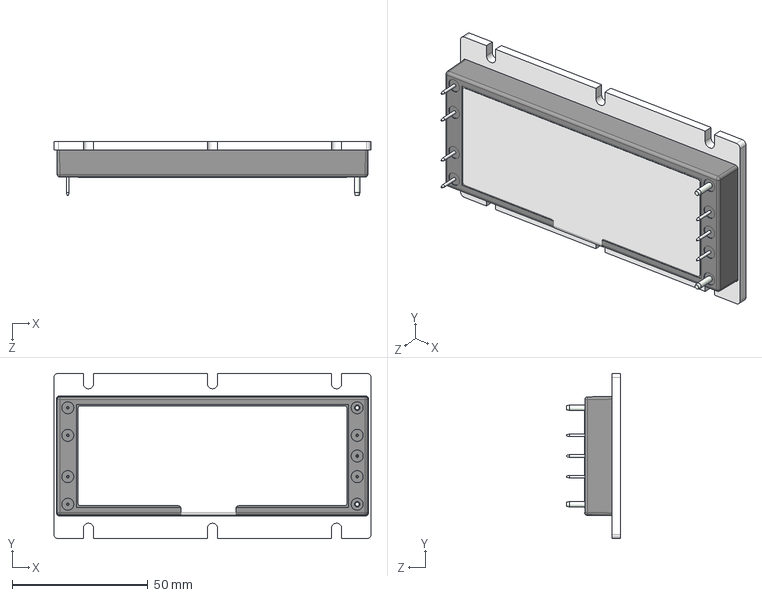
[picture p143: CAD file, 2023-07-19]
KiCad_Library/3D_Model/IC/Vicor VI-200.stp
116.8 x 61.0 x 19.8 mm
