KevinLalonde/Power_Selector/KiCad_Library/3D_Model/Connectors/male_header_2_54_1X7.step

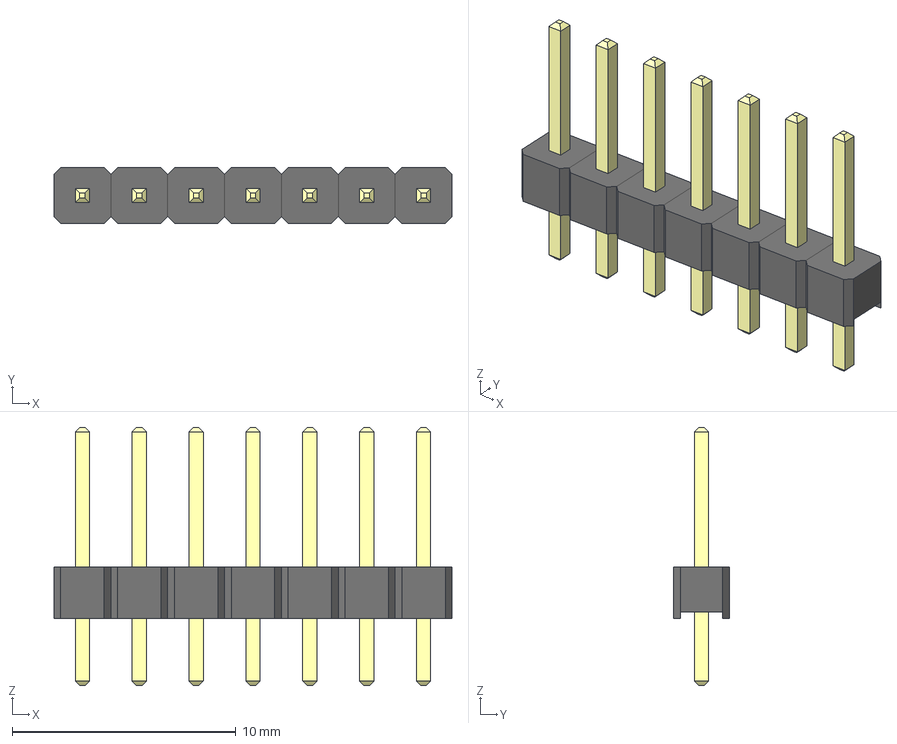
[picture p144: CAD file, 2023-07-19]
KiCad_Library/3D_Model/Connectors/male_header_2_54_1X7.step
17.8 x 2.49 x 11.5 mm
User_Library-Header_Male_40Pin_PinArray032
User_Library-Header_Male_40Pin_PinArray021
User_Library-Header_Male_40Pin_PinArray017
User_Library-Header_Male_40Pin_PinArray016
User_Library-Header_Male_40Pin_PinArray013
User_Library-Header_Male_40Pin_BodyArray025
User_Library-Header_Male_40Pin_BodyArray002
User_Library-Header_Male_40Pin_BodyArray010
User_Library-Header_Male_40Pin_BodyArray004
User_Library-Header_Male_40Pin_BodyArray028
User_Library-Header_Male_40Pin_BodyArray036
User_Library-Header_Male_40Pin_BodyArray037
User_Library-Header_Male_40Pin_PinArray007
User_Library-Header_Male_40Pin_PinArray011
