KevinLalonde/Power_Selector/KiCad_Library/3D_Model/Diodes/XSxx43.step

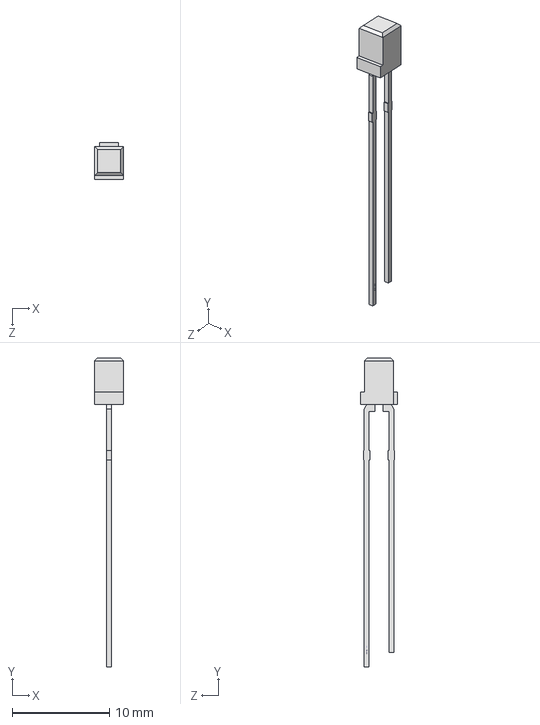
[picture p145: CAD file, 2023-07-19]
KiCad_Library/3D_Model/Diodes/XSxx43.step
3.00 x 31.8 x 3.80 mm
