KevinLalonde/Power_Selector/KiCad_Library/3D_Model/IC/SO-8.step

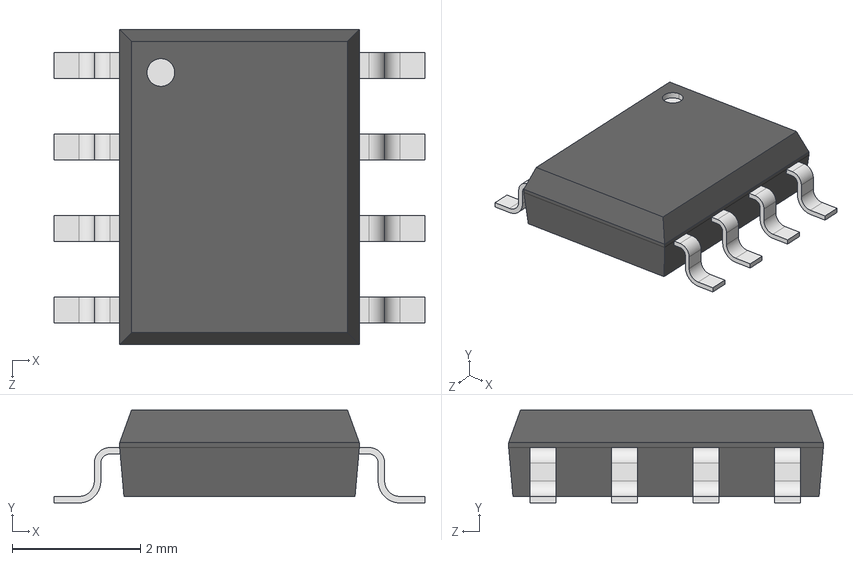
[picture p146: CAD file, 2023-07-19]
KiCad_Library/3D_Model/IC/SO-8.step
5.78 x 1.45 x 4.90 mm
