KevinLalonde/Power_Selector/KiCad_Library/3D_Model/Connectors/male_header_2_54_1X1.step

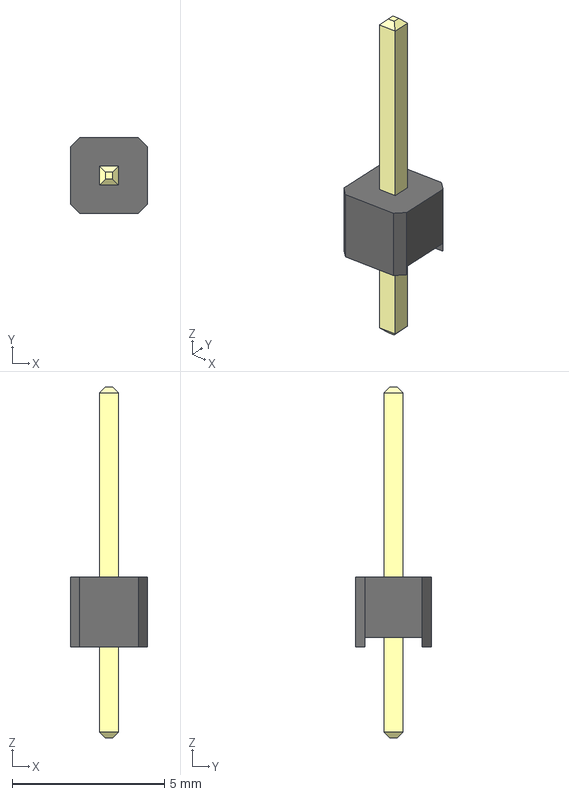
[picture p147: CAD file, 2023-07-19]
KiCad_Library/3D_Model/Connectors/male_header_2_54_1X1.step
2.54 x 2.49 x 11.5 mm
User_Library-Header_Male_40Pin_PinArray013
User_Library-Header_Male_40Pin_BodyArray037
