KevinLalonde/Power_Selector/KiCad_Library/3D_Model/IC/TO-220.step

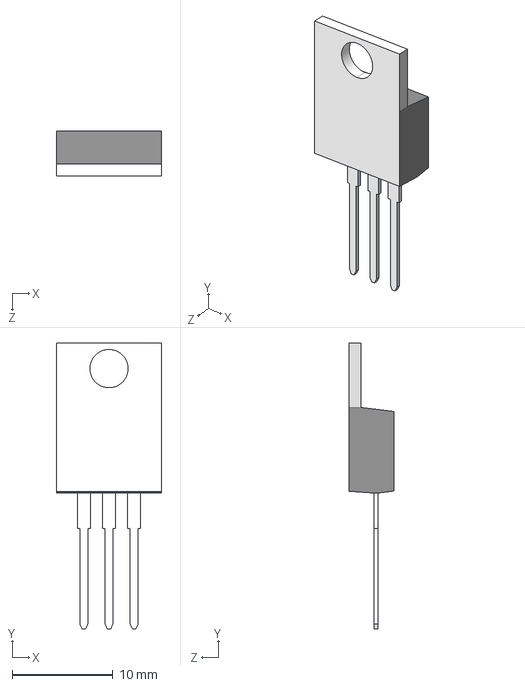
[picture p148: CAD file, 2023-07-19]
KiCad_Library/3D_Model/IC/TO-220.step
10.4 x 28.4 x 4.50 mm
