KevinLalonde/Power_Selector/KiCad_Library/3D_Model/Connectors/TSW-125-14-F-D.stp

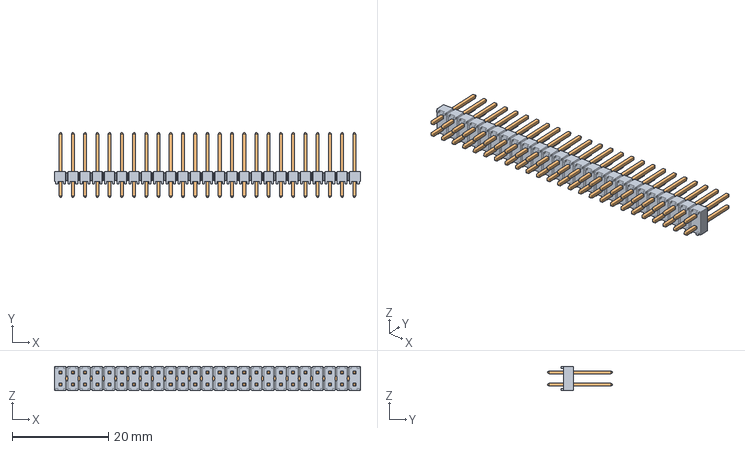
[picture p149: CAD file, 2023-07-19]
KiCad_Library/3D_Model/Connectors/TSW-125-14-F-D.stp
63.5 x 13.5 x 5.08 mm
_TSW-125-14-F-D_body
_T-1S6-08-TSW-1-14-25-D
