KevinLalonde/Power_Selector/KiCad_Library/3D_Model/IC/MSOP-8.step

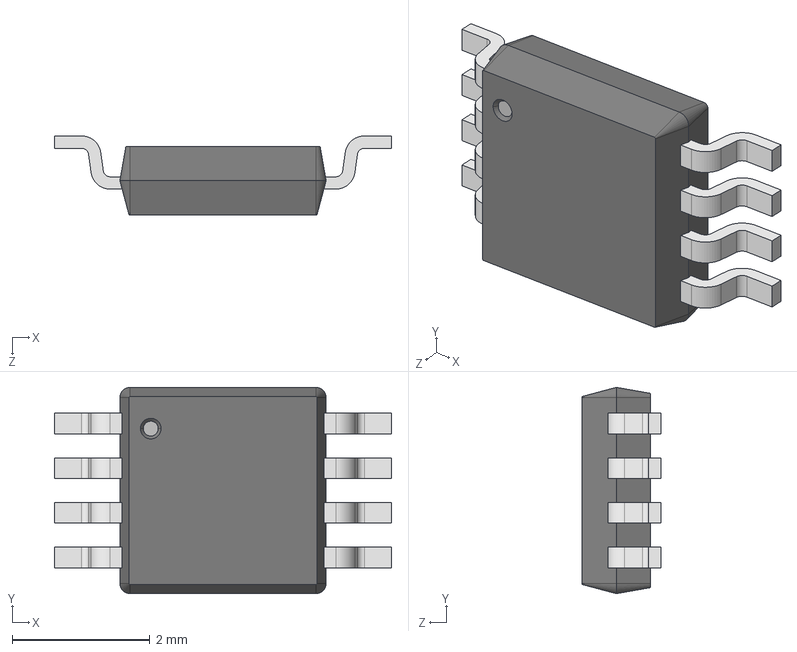
[picture p150: CAD file, 2023-07-19]
KiCad_Library/3D_Model/IC/MSOP-8.step
4.90 x 3.00 x 1.15 mm
