KevinLalonde/Power_Selector/KiCad_Library/3D_Model/IC/ten8wi.stp

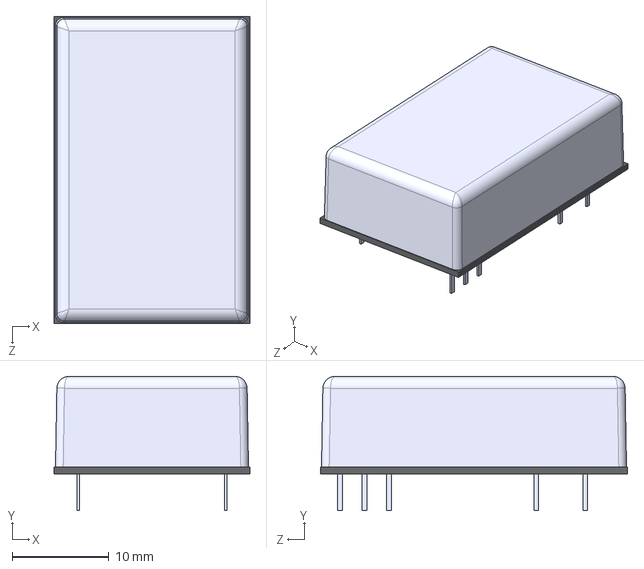
[picture p152: CAD file, 2023-07-19]
KiCad_Library/3D_Model/IC/ten8wi.stp
20.3 x 13.9 x 31.8 mm
