KevinLalonde/Power_Selector/KiCad_Library/3D_Model/IC/MSOP-12.step

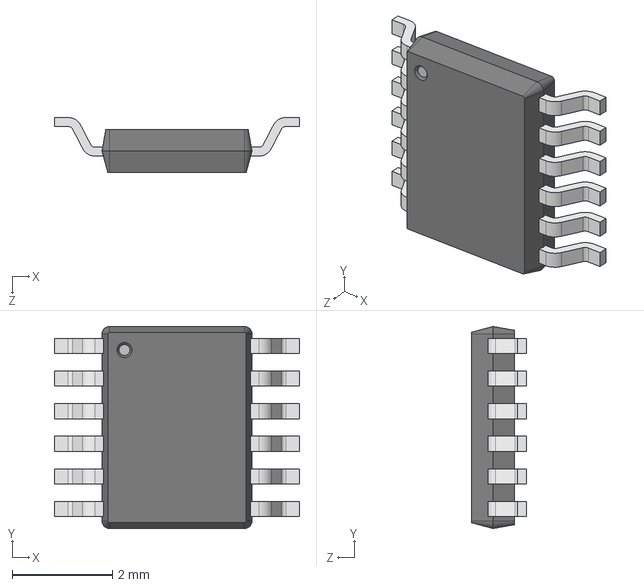
[picture p154: CAD file, 2023-07-19]
KiCad_Library/3D_Model/IC/MSOP-12.step
4.90 x 4.04 x 1.10 mm
