KevinLalonde/Power_Selector/KiCad_Library/3D_Model/IC/tmr6wir_3d_drawing.stp

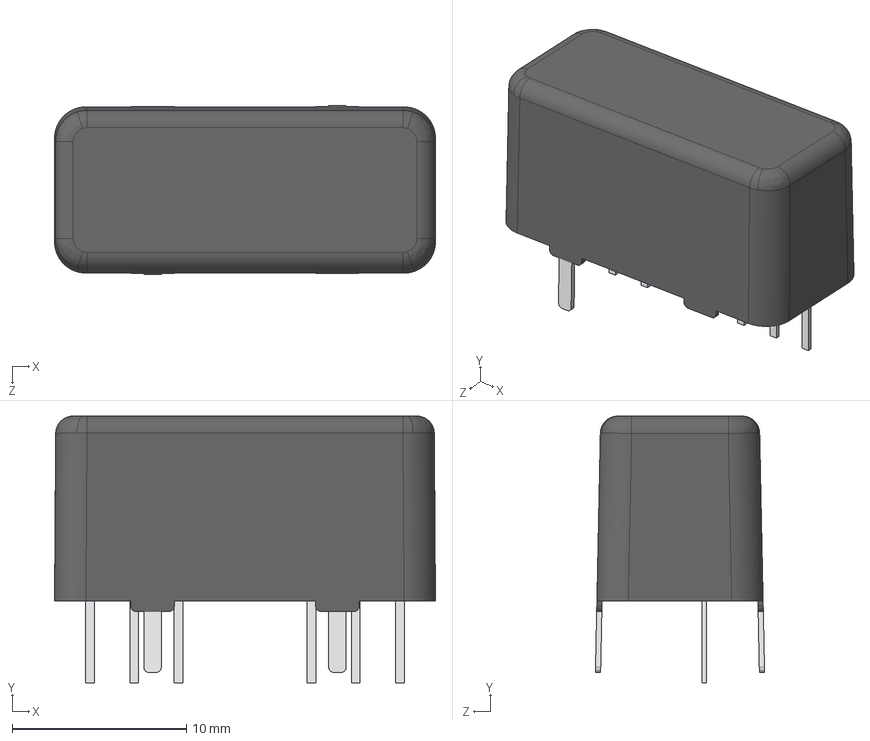
[picture p158: CAD file, 2023-07-19]
KiCad_Library/3D_Model/IC/tmr6wir_3d_drawing.stp
21.8 x 15.3 x 9.70 mm
