KevinLalonde/Power_Selector/KiCad_Library/3D_Model/IC/4-SOP.step

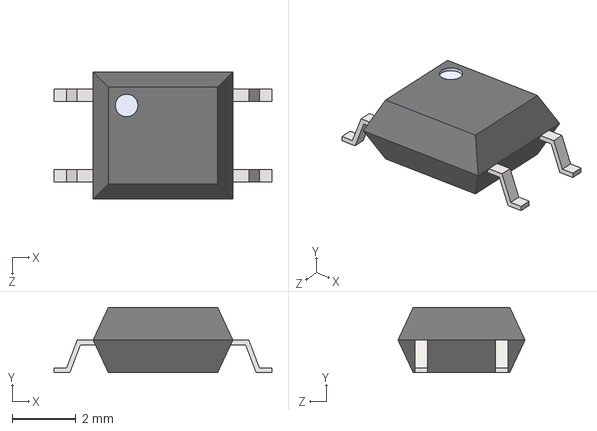
[picture p160: CAD file, 2023-07-19]
KiCad_Library/3D_Model/IC/4-SOP.step
6.86 x 2.05 x 4.00 mm
