KevinLalonde/Power_Selector/KiCad_Library/3D_Model/IC/SOT-23-5.step

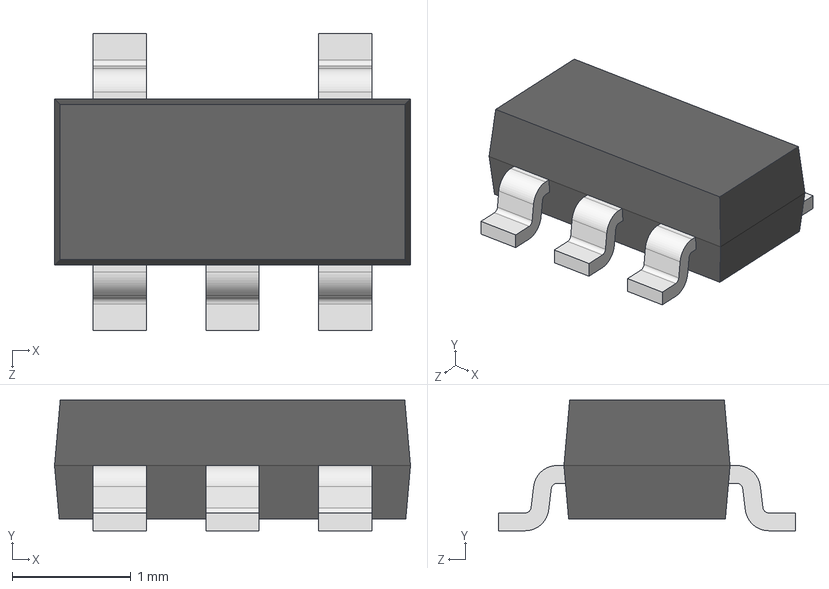
[picture p161: CAD file, 2023-07-19]
KiCad_Library/3D_Model/IC/SOT-23-5.step
3.00 x 1.10 x 2.50 mm
