KevinLalonde/Power_Selector/KiCad_Library/3D_Model/IC/TSSOP-28.STEP

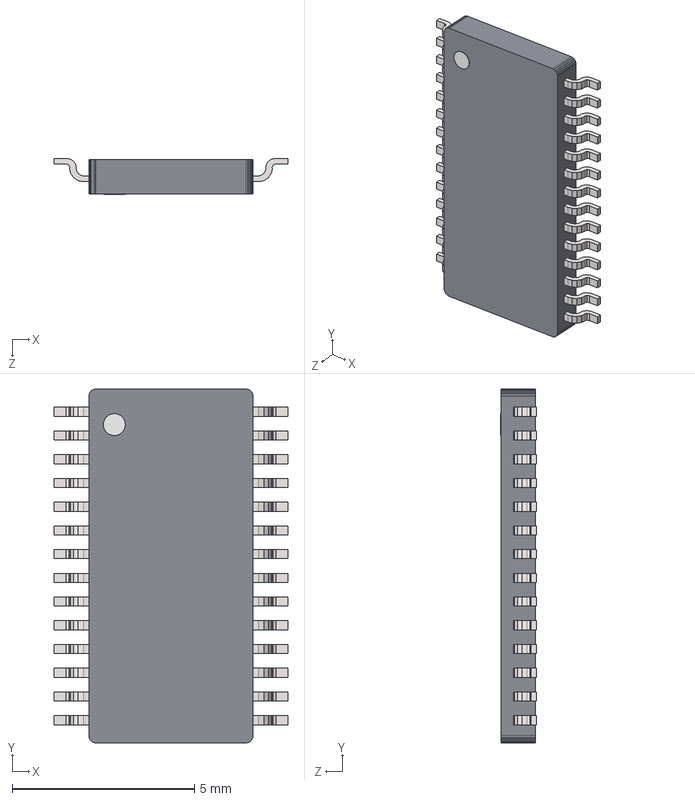
[picture p162: CAD file, 2023-07-19]
KiCad_Library/3D_Model/IC/TSSOP-28.STEP
6.40 x 9.70 x 0.989 mm
SW3dPS-TSSOP-28_P065_Board3 x 28
SW3dPS-TSSOP-28_P065_Extruded3 x 28
SW3dPS-TSSOP-28_P065_Extruded2
SW3dPS-TSSOP-28_P065_Cylinder1
SW3dPS-TSSOP-28_P065_Board2
