KevinLalonde/Power_Selector/KiCad_Library/3D_Model/IC/SSOP-24.step

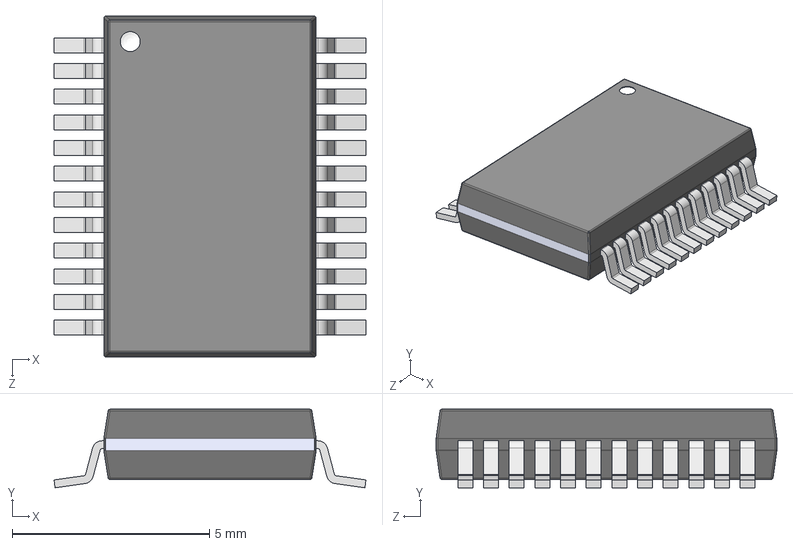
[picture p163: CAD file, 2023-07-19]
KiCad_Library/3D_Model/IC/SSOP-24.step
7.90 x 1.99 x 8.63 mm
