KevinLalonde/Power_Selector/KiCad_Library/3D_Model/IC/SOT-223.step

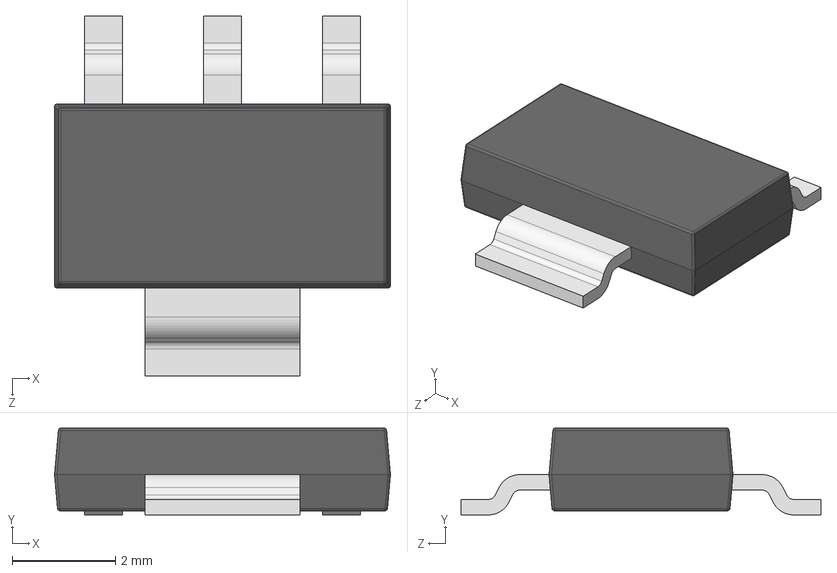
[picture p165: CAD file, 2023-07-19]
KiCad_Library/3D_Model/IC/SOT-223.step
6.50 x 1.68 x 6.96 mm
