KevinLalonde/Power_Selector/KiCad_Library/3D_Model/Connectors/CT3149-X.stp

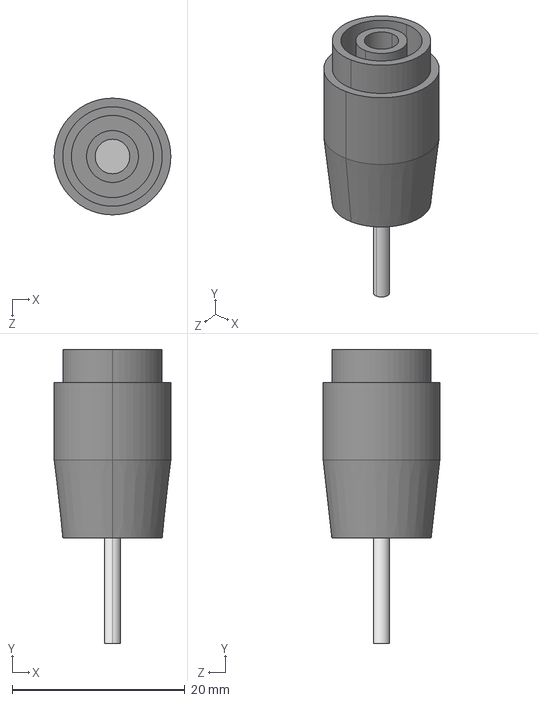
[picture p166: CAD file, 2023-07-19]
KiCad_Library/3D_Model/Connectors/CT3149-X.stp
13.5 x 34.0 x 13.5 mm
