KevinLalonde/Power_Selector/KiCad_Library/3D_Model/IC/MSOP-16.step

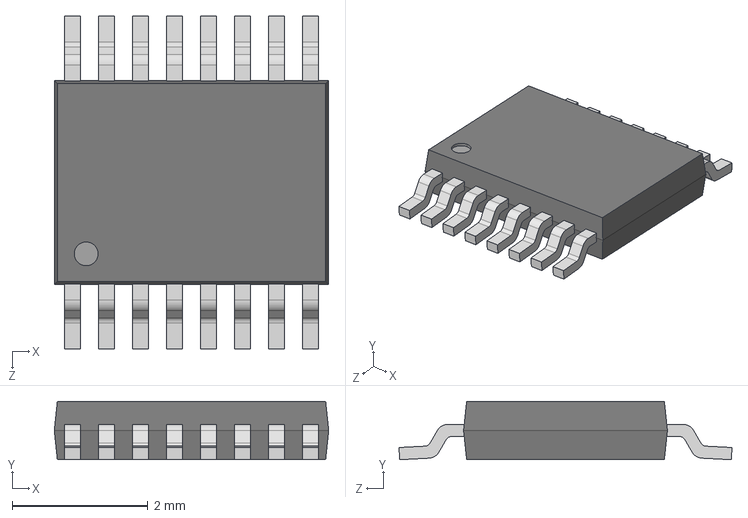
[picture p167: CAD file, 2023-07-19]
KiCad_Library/3D_Model/IC/MSOP-16.step
4.04 x 0.86 x 4.90 mm
