KevinLalonde/Power_Selector/KiCad_Library/3D_Model/IC/SSOP-20.step

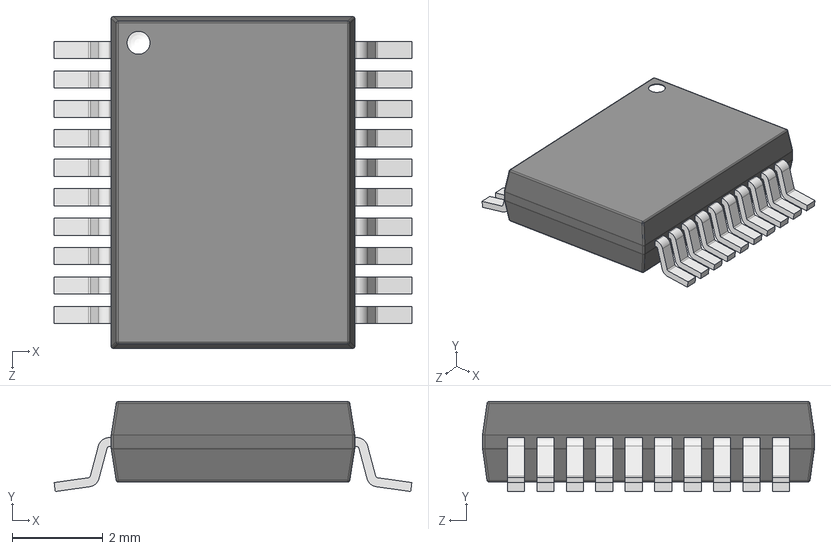
[picture p169: CAD file, 2023-07-19]
KiCad_Library/3D_Model/IC/SSOP-20.step
7.90 x 1.99 x 7.33 mm
