KevinLalonde/Power_Selector/KiCad_Library/3D_Model/IC/ncs1.step

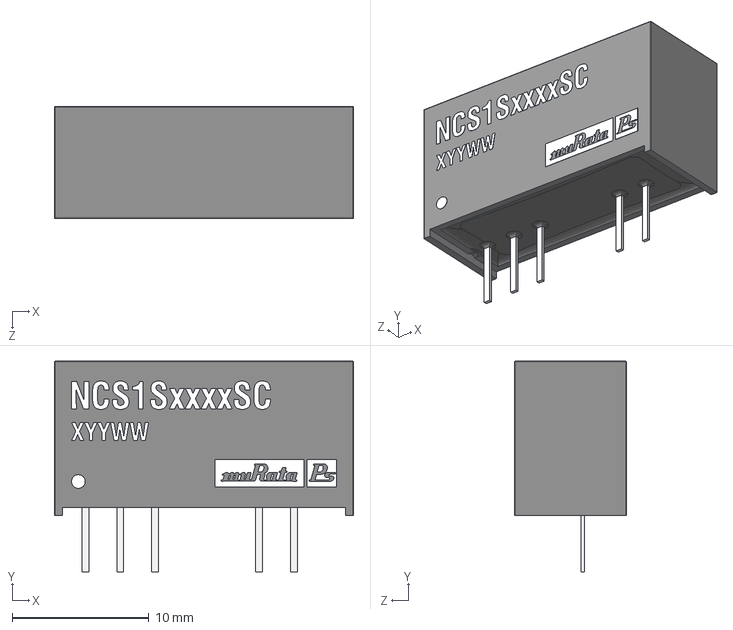
[picture p170: CAD file, 2023-07-19]
KiCad_Library/3D_Model/IC/ncs1.step
21.9 x 15.4 x 8.22 mm
