KevinLalonde/Power_Selector/(list of files, cad)

Other CAD files:
KiCad_Library/3D_Model/Diodes/WL_SMCW-0805_YELLOW.stp
KiCad_Library/3D_Model/Relays/c-2-1462039-9-b5-3d.stp
KiCad_Library/3D_Model/IC/COMPOUND-23.step.SLDPRT
KiCad_Library/3D_Model/Diodes/WL_SMCW-0805_GREEN.stp
KiCad_Library/3D_Model/Diodes/WL_SMCW-0805_BLUE.stp
KiCad_Library/3D_Model/Diodes/WL-SMCW-0805.stp
KiCad_Library/3D_Model/IC/SOLID-11.step.SLDPRT
KiCad_Library/3D_Model/Assembly/ACZ11BR4E.stp
KiCad_Library/3D_Model/Connectors/1050170001.STEP
KiCad_Library/3D_Model/Connectors/1694224.stp
KiCad_Library/3D_Model/Connectors/1694240.stp
KiCad_Library/3D_Model/Connectors/1720466_PXC.step
KiCad_Library/3D_Model/Connectors/1935161.stp
KiCad_Library/3D_Model/Connectors/1935174.stp
KiCad_Library/3D_Model/Connectors/1935187.stp
KiCad_Library/3D_Model/Connectors/61300211021_STP_61300211021_rev1.stp
KiCad_Library/3D_Model/Connectors/61400413321.stp
KiCad_Library/3D_Model/Connectors/61400416121.stp
KiCad_Library/3D_Model/Connectors/61900611121.step
KiCad_Library/3D_Model/Connectors/64900221122.stp
KiCad_Library/3D_Model/Connectors/649002227222.stp
KiCad_Library/3D_Model/Connectors/64900311122.step
KiCad_Library/3D_Model/Connectors/64900311122.stp
KiCad_Library/3D_Model/Connectors/649003127222.stp
KiCad_Library/3D_Model/Connectors/649004127222 (rev1).stp
KiCad_Library/3D_Model/Connectors/649004227222.stp
KiCad_Library/3D_Model/Connectors/64900621122.stp
KiCad_Library/3D_Model/Connectors/649006227222.stp
KiCad_Library/3D_Model/Connectors/649008227222.stp
KiCad_Library/3D_Model/Connectors/649012227222.stp
KiCad_Library/3D_Model/Connectors/649016227222.stp
KiCad_Library/3D_Model/Connectors/649022227222.stp
KiCad_Library/3D_Model/Connectors/691317710003.stp
KiCad_Library/3D_Model/Connectors/691317710004.stp
KiCad_Library/3D_Model/Connectors/Editable-Header_Male_40Pin.STEP
KiCad_Library/3D_Model/Connectors/TORX1350A_F_.stp
KiCad_Library/3D_Model/Connectors/TOTX1350_V,F_.stp
KiCad_Library/3D_Model/Connectors/Test_Point_Keystone_5001_BLACK.STEP
KiCad_Library/3D_Model/Connectors/male_header_2_54_1X10.step
KiCad_Library/3D_Model/Connectors/male_header_2_54_1X12.step
KiCad_Library/3D_Model/Connectors/male_header_2_54_1X15.step
KiCad_Library/3D_Model/Connectors/male_header_2_54_1X17.step
KiCad_Library/3D_Model/Connectors/male_header_2_54_1X18.step
KiCad_Library/3D_Model/Connectors/male_header_2_54_1X19.step
KiCad_Library/3D_Model/Connectors/male_header_2_54_1X2.step
KiCad_Library/3D_Model/Connectors/male_header_2_54_1X21.step
KiCad_Library/3D_Model/Connectors/male_header_2_54_1X23.step
KiCad_Library/3D_Model/Connectors/male_header_2_54_1X25.step
KiCad_Library/3D_Model/Connectors/male_header_2_54_1X3.step
KiCad_Library/3D_Model/Connectors/male_header_2_54_1X32.step
KiCad_Library/3D_Model/Connectors/male_header_2_54_1X33.step
KiCad_Library/3D_Model/Connectors/male_header_2_54_1X34.step
KiCad_Library/3D_Model/Connectors/male_header_2_54_1X35.step
KiCad_Library/3D_Model/Connectors/male_header_2_54_1X3_angle.step
KiCad_Library/3D_Model/Connectors/male_header_2_54_1X6.step
KiCad_Library/3D_Model/Connectors/male_header_2_54_1X6_angle.step
KiCad_Library/3D_Model/Connectors/male_header_2_54_1X8.step
KiCad_Library/3D_Model/IC/COMPOUND-24.step.SLDPRT
KiCad_Library/3D_Model/IC/COMPOUND-3.step.SLDPRT
KiCad_Library/3D_Model/IC/CQB60W-110S24.stp
KiCad_Library/3D_Model/IC/DPAK-5L.stp
KiCad_Library/3D_Model/IC/GPS_sam-m8q.STEP
KiCad_Library/3D_Model/IC/LQFP64.step
KiCad_Library/3D_Model/IC/MCP6002-I_SN.stp
KiCad_Library/3D_Model/IC/SC70-4.step
KiCad_Library/3D_Model/IC/SN74HCS08QDRQ1.stp
KiCad_Library/3D_Model/IC/SOIC-8.step
KiCad_Library/3D_Model/IC/SOLID-10.step.SLDPRT
KiCad_Library/3D_Model/IC/SOLID-12.step.SLDPRT
KiCad_Library/3D_Model/IC/SOT-23-3.step
KiCad_Library/3D_Model/IC/TO-220-7.step
KiCad_Library/3D_Model/IC/TO-263-3.step
KiCad_Library/3D_Model/IC/TO-263-5.step
KiCad_Library/3D_Model/IC/TO-263.step
KiCad_Library/3D_Model/IC/TO-3P(N).step
KiCad_Library/3D_Model/IC/TSOT-23-6.step
KiCad_Library/3D_Model/IC/TSSOP-16.step
KiCad_Library/3D_Model/IC/VSSOP-8_DGK.STEP
KiCad_Library/3D_Model/IC/Vicor_Mini.step
KiCad_Library/3D_Model/IC/tmr6wir.stp
KiCad_Library/3D_Model/Switches/416131160803.stp
