KevinLalonde/Power_Selector/Power Selector Board/Power Selector.kicad_pcb

## KiCad design Power Selector Board/Power Selector.kicad_pcb (2023-08-22)

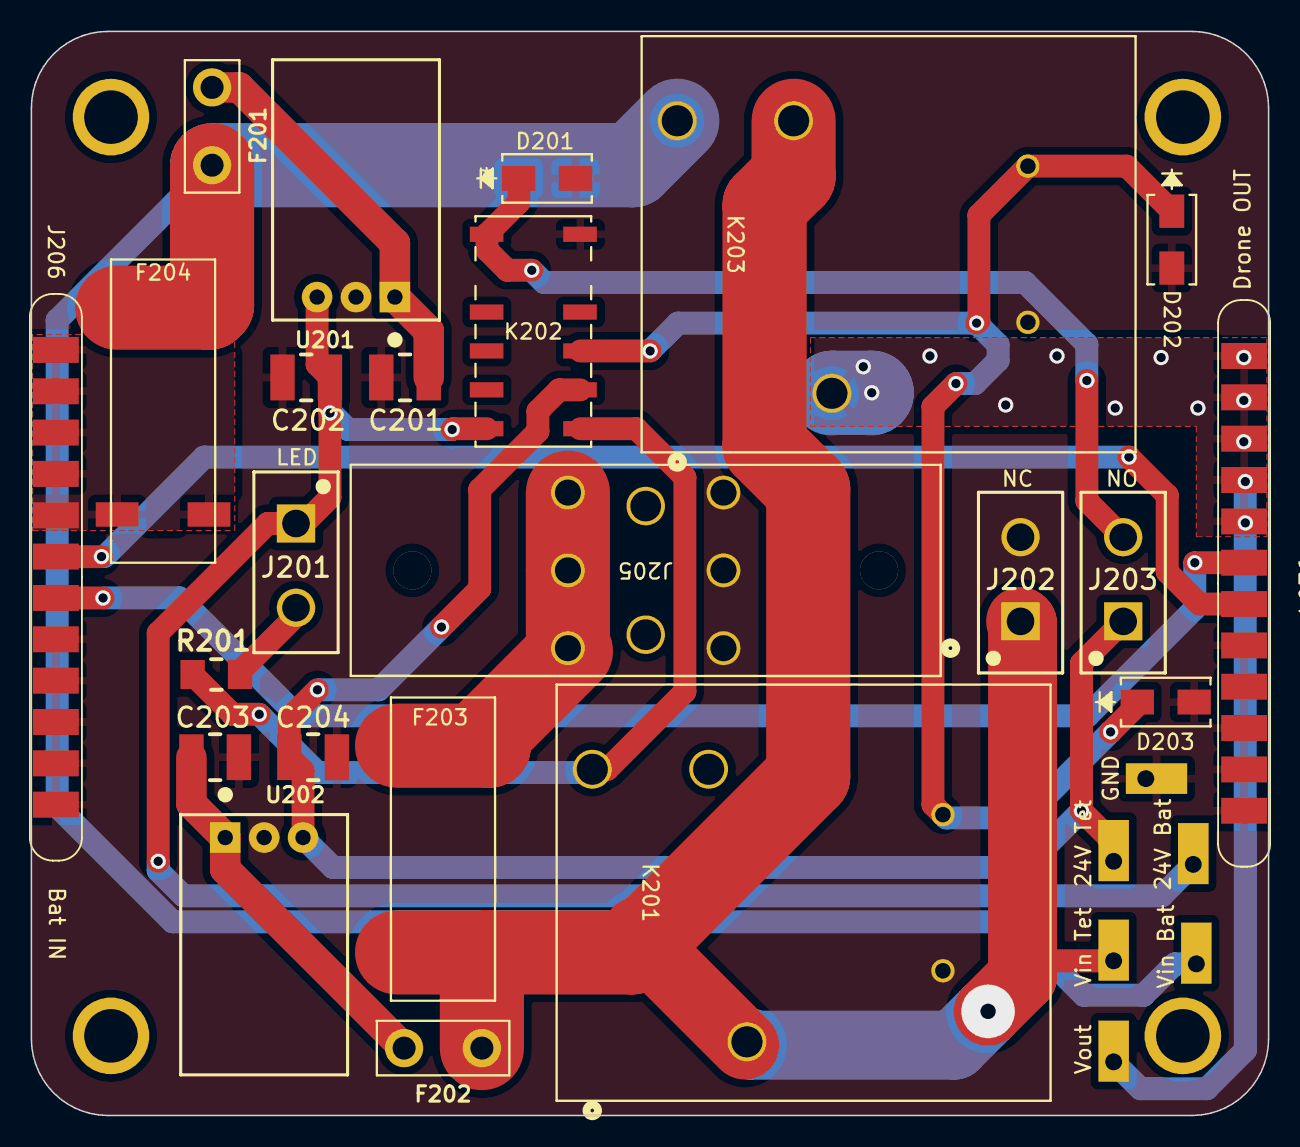
[picture p171: board Power Selector.kicad_pcb from above]

Board: 2 copper layers, 80.8 x 70.8 mm, 33 parts (0 on the bottom side), 16 nets.

Parts:
C201, C202, C203, C204: GRM32EC72A106ME05L; C1210
D201, D202, D203: S1D-13-F; SMA_DIO
F201, F202: 0698Q2000-02; TE5_395
F203, F204: 047706.3MRET1P; 3587TR
H1, H2, H3, H4: Mounting-Hole-M3; Mounting_Hole_3mm
J201, J202, J203: 64900221122
J204: MSD-DB01M-12P; MSD-DB01F-12P-V2.0
J205: 1998865
J206: MSD-DB01F-12P_1; MSD-DB01F-12P-V2.0
K201, K203: J115F11C24VDCSH.9; RELAY5_J115F11C24VDCSH.9_CRS
K202: G6SK-2G DC24; G6SK-2G DC3_OMR
R201: RC1206JR-07120RL; R1206
TP1: Vin Bat; Keystone_5001
TP2: 24V Bat; Keystone_5001
TP3: Vin Tether; Keystone_5001
TP4: 24V Tether; Keystone_5001
TP5: GND; Keystone_5001
TP6: Vout Drone; Keystone_5001
U201, U202: LMW78_24-0.3RL; OKI-78SR_Horizontal

Connections:
24V_Bat_G: C202.2, J201.1, K202.6, TP2.1 (TP), U201.3 (Vout)
24V_Tether_G: C204.2, J203.1, K202.8, TP4.1 (TP), U202.3 (Vout)
+Vin_Drone_G: J204.1, J204.2, J204.3, J204.4, J204.5, K203.3, TP6.1 (TP)
+Vin_Tether_G: F202.1, F203.1, J202.1, K201.3, K203.2, TP3.1 (TP)
/PCB_Gauche/Relay_Active: D202.1, D203.1, K201.4, K202.9, K203.4
/PCB_Gauche/SCL: J204.6, J206.7
/PCB_Gauche/SDA: J204.7, J206.6
GND_G: C201.1, C202.1, C203.1, C204.1, D201.2, D202.2, D203.2, J202.2, J204.8, J204.9, J204.10, J204.11, J204.12, J205.1, J205.2, J205.3, J206.8, J206.9, J206.10, J206.11, J206.12, K201.5, K202.12, K203.5, TP5.1 (TP), U201.2 (GND), U202.2 (GND)
unnamed: D201.1, J203.2, K202.1
unnamed: F203.2, J205.4, J205.5, J205.6
unnamed: F204.2, J206.1, J206.2, J206.3, J206.4, J206.5
unnamed: J201.2, R201.2
unnamed: K201.1, K202.7, R201.1
unnamed: C201.2, F201.2, U201.1 (Vin)
unnamed: C203.2, F202.2, U202.1 (Vin)
Vin_Bat_G: F201.1, F204.1, K203.1, TP1.1 (TP)
