KevinLalonde/Power_Selector/(commit log)

2023-07-17 Ajout du projet KiCad et ded la librairie
    [Power Selector.kicad_pcb, Power Selector.kicad_sch]
2023-07-17 Ajout symbole MSD-DB01F-12P-V2.0 dans la librairy
2023-07-18 Ajout symbole et debut footprint MSD-DB01F-12P-V2.0 dans la librairy
2023-07-19 Ré-ajout de la librairie
    [100DPxT1B2M2xE.stp, 1050170001.STEP, 1694224.stp, 1694240.stp, 1935161.stp, 1935174.stp, 1935187.stp, 4-SMD.step]
2023-07-19 Ajout de tous les connecteurs
    [1720466_PXC.step, Power Selector.kicad_sch]
2023-07-19 Changements mineurs aux connections des connecteurs
    [Power Selector.kicad_sch]
2023-07-21 Ajout d'un relais et completion du circuit de controle
    [G6SK_2G.step, Power Selector.kicad_sch]
2023-07-21 Clarification de la schematic, ajout de commentaires
    [Power Selector.kicad_sch]
2023-07-23 Ajout du circuit de la tension de controle
    [Power Selector.kicad_sch]
2023-07-23 Finalisation du schema, en atttente d'un design review, PCB pret a commencer a etre routé
    [Power Selector.kicad_pcb, Power Selector.kicad_sch]
2023-07-23 Update footprint connecteur batterie/drone
2023-07-24 Debut routing
    [Power Selector.kicad_pcb, Power Selector.kicad_sch]
2023-07-24 Fix du bug github, devrait etre la bonne version
    [Power Selector.kicad_pcb, Power Selector.kicad_sch]
2023-07-24 Ajout des deux PCB (droit et gauche) sur le meme PCB
    [PCB_Droit.kicad_sch, PCB_Gauche.kicad_sch, Power Selector.kicad_pcb, Power Selector.kicad_sch]
2023-07-24 Premier commit pour routing PCB. Modif footprint connecteur batterie.
    [PCB_Droit.kicad_sch, PCB_Gauche.kicad_sch, Power Selector.kicad_pcb]
2023-07-25 Routing PCB gauche. Prêt pour review 1.
    [Power Selector.kicad_pcb]
2023-07-25 Ajout testpoints au schéma et PCB. Ajout de commentaires sur le silkscreen.
    [PCB_Gauche.kicad_sch, Power Selector.kicad_pcb]
2023-07-26 Fix region fills, add missing scl/sda traces & fix pad connections
    [Power Selector.kicad_pcb]
2023-08-01 Modif apportées à la grosseur des trous minimum pour respecter les contraintes de fabrication de l'ÉTS. Aucune erreur de DRC, seulement des warnings de silkscreen qui overlap, not an issue.
    [Power Selector-B_Cu.gbr, Power Selector-B_Mask.gbr, Power Selector-B_Paste.gbr, Power Selector-B_Silkscreen.gbr, Power Selector-Edge_Cuts.gbr, Power Selector-F_Cu.gbr, Power Selector-F_Mask.gbr, Power Selector-F_Paste.gbr]
2023-08-22 Ajout rapports finaux.
    [Power Selector.kicad_pcb]
